suzizecat/defissolaire-v4/proto/power_supply/png/power_supply.png

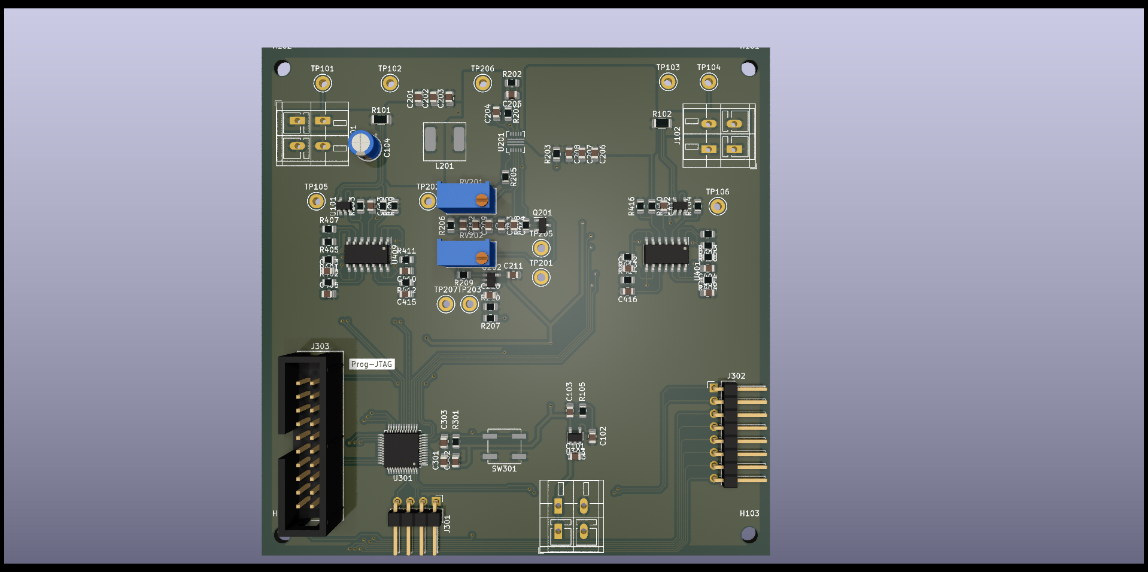
proto/power_supply/png/power_supply.png
