suzizecat/defissolaire-v4/README.md

# All-in-one (AIO) board for the "Défis solaires" contest of 2024.
Board files in `main/` folder.
