suzizecat/defissolaire-v4/dossier/defis_solaire_v4/dos/content.tex

% \input your content here.
\input{content/features.tex}
\input{content/power_archi.tex}
\input{content/solutions_selection.tex}
