suzizecat/defissolaire-v4/dossier/defis_solaire_v4/dos/refs/glossaries.tex

\newglossaryentry{dsn}{
    name={design},
    description={A particularly mighty piece of silicon which is supposed to work}
}

\newacronym{adc}{ADC}{Analog to Digital Converter}
\newacronym{sar}{SAR}{Successive Approximation Register}  
\newacronym{fsm}{FSM}{Finite State Machine}
\newacronym{cdc}{CDC}{Clock Domain Crossing}
\newacronym{msb}{MSB}{Most Significant Bit}
\newacronym{lsb}{LSB}{Least Significant Bit}
