suzizecat/defissolaire-v4/dossier/propo_regu_mppt.pdf

# Régulation d'alimentation

## Objectif final

L'objectif est la conception d'une alimentation DC/DC avec un MPPT pour un panneau de 14 cellules SunPower C60 montées en série.

L'accumulation d'énergie se fait sur une banque de condensateurs d'environ 10F pour une tension admissible de 20V.

Grandeur | Cellule | Panneau
VMPP | 0.574 | 8.036
IMPP | 5.83 | 5.83
PMPP | 3.34 | 46.85

## Proposition

Afin de réaliser cette fonction, je propose l'utilisation d'un régulateur boost synchrone (Référence TPS61178, U1 ). La tension de sortie de ce module est ajustable via un pont diviseur ( R5 et R3 ) dont la tension du point milieu sera ajustée à 1.2V . Le courant consommé par le pin FB ( U1:5 ) est négligeable (moins de 60nA).

Pour ajuster (élever) la tension de sortie par rapport à la tension par défaut du pont diviseur proposé (8.4V), je propose l'utilisation d'un transistor bipolaire Q1 pour "consommer" (sink) 1mA sur le point milieu ce qui, avec une résistance côté haut de 12k, correspond à une
élévation de 12V de | .
En admettant une tension | maximale de 1.66V pour 1mA consommé et en considérant la
tension | = 0.66 V du transistor Q1 , on a en principe :

VFB

VOUT

VOUT

VADJ

VBE

IC = β × IB

IC = β ×
R4

VADJ − VBE

R4 = β ×
IC

1.66 − 0.66

R4 = β × 1000

Donc, pour | on a | avec un courant | maximal inferieur à
2.5 A

D'un point de vue fréquence de mise à jour de la consigne, on peut supposer une fréquence lente vis à vis des fréquences de fonctionnement du régulateur. Par exemple, maximum, 1kHz (à comparer aux 200kHz-2MHz du switching).

## Problèmes potentiels

Est-ce que cette architecture est pertinente ?

Est-il possible/pertinent d'utiliser un BJT pour cette application, notemment lorsque des courants aussi faibles sont en jeu ?

Quelles seraient les précautions à prendre, notamment sur les paramètres du BJT et/ou de l'AOP ?

β ∈ [200; 400] | R4 ∈ [200e3; 400e3] | IB
μ

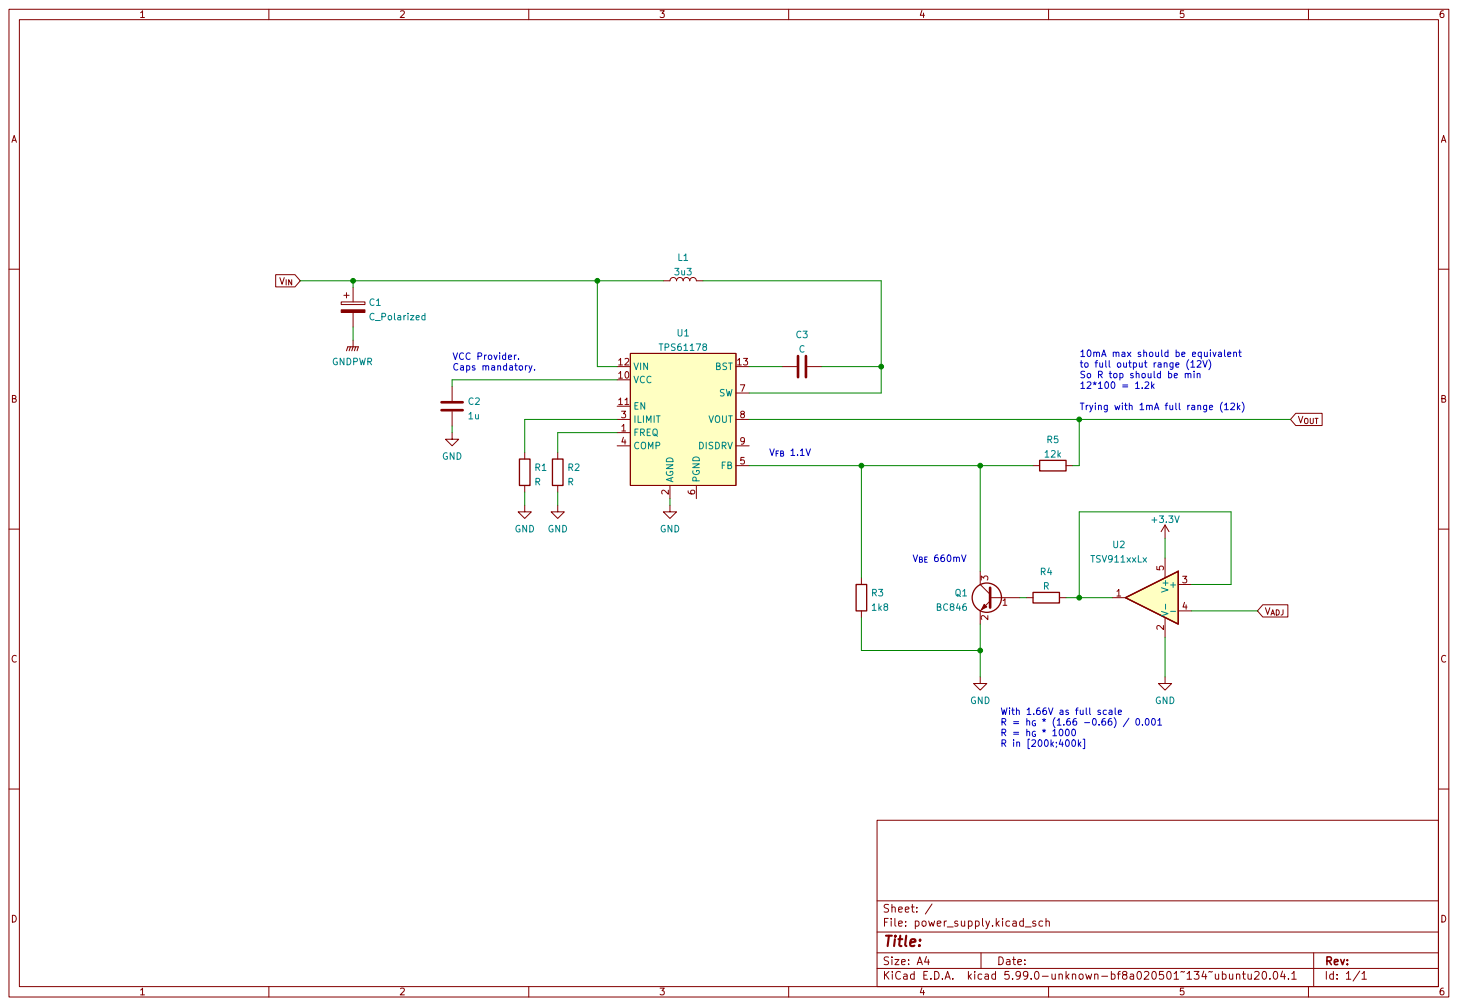
[picture p2: page 3]

10mA max should be equivalent
to full output range (12V)
So R top should be min 12*100 = 1.2k Trying with 1mA full range (12k)
