suzizecat/defissolaire-v4/dossier/alimentations/macros.tex

\newcommand{\drvcc}{\ensuremath{\mathrm{DRV_{CC}}}\xspace}
\newcommand{\intvcc}{\ensuremath{\mathrm{INTV_{CC}}}\xspace}
\newcommand{\bgate}{\ensuremath{\mathrm{BGATE}}\xspace}
\newcommand{\vdrv}{\ensuremath{\mathrm{V_{DRV}}}\xspace}
\newcommand{\vout}{\ensuremath{\mathrm{V_{OUT}}}\xspace}
\newcommand{\vin}{\ensuremath{\mathrm{V_{IN}}}\xspace}
\newcommand{\iin}{\ensuremath{\mathrm{I_{IN}}}\xspace}

\newcommand{\driver}{TPS4306x\xspace}
\newcommand{\mosfet}{TK4R3E06PL\xspace}

\newcommand{\fsw}{\ensuremath{\mathnormal{f_{sw}}}\xspace}
\newcommand{\csw}{\ensuremath{\mathnormal{C_{sw}}}\xspace}
\newcommand{\isw}{\ensuremath{\mathnormal{I_{sw}}}\xspace}
\newcommand{\iswavg}{\ensuremath{\overline{\mathnormal{I_{sw}}}}\xspace}
\newcommand{\psw}{\ensuremath{\mathnormal{P_{sw}}}\xspace}

\newcommand{\trise}{\ensuremath{\mathnormal{t_{R}}}\xspace}
\newcommand{\qsw}{\ensuremath{\mathrm{Q_{sw}}}\xspace}
\newcommand{\rdson}{\ensuremath{\mathrm{R_{DS(on)}}}\xspace}
\newcommand{\rgate}{\ensuremath{\mathrm{R_{G}}}\xspace}
\newcommand{\rdrv}{\ensuremath{\mathrm{R_{DRV}}}\xspace}
