suzizecat/defissolaire-v4/dossier/poulpator.png

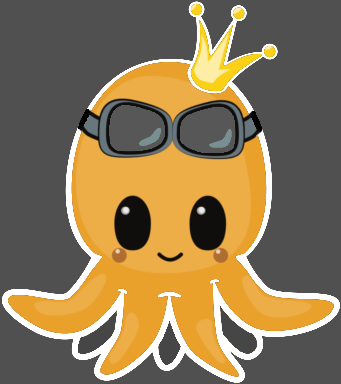
dossier/poulpator.png
