suzizecat/defissolaire-v4/main/bom-ordered/JFAR-BOM-DSv4.xlsx

Reference | Value | Qty | Mouser SKU | MPN
BZ601 | PKLCS1212E4001-R1 | 1 | 81-PKLCS1212E4001 | PKLCS1212E4001-R1
C201,C416 | 4.7u | 2 | 187-CL21B475KAFNNNE | CL21B475KAFNNNE
C202,C203,C205,C209,C409,C417,C501,C502,C503,C504,C505,C603,C901,C1001,C1101,C1201,C1301,C1401,C1501,C1601 | 100n | 20 | 187-CL21B104KACNFNC | CL21B104KACNFNC
C204,C211,C301,C302,C304,C305,C306,C307,C401,C402,C403,C404,C405,C406,C408 | 10u | 21 | 187-CL21A106KBYQNNE | CL21A106KBYQNNE
C206,C207 | 22u | 2 | 187-CL21A226MAYNNWE | CL21A226MAYNNWE
C208,C903,C1003,C1103,C1203,C1303,C1403 | 1u | 7 | 187-CL21B105KLFVPNE | CL21B105KLFVPNE
C210 | 10n | 1 | 187-CL21B103KCANNND | CL21B103KCANNND
C303,C308,C407 | 220u | 5 | 80-A759KR227M1VAAE24 | A759KR227M1VAAE024
C309,C310,C410,C411 | 2.2u | 6 | 187-CL21B225KBYNNWE | CL21B225KBYNNWE
C312,C412 | 68n | 3 | 187-CL21B683KBCWPNC | CL21B683KBCWPNC
C313,C413 | 100p | 3 | 187-CL21C101JBANNND | CL21C101JBANNND
C314,C414 | 680n | 3 | 187-CL21B684JOFNNNE | CL21B684JOFNNNE
C315,C415 | 4.7n | 3 | 187-CL21C472JAFNNNE | CL21C472JAFNNNE
C506,C507 | 18p | 2 | 81-GRM21A5C2J180FWAD | GRM21A5C2J180FWA1D
D401,D402,D403,D404,D901,D902,D1001,D1002,D1101,D1102,D1201,D1202,D1301,D1302,D1401,D1402 | B5819W-TP | 16 | 833-B5819W-TP | B5819W-TP
J1701,J1801 | Conn_02x08_Odd_Even | 5 | 538-22-28-4162 | 22-28-4162
J608 | USB_B_Micro | 1 | 538-47346-0001 | 47346-0001
L201 | 6.8u | 1 | 810-VLS3015CX6R8M1 | VLS3015CX-6R8M-1
L301 | 10u | 2 | 994-MSD1514-103MED | MSD1514-103MED
L401 | 4.7u | 1 | 994-MSD1260T-472MLD | MSD1260T-472MLD
Q301,Q401 | IXTP28P065T | 3 | 747-IXTP28P065T | IXTP28P065T
Q302,Q402,Q901,Q902,Q1001,Q1002,Q1101,Q1102,Q1201,Q1202,Q1301,Q1302,Q1401,Q1402 | TK4R3E06PL | 15 | 757-TK4R3E06PLS1X | TK4R3E06PL
Q403,Q406,Q601,Q1501,Q1601 | IRLML0030 | 5 | 942-IRLML0030TRPBF | IRLML0030TRPBF
Q404,Q405 | FDS6681Z | 2 | 512-FDS6681Z | FDS6681Z
R201,R206,R415 | 33k | 3 | 71-CRCW0805-33K-E3 | CRCW080533K0FKEA
R202,R416 | 5.6k | 2 | 71-CRCW08055K60FKEA | CRCW08055K60FKEA
R203,R205 | 150k | 3 | 71-CRCW0805-150K-E3 | CRCW0805150KFKEA
R207 | 20k | 1 | 71-CRCW0805-20K-E3 | CRCW080520K0FKEA
R301,R402 | 6m | 3 | 71-WSL20106L000FEA | WSL20106L000FEA
R302 | 3m | 2 | 71-WSL20103L000FEA | WSL20103L000FEA
R303,R403 | 18k | 3 | 71-CRCW080518K0FKEA | CRCW080518K0FKEA
R304,R407,R408 | 4.7k | 4 | 71-CRCW0805-4.7K-E3 | CRCW08054K70FKEA
R305 | 200k | 2 | 71-CRCW0805-200K-E3 | CRCW0805200KFKEA
R307,R410 | 120k | 3 | 71-CRCW0805120KFKEA | CRCW0805120KFKEA
R309,R412 | 22k | 3 | 71-CRCW0805-22K-E3 | CRCW080522K0FKEA
R401 | 18m | 1 | 71-WSL2010R0180FEA | WSL2010R0180FEA
R404,R406 | 68k | 2 | 71-CRCW080568K0FKEAC | 71-CRCW080568K0FKEAC
R405,R409,R413,R414,R501,R502 | 10k | 6 | 71-CRCW0805-10K-E3 | CRCW080510K0FKEA
R503,R1501,R1502,R1503,R1504,R1505,R1506,R1601,R1602,R1603,R1604,R1605,R1606 | 3k3 | 13 | 71-CRCW0805-3.3K-E3 | CRCW08053K30FKEA
R601,R605,R606 | 1k | 3 | 71-CRCW0805-1.0K-E3 | CRCW08051K00FKEA
R602,R901,R902,R1001,R1002,R1101,R1102,R1201,R1202,R1301,R1302,R1401,R1402,R1507,R1607 | 100k | 15 | 71-CRCW0805-100K-E3 | CRCW0805100KFKEA
R603,R604 | 27 | 2 | 71-CRCW080527R0FKEA | CRCW080527R0FKEA
RV301,RV401 | 100k (10k) | 3 | 652-3296W-1-104LF | 3296W-1-104LF
SW501 | B3SL-1022P | 1 | 653-B3SL-1022P | B3SL-1022P
U201,U403 | TSV911xxLx | 3 | 511-TSV911ILT | TSV911ILT
U202 | LMR51430 | 1 | 595-LMR51430XDDCR | LMR51430XDDCR
U203 | LDK130M33R | 1 | 511-LDK130M33R | LDK130M33R
U301,U401 | LT8710 | 3 | 584-LT8710IFE#PBF | LT8710IFE#PBF
U402 | TMCS1101 | 1 | 595-TMCS1101A3UQDRQ1 | TMCS1101A3UQDRQ1
U501 | STM32L476RGTx | 2 | 511-STM32L476RGT6 | STM32L476RGT6
U601 | FT230XQ | 1 | 895-FT230XQ-R | FT230XQ-R
U901,U1001,U1101,U1201,U1301,U1401 | LM2105 | 6 | 595-LM2105DSGR | LM2105DSGR
Y501 | 8MHz | 1 | 520-80-18-30-JGM-TR | ECS-80-18-30-JGM-TR
