suzizecat/defissolaire-v4/librairies/3d/PKLCS1212E4001-R1--3DModel-STEP-56544.STEP

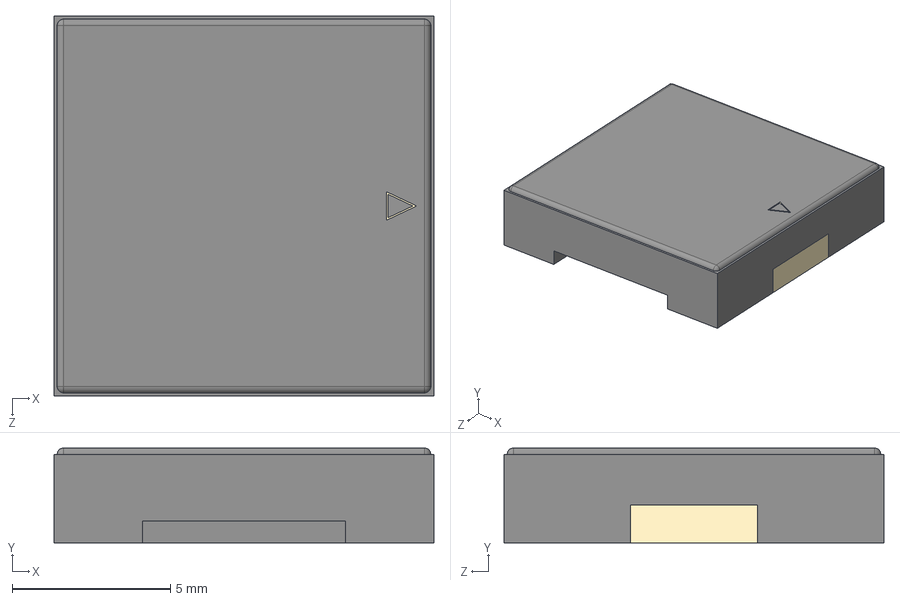
[picture p4: CAD file, 2024-04-25]
librairies/3d/PKLCS1212E4001-R1--3DModel-STEP-56544.STEP
12.0 x 3.00 x 12.0 mm
