suzizecat/defissolaire-v4/librairies/3d/Coilcraft-MSD1260T.step

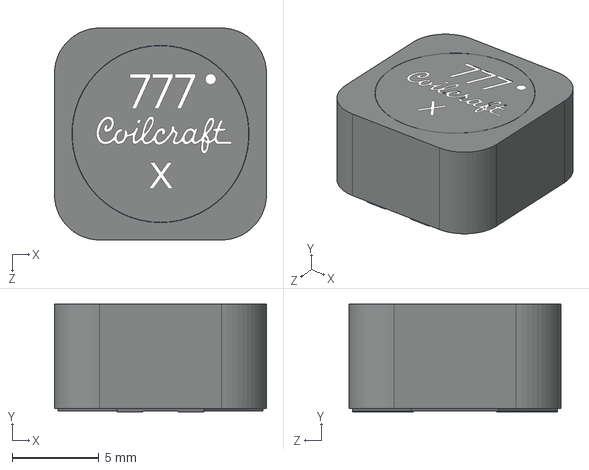
[picture p5: CAD file, 2024-04-25]
librairies/3d/Coilcraft-MSD1260T.step
12.2 x 6.20 x 12.2 mm
