suzizecat/defissolaire-v4/librairies/3d/236-402.stp

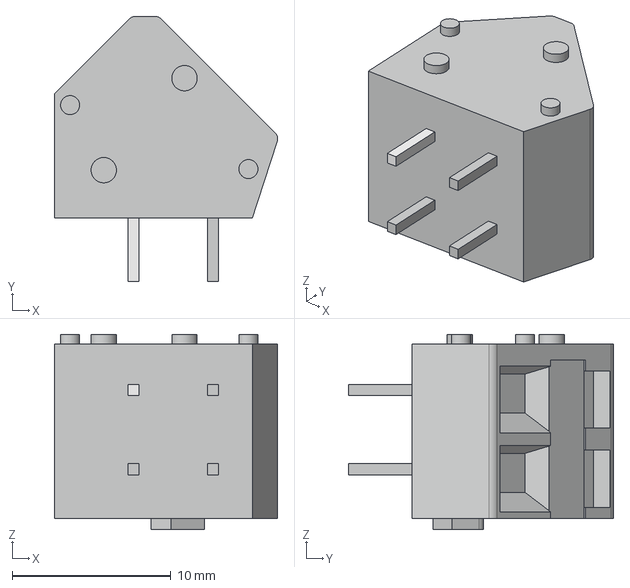
[picture p6: CAD file, 2023-03-29]
librairies/3d/236-402.stp
14.1 x 16.7 x 12.3 mm
