suzizecat/defissolaire-v4/librairies/3d/RTE0016E.stp

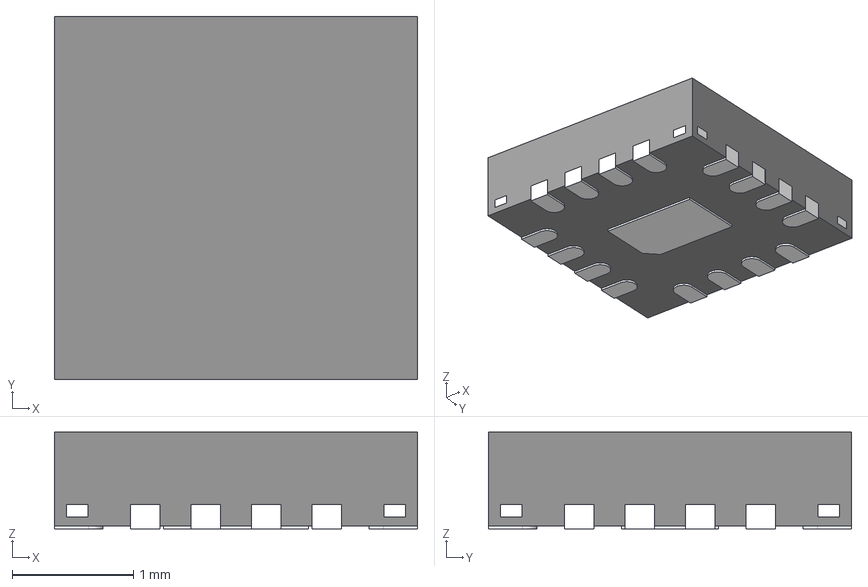
[picture p7: CAD file, 2023-03-29]
librairies/3d/RTE0016E.stp
3.00 x 3.00 x 0.8 mm
FRAME
