suzizecat/defissolaire-v4/pdf/defis_solaires_v4.pdf

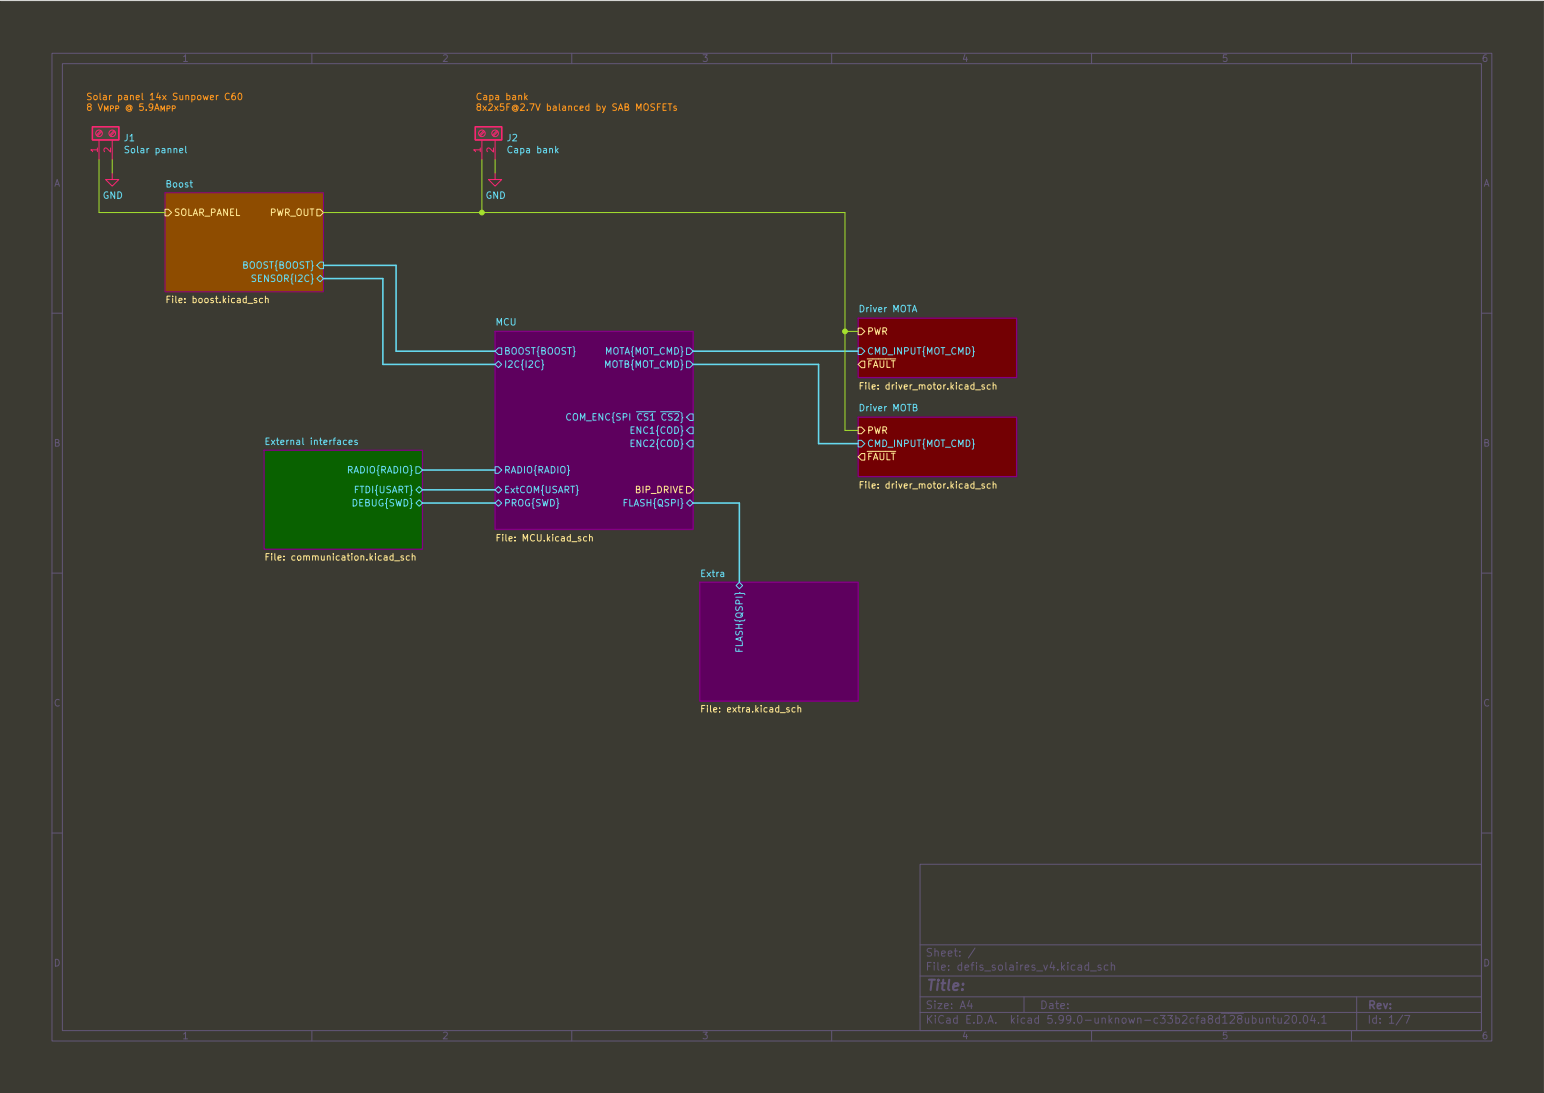
[picture p8: page 1]

Capa bank
8x2x5F@2.7V balanced by SAB MOSFETs

~FAULT~ Extra File: extra.kicad_sch FLASH{QSPI} MCU

MOTB{MOT_CMD} External interfaces File: communication.kicad_sch FTDI{USART}

RADIO{RADIO}
ExtCOM{USART}
File: MCU.kicad_sch PROG{SWD}

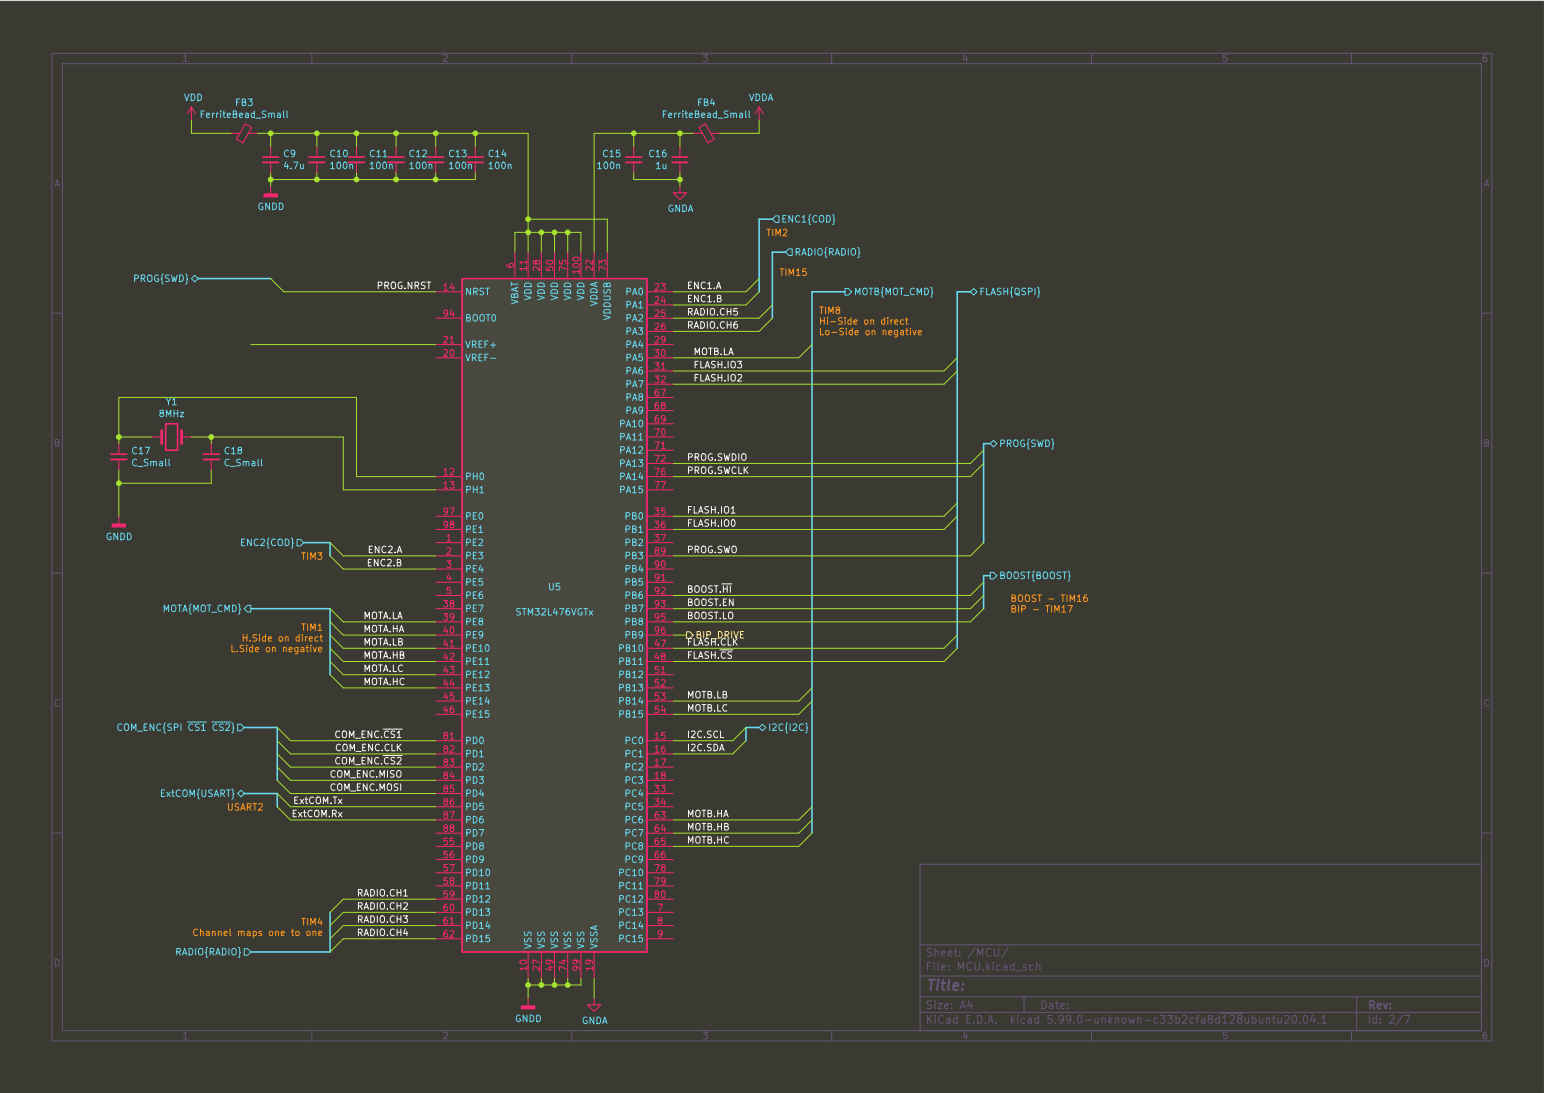
[picture p9: page 2]

FLASH.IO2 FLASH.IO3 PROG.SWCLK

TIM4 Channel maps one to one TIM1 H.Side on direct L.Side on negative

FLASH.IO0 FLASH.IO1 MOTA.LC

BOOST.EN MOTA.HB MOTA.LB MOTA.HA MOTA.HC

File: MCU.kicad_sch Sheet: /MCU/
Id: 2/7 Title:

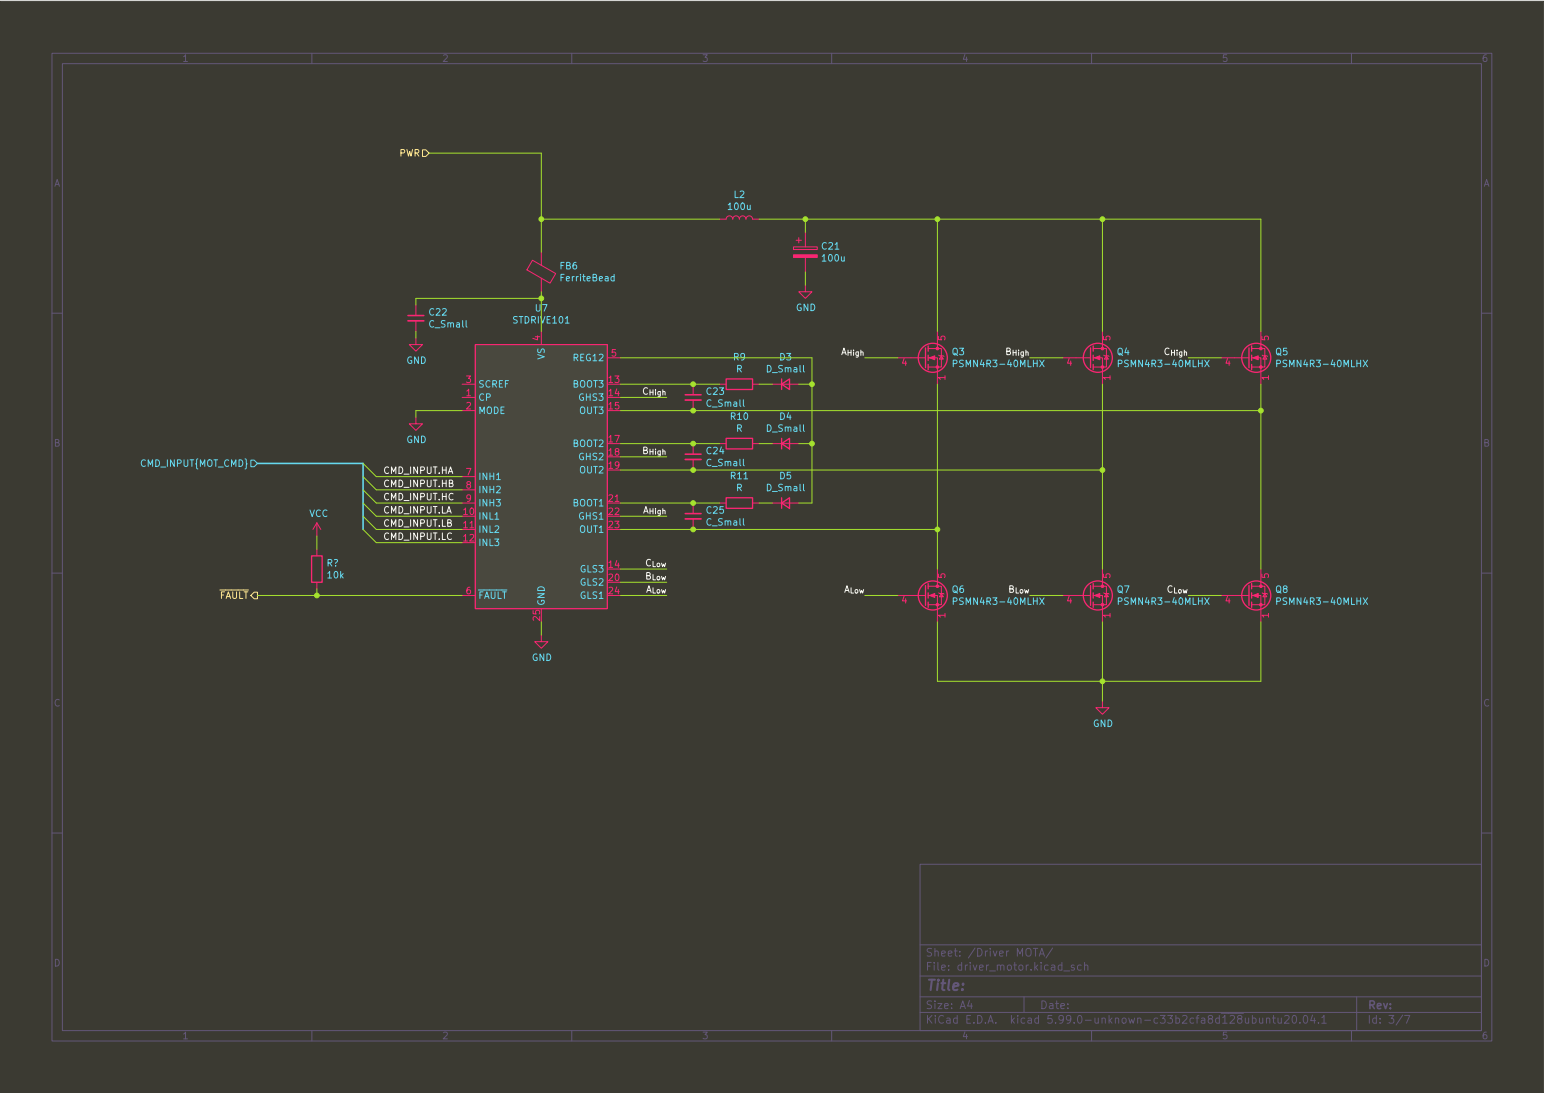
[picture p10: page 3]

File: driver_motor.kicad_sch Sheet: /Driver MOTA/
Id: 3/7 Title:

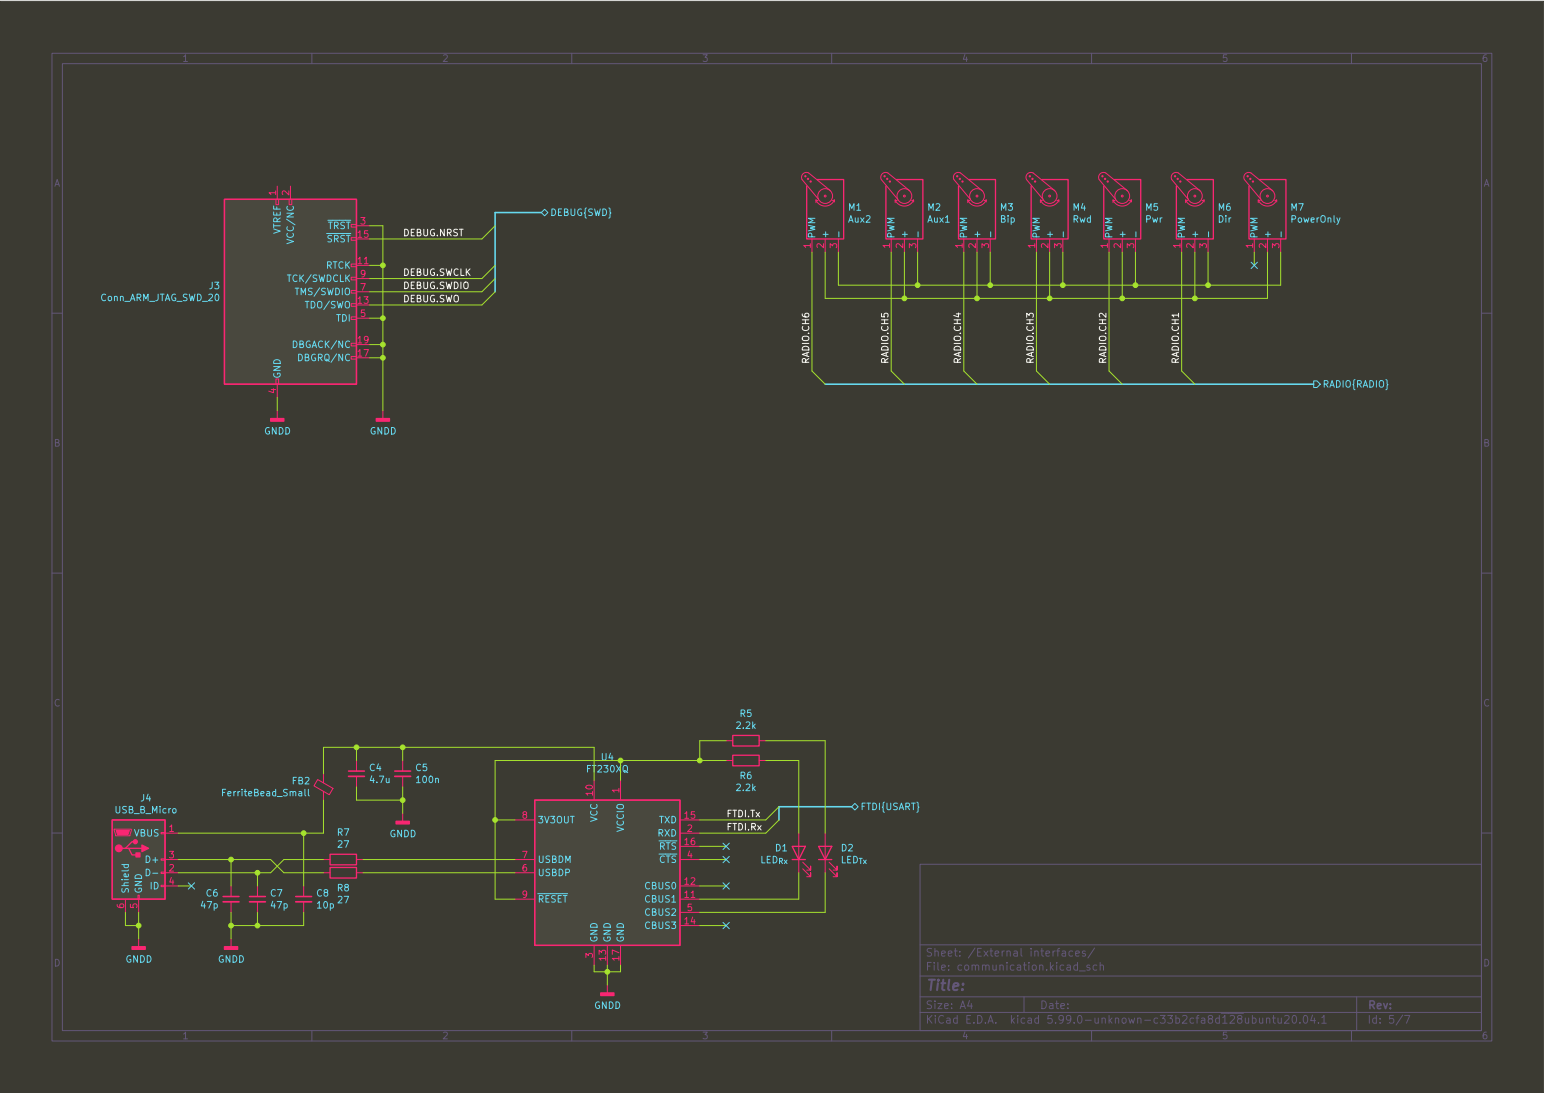
[picture p11: page 4]

1 RTCK 11 TDO/SWO 13 ~SRST~15 DBGRQ/NC 17 DBGACK/NC 19 VCC/NC

4 TDI 5 TMS/SWDIO 7 TCK/SWDCLK 9

1 VCC 10 CBUS1 11 CBUS0 12 GND 13 CBUS3 14 TXD 15 ~RTS 16 GND 17 RXD 2 GND

FTDI.Tx FTDI.Rx

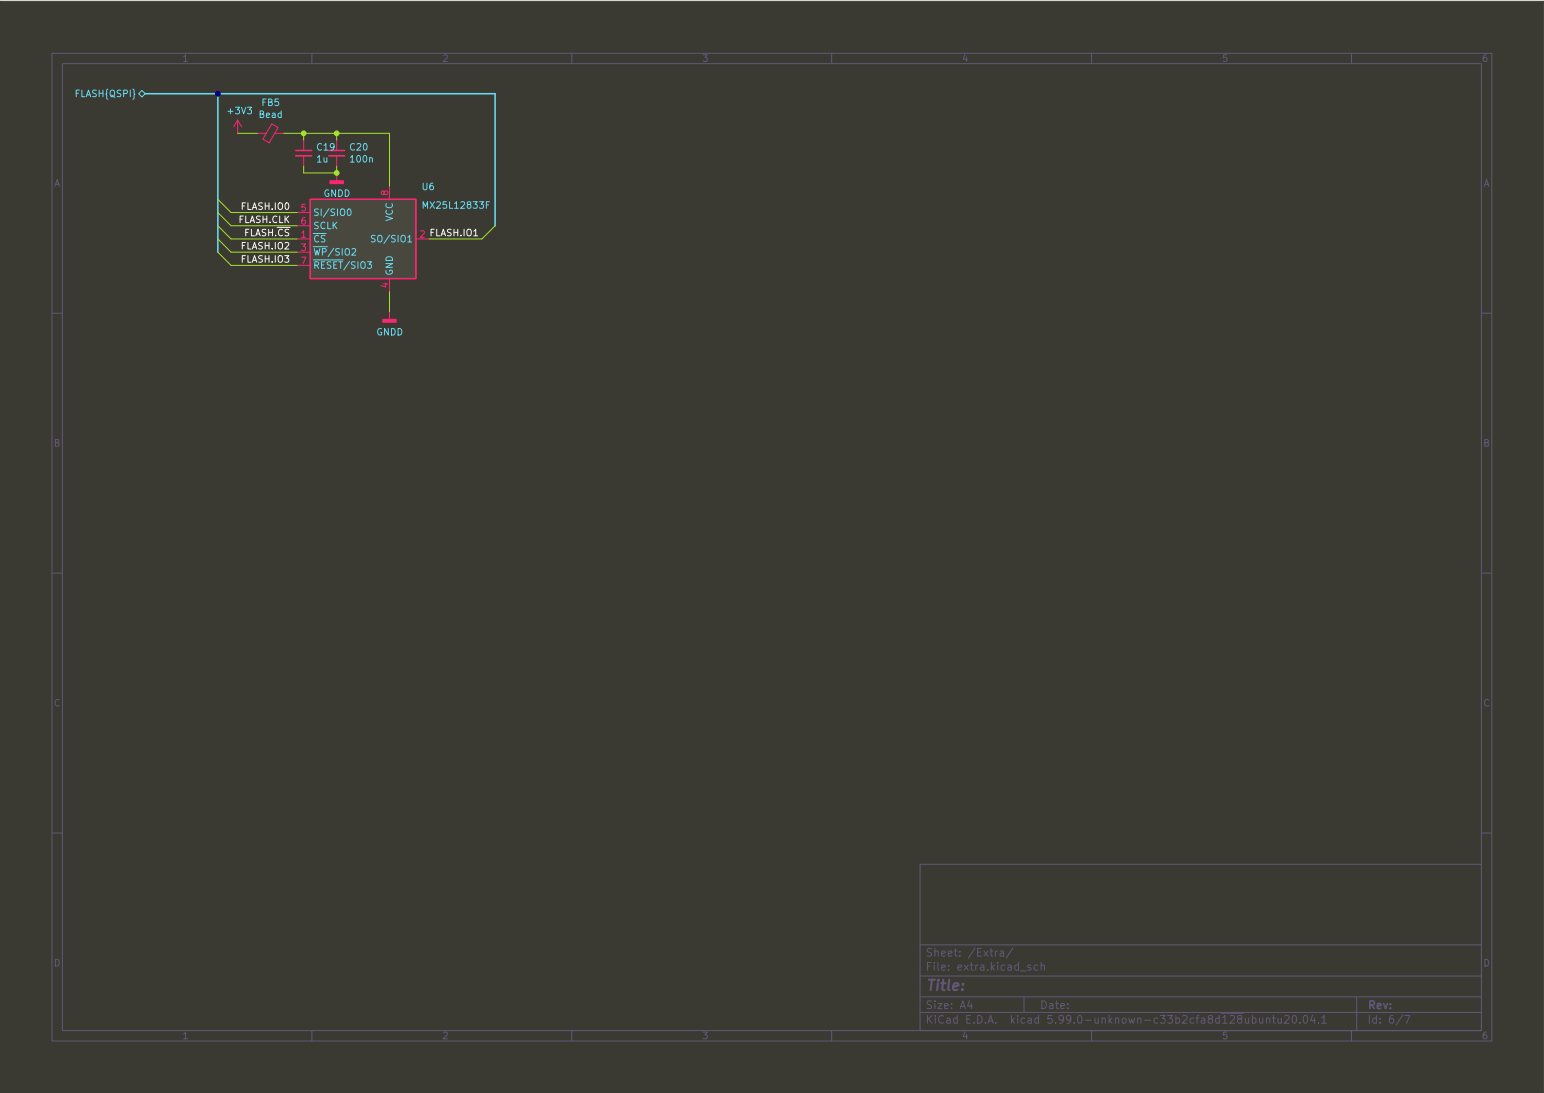
[picture p12: page 5]

4 SI/SIO0 5 SCLK 6 ~RESET~/SIO3 7 VCC

File: extra.kicad_sch Sheet: /Extra/
Id: 6/7 Title:

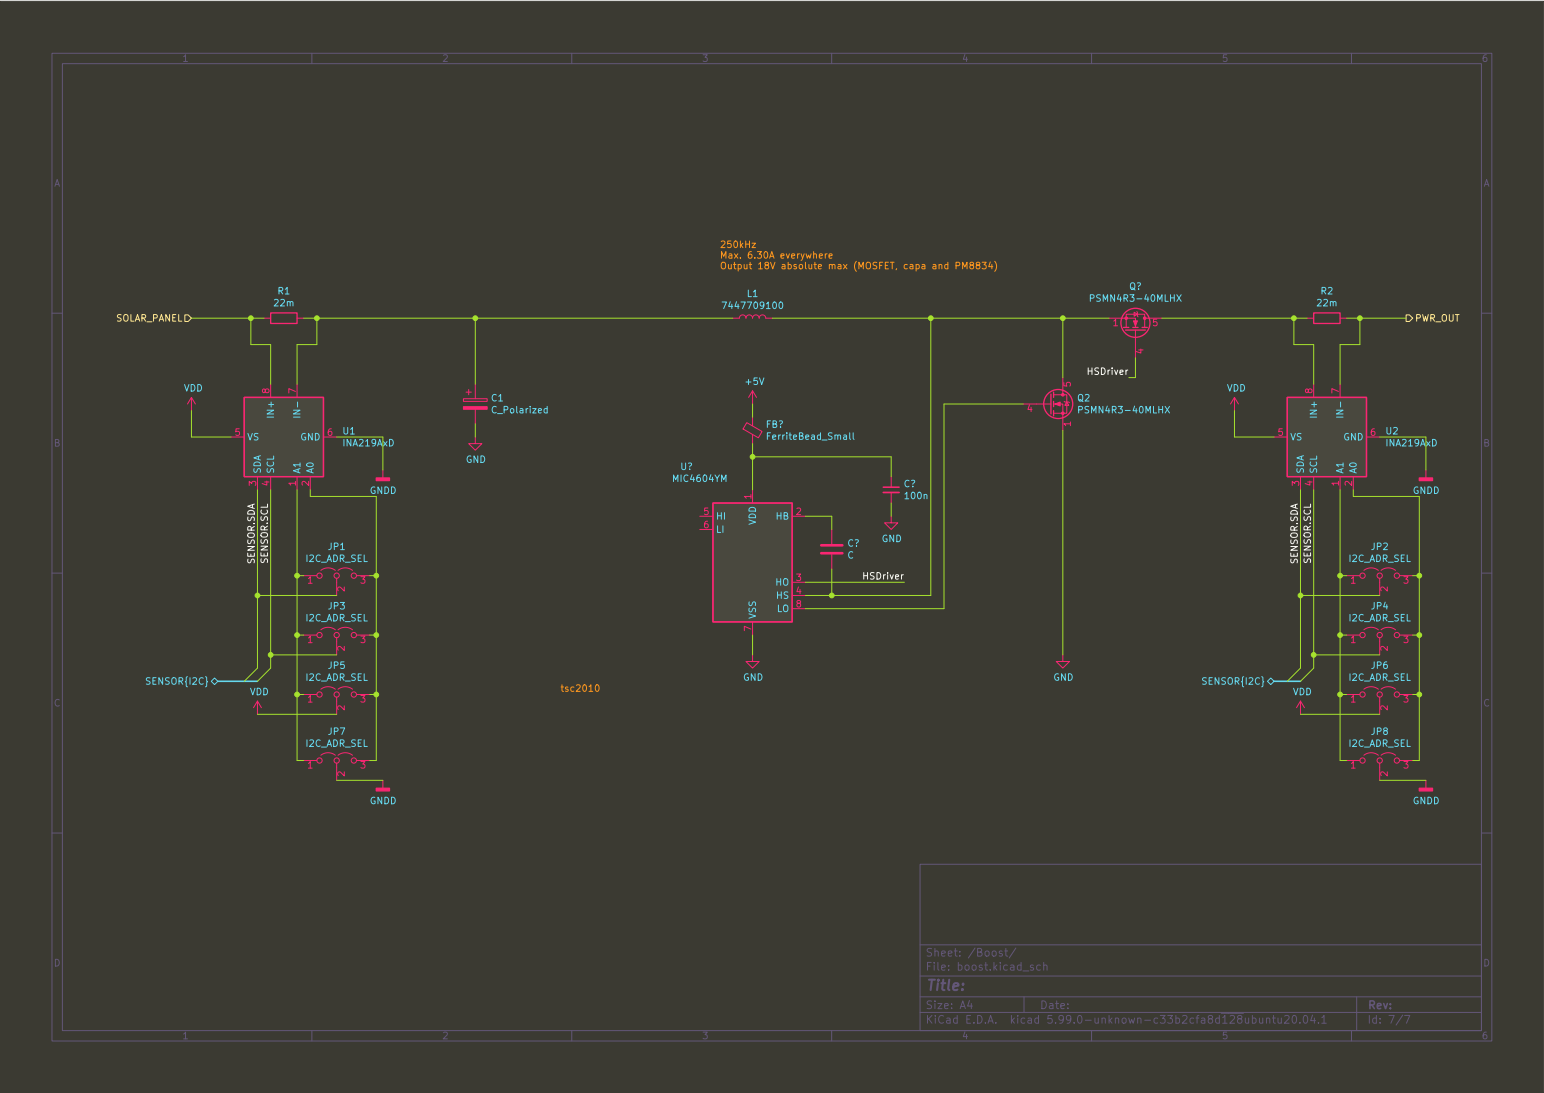
[picture p13: page 6]

Output 18V absolute max (MOSFET, capa and PM8834)

4 VS 5 GND 6 IN- 7 IN+

File: boost.kicad_sch Sheet: /Boost/
Id: 7/7 Title:

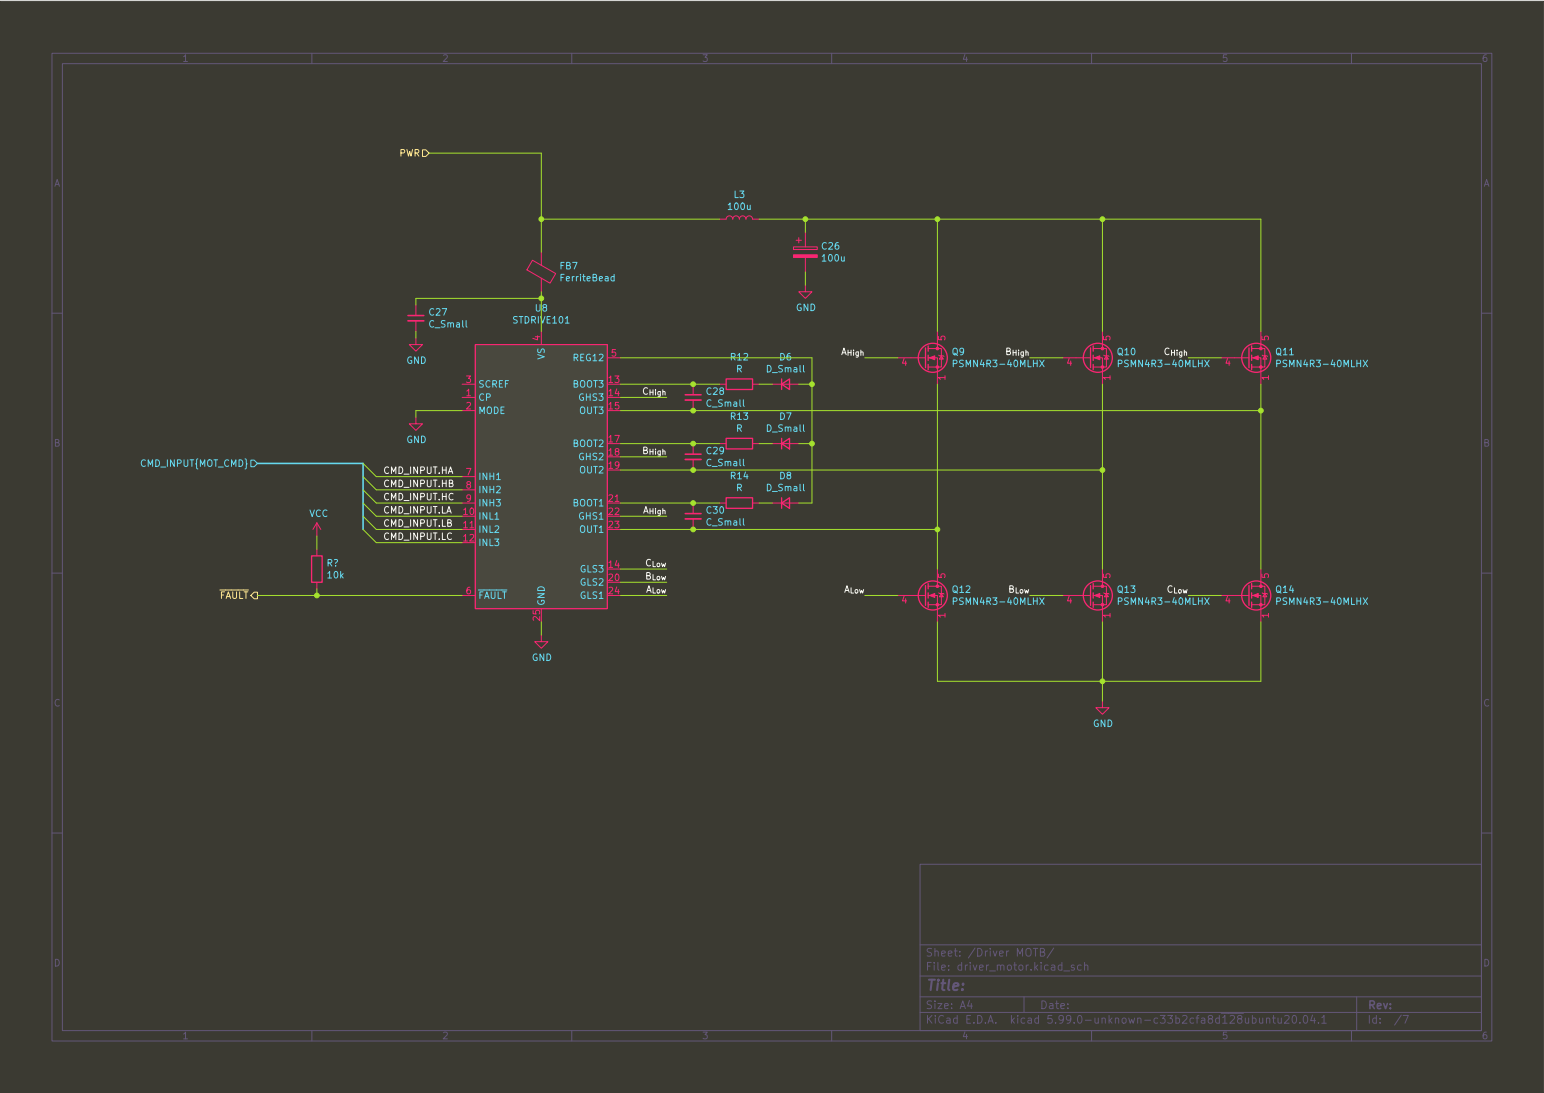
[picture p14: page 7]

File: driver_motor.kicad_sch Sheet: /Driver MOTB/
Id: /7 Title:
