suzizecat/defissolaire-v4/main/pdf/dsv4.pdf

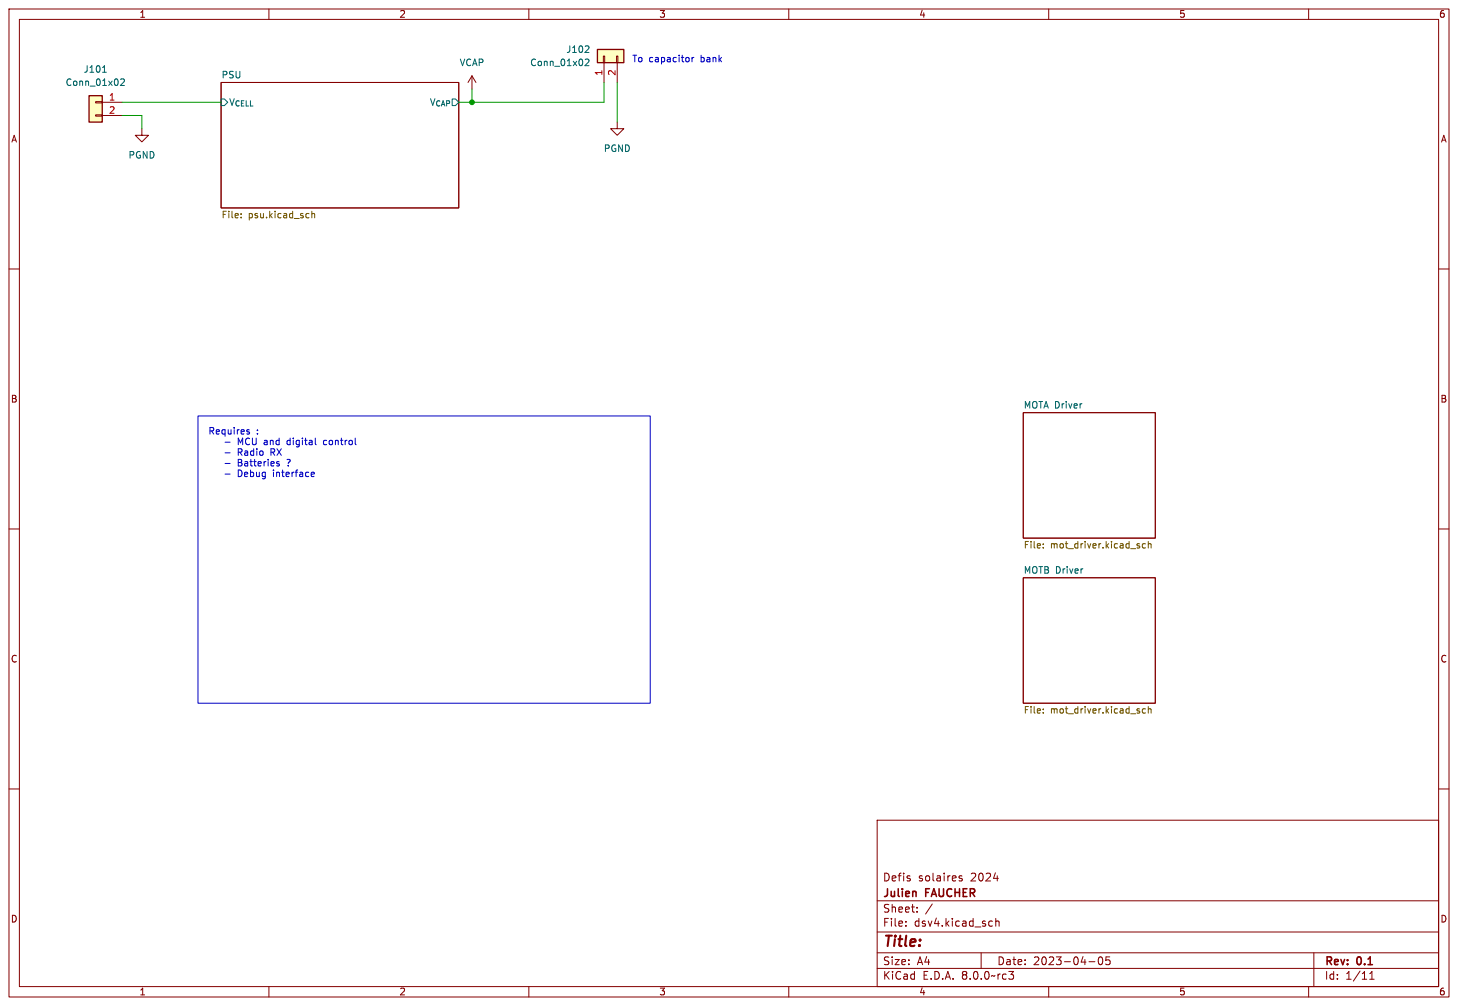
[picture p15: page 1]

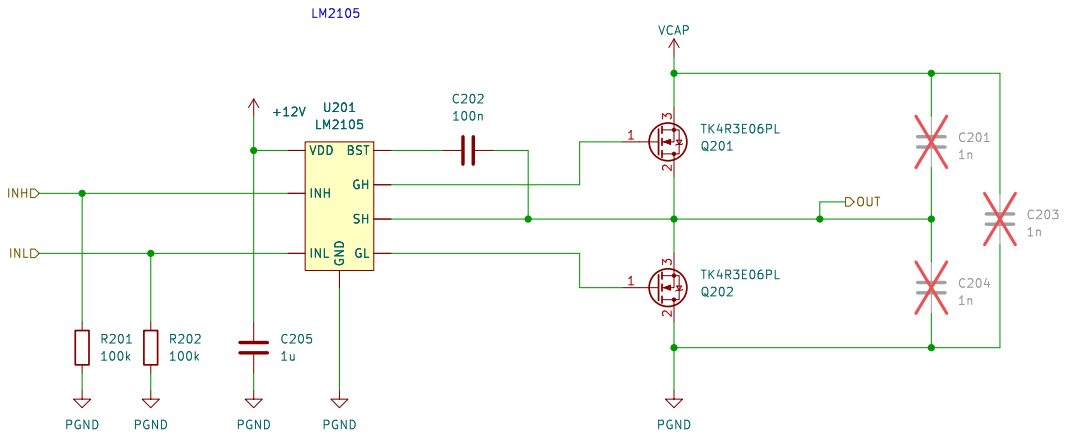
[picture p16: page 2]

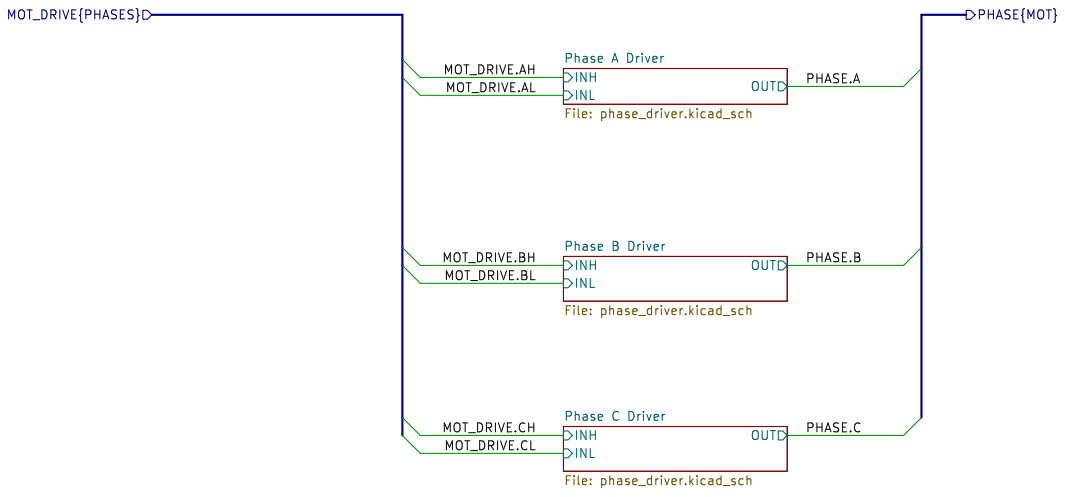
[picture p17: page 3]

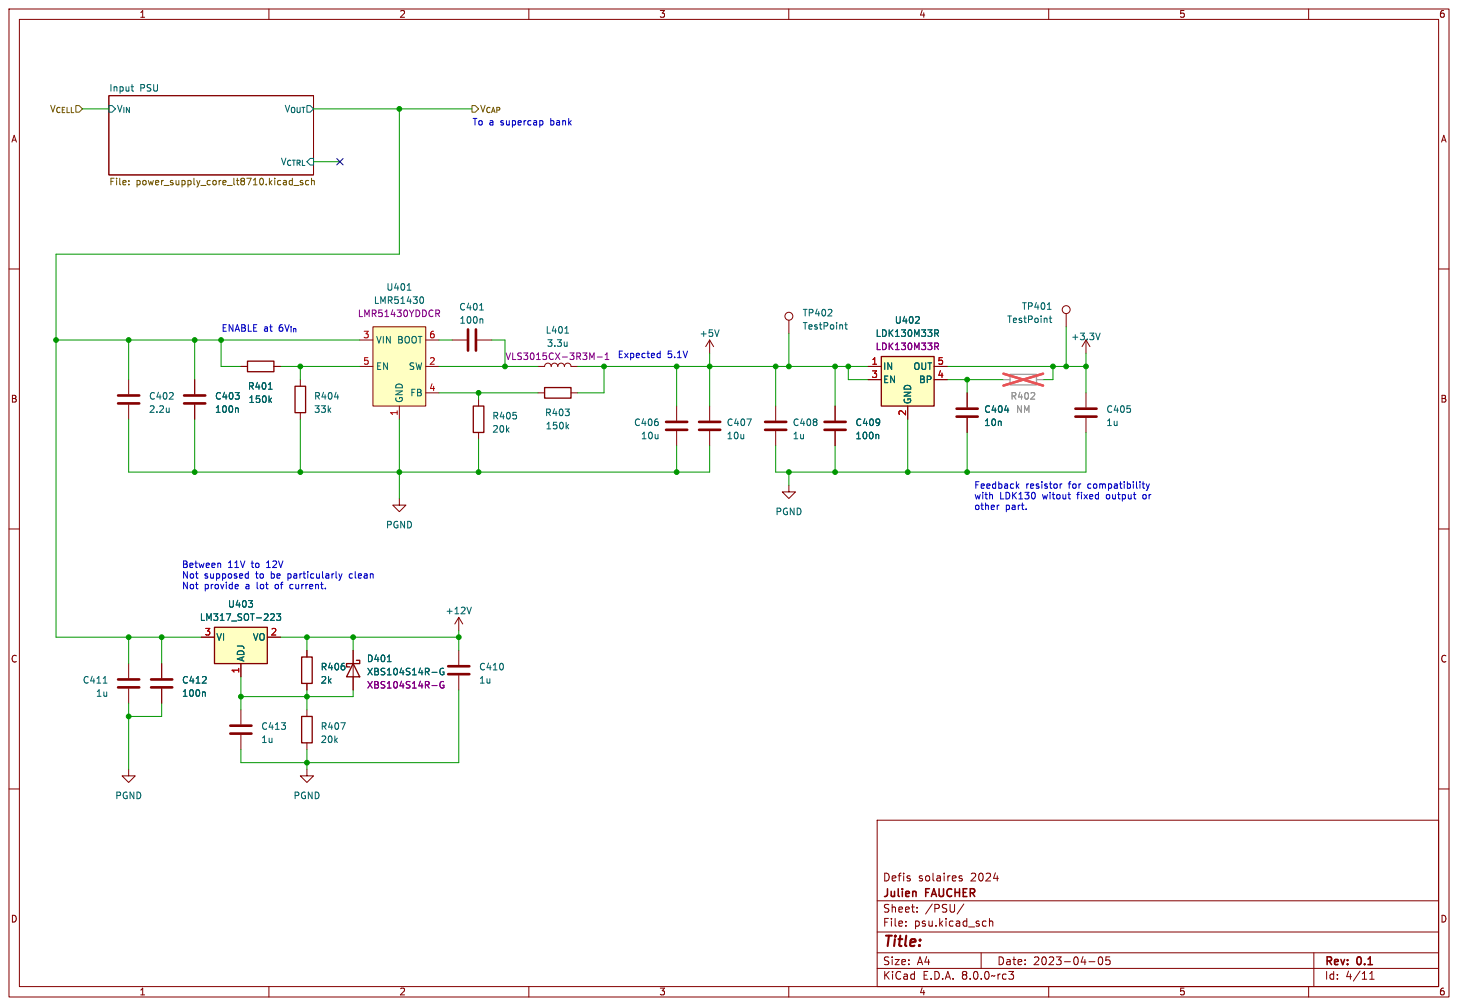
[picture p18: page 4]

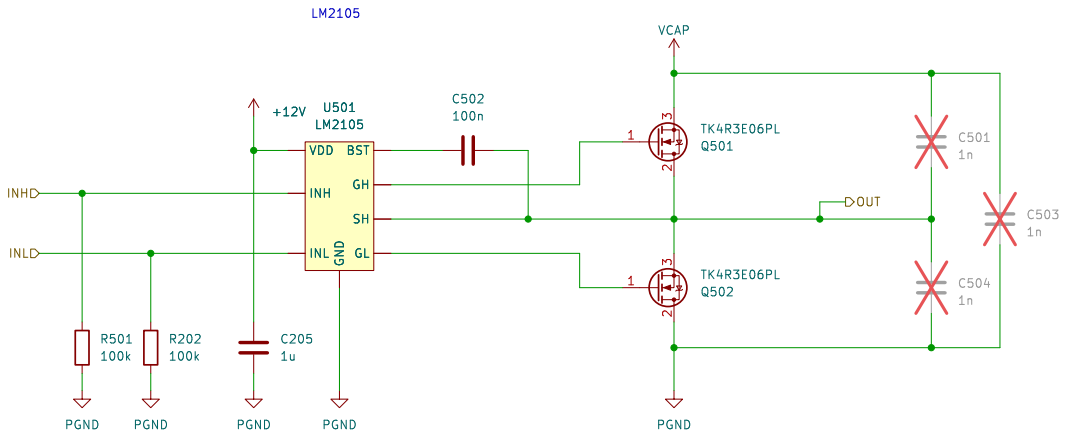
[picture p19: page 5]

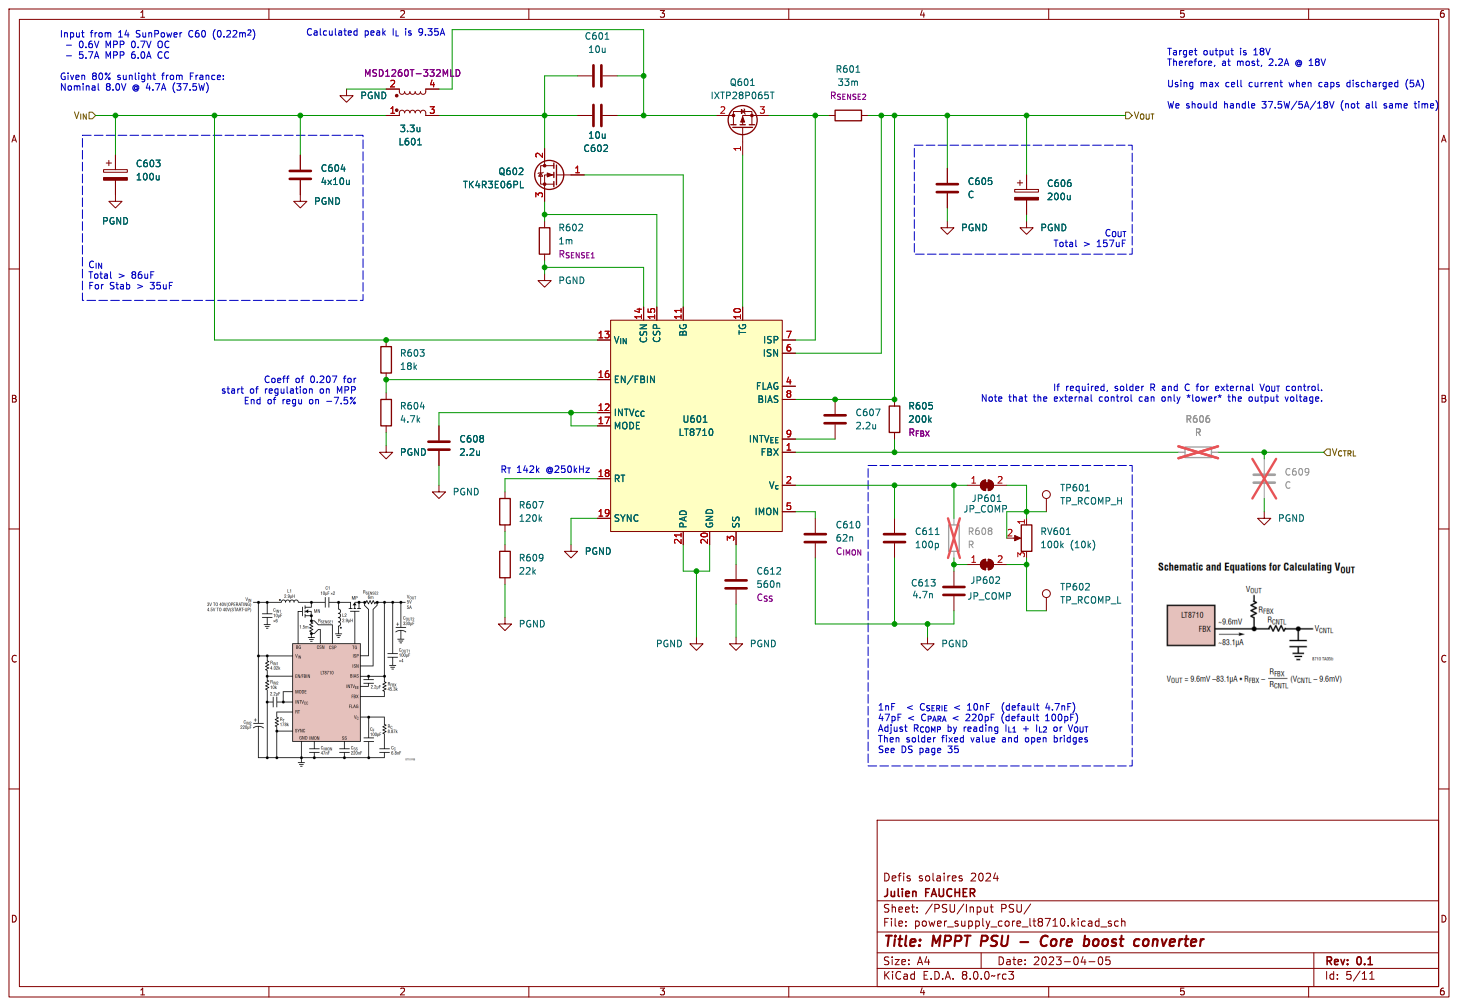
[picture p20: page 6]

End of regu on -7.5%

Adjust R_{COMP} by reading I_{L1}+ I_{L2}or V_{OUT} Then solder fixed value and open bridges See DS page 35

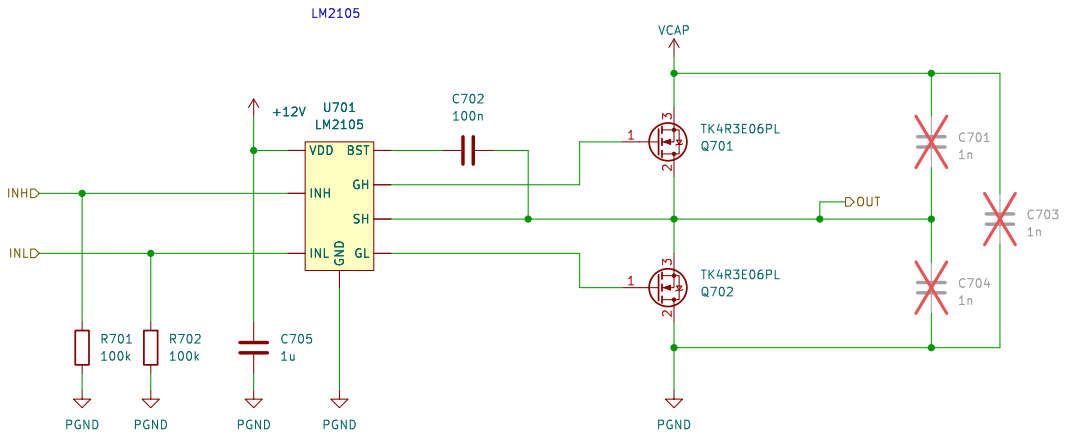
[picture p21: page 7]

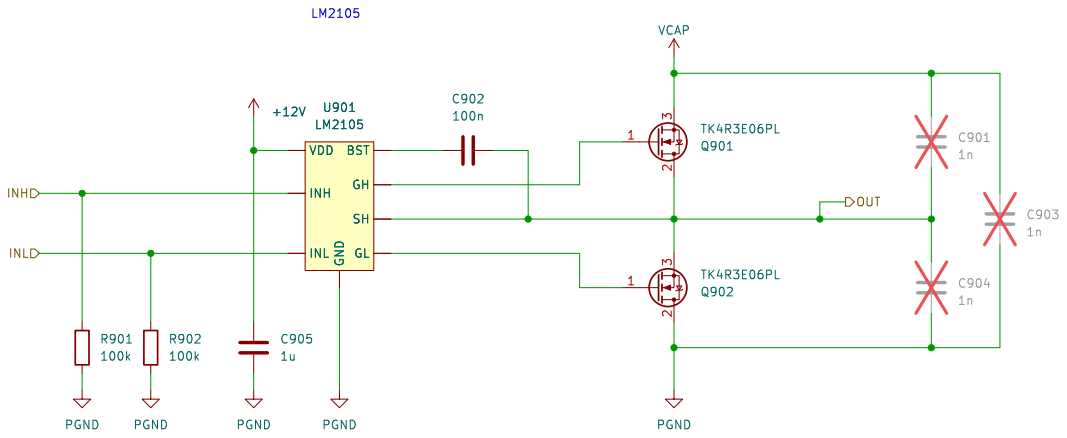
[picture p22: page 9]

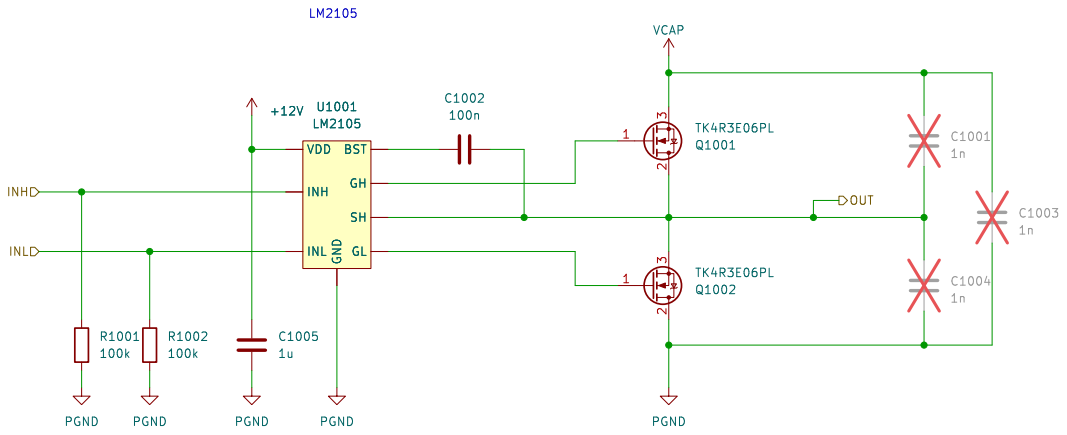
[picture p23: page 10]

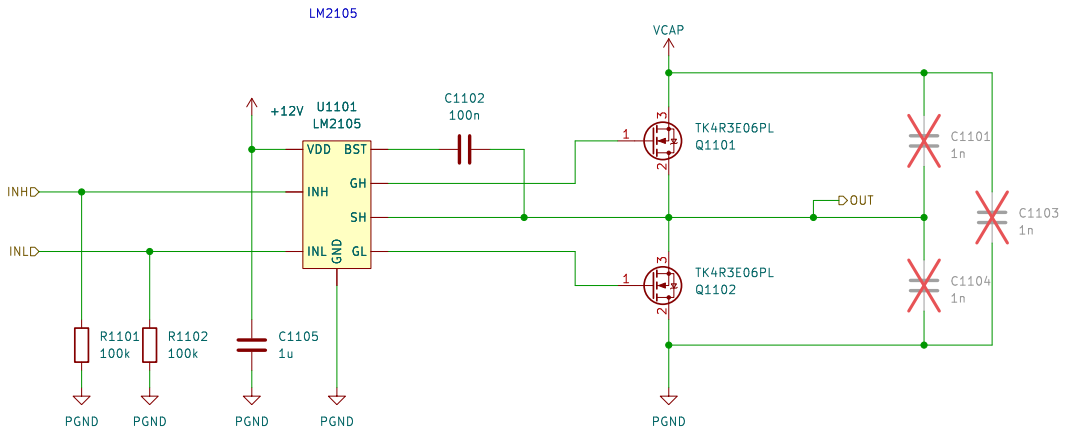
[picture p24: page 11]
