suzizecat/defissolaire-v4/proto/power_supply/pdf/power_supply.pdf

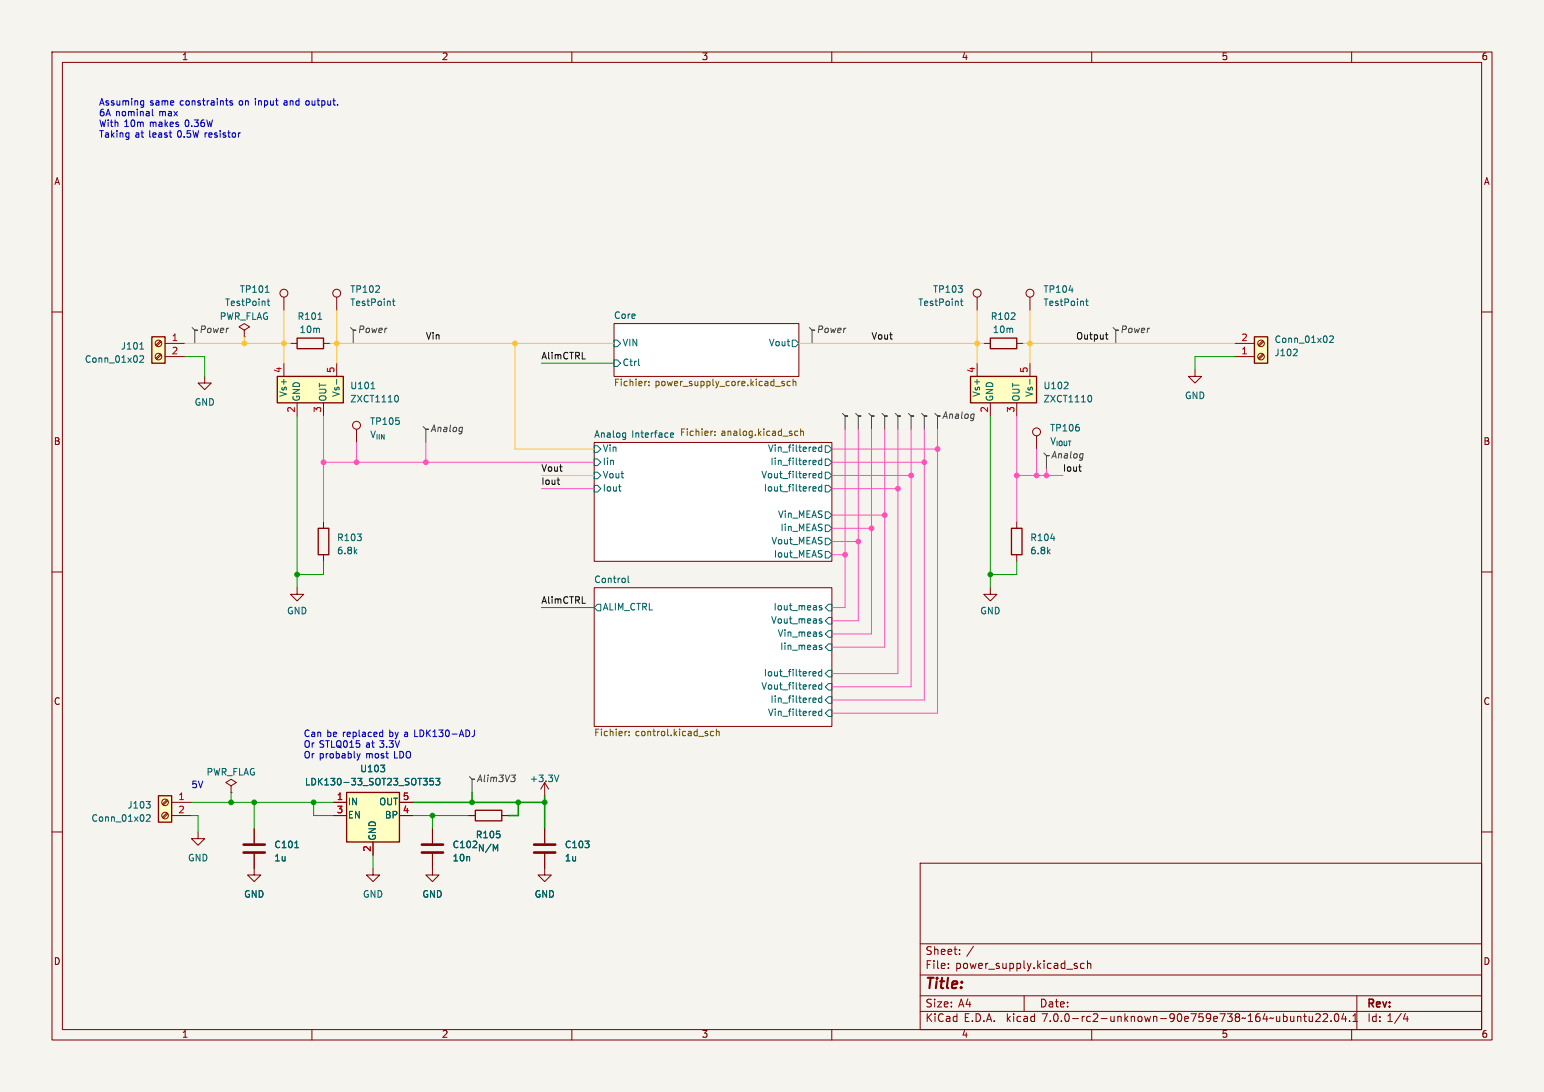
[picture p25: page 1]

Iin Analog Interface Fichier: analog.kicad_sch
Vin

2 EN 3 BP 4 OUT 5 GND

Id: 1/4 Title: File: power_supply.kicad_sch Sheet: /

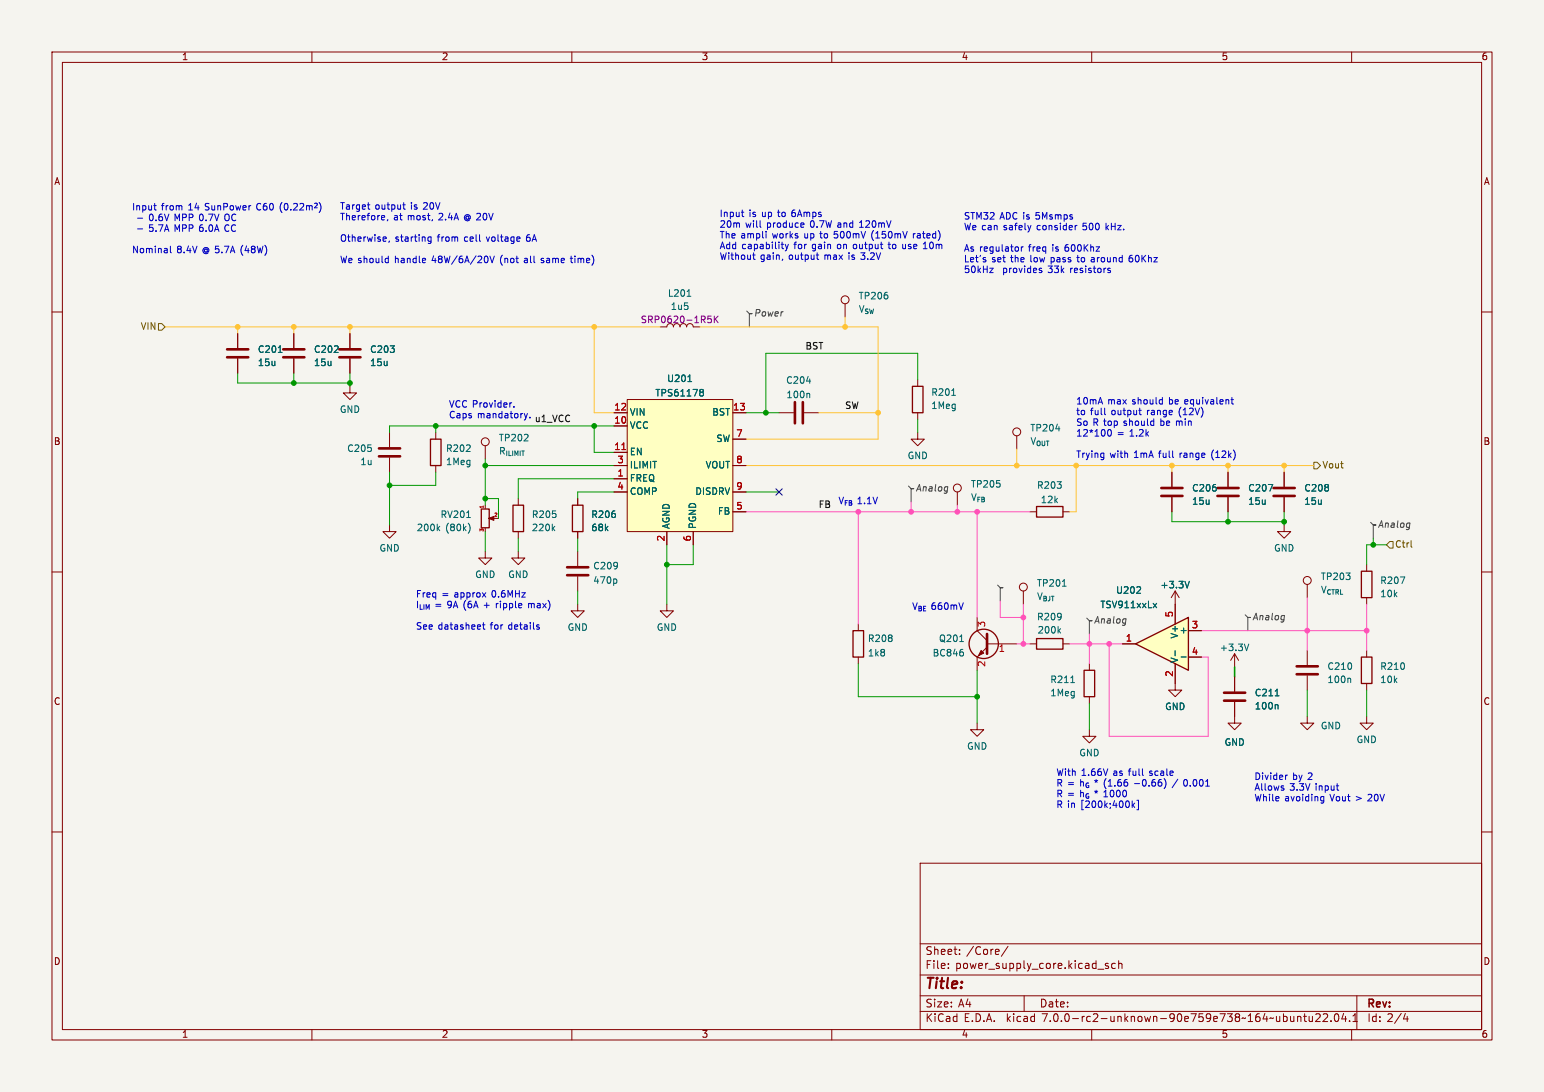
[picture p26: page 2]

Input is up to 6Amps 20m will produce 0.7W and 120mV

6 SW 7 VOUT 8 DISDRV 9 U201 TPS61178 TP202 R_{ILIMIT} R206

10mA max should be equivalent
to full output range (12V) So R top should be min

12*100 = 1.2k Trying with 1mA full range (12k)

Freq = approx 0.6MHz
I_{LIM} = 9A (6A + ripple max) See datasheet for details

Id: 2/4 Title: File: power_supply_core.kicad_sch Sheet: /Core/

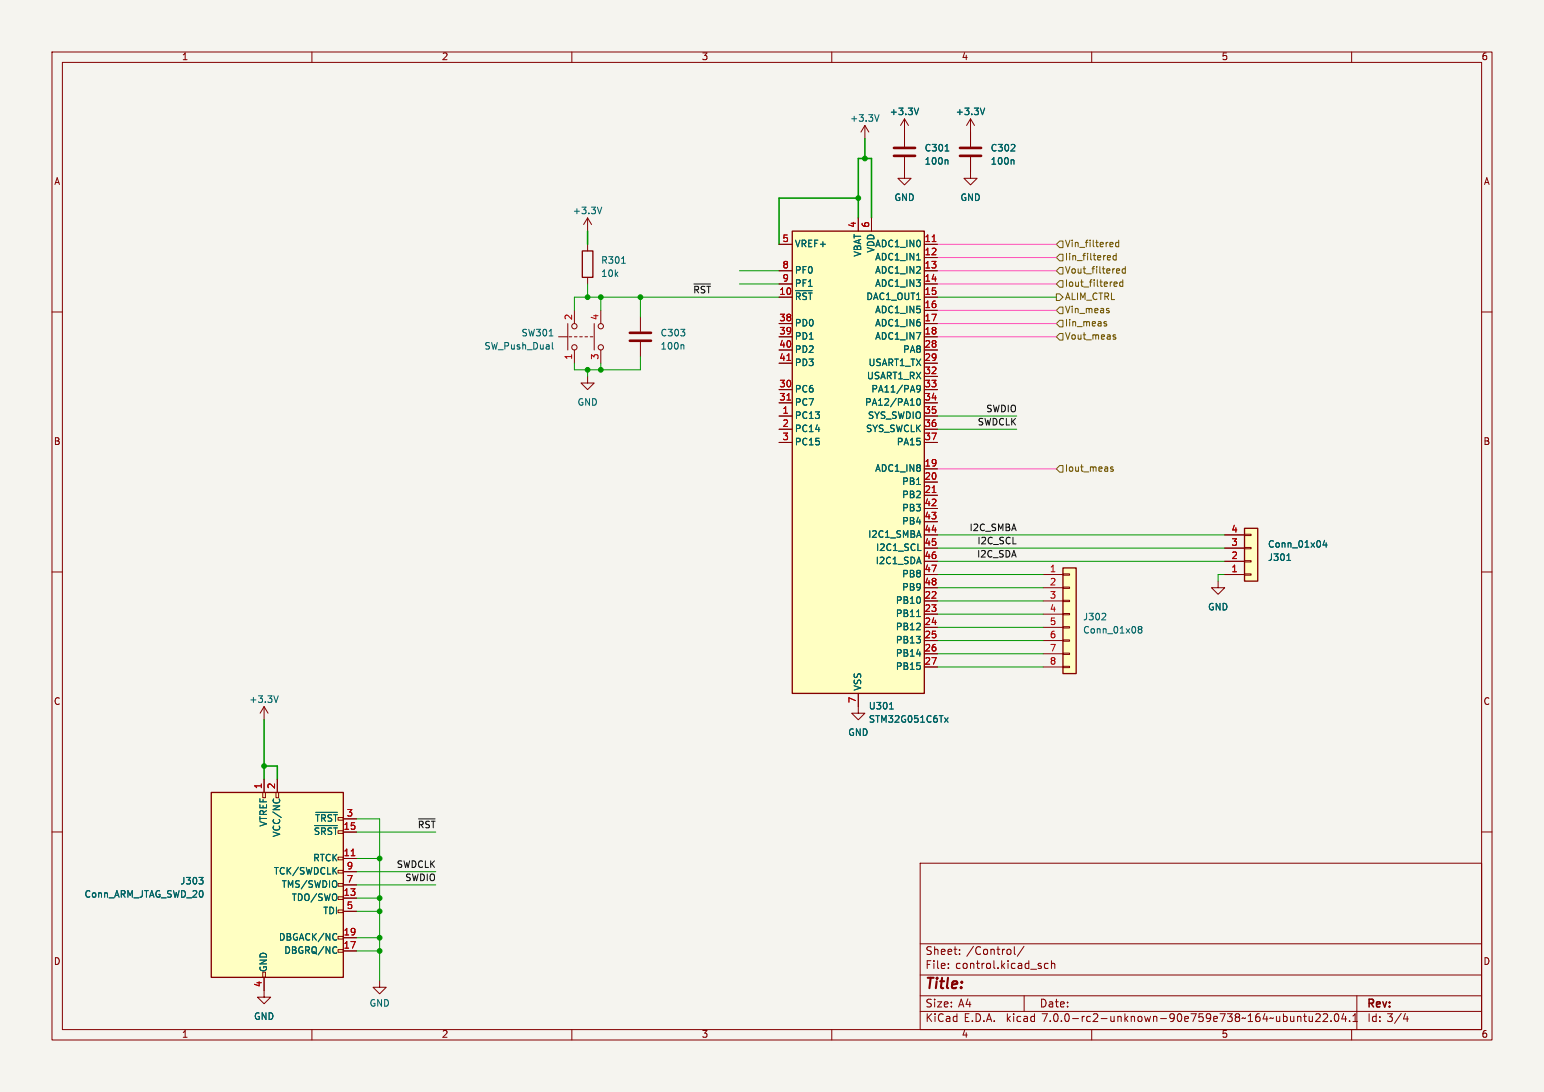
[picture p27: page 3]

Id: 3/4 Title: File: control.kicad_sch Sheet: /Control/

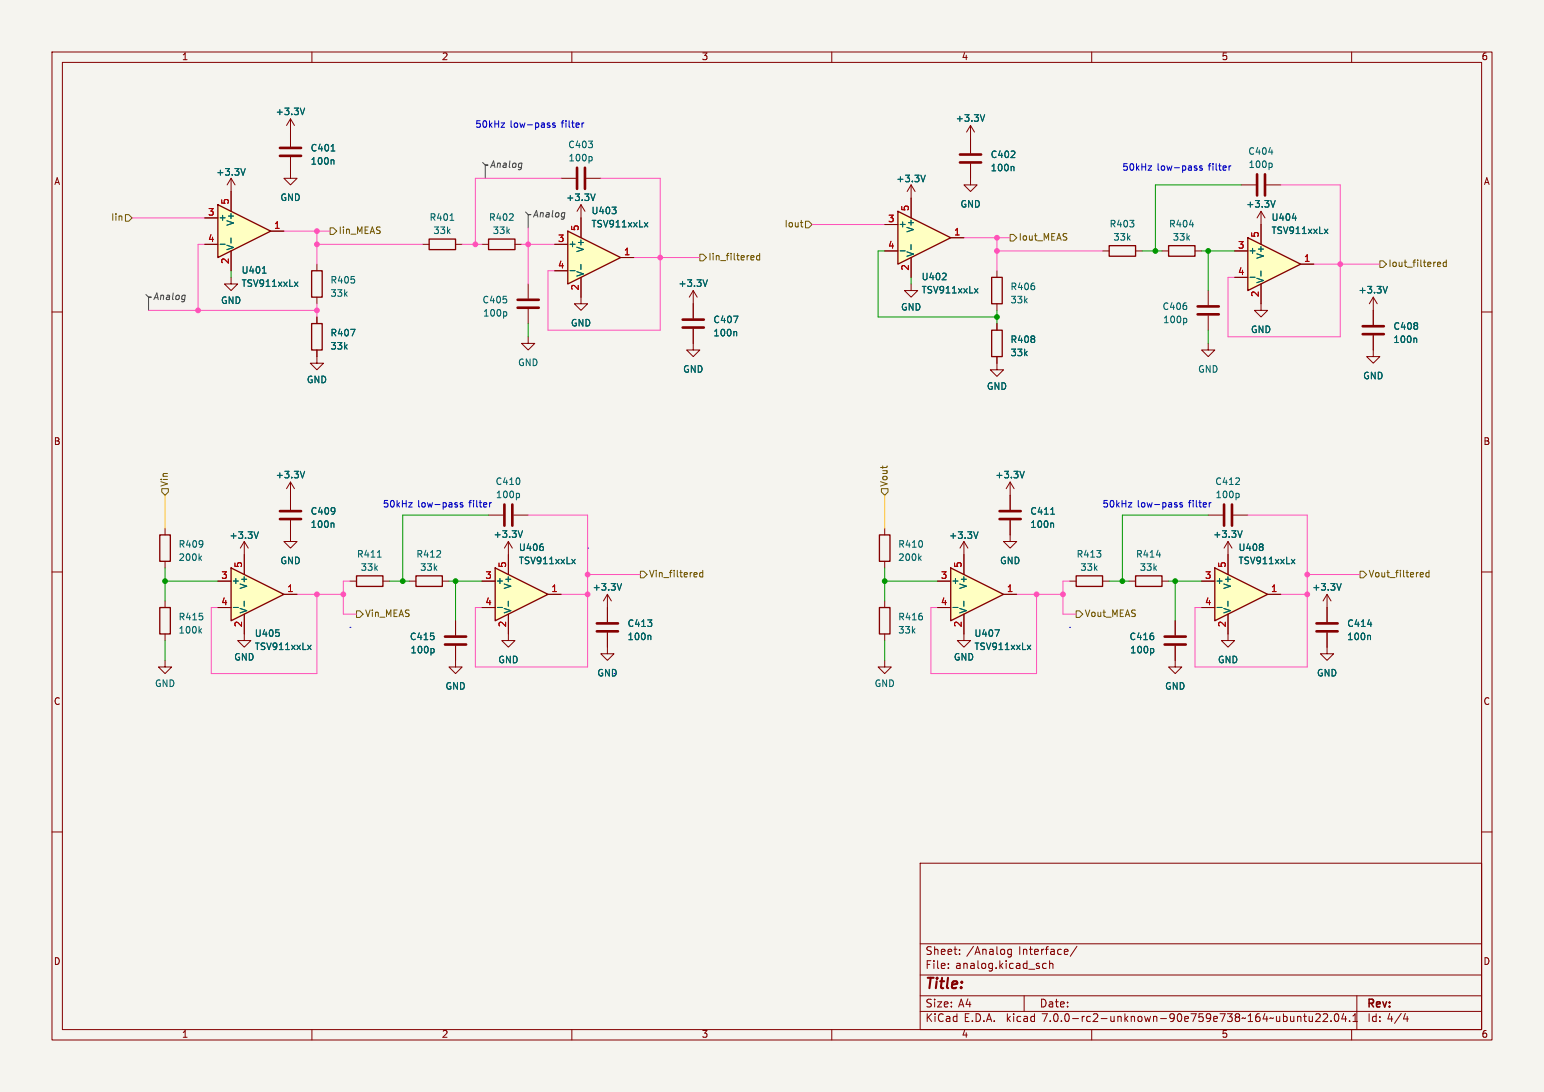
[picture p28: page 4]
