suzizecat/defissolaire-v4/proto/power_supply/pdf/overview.pdf

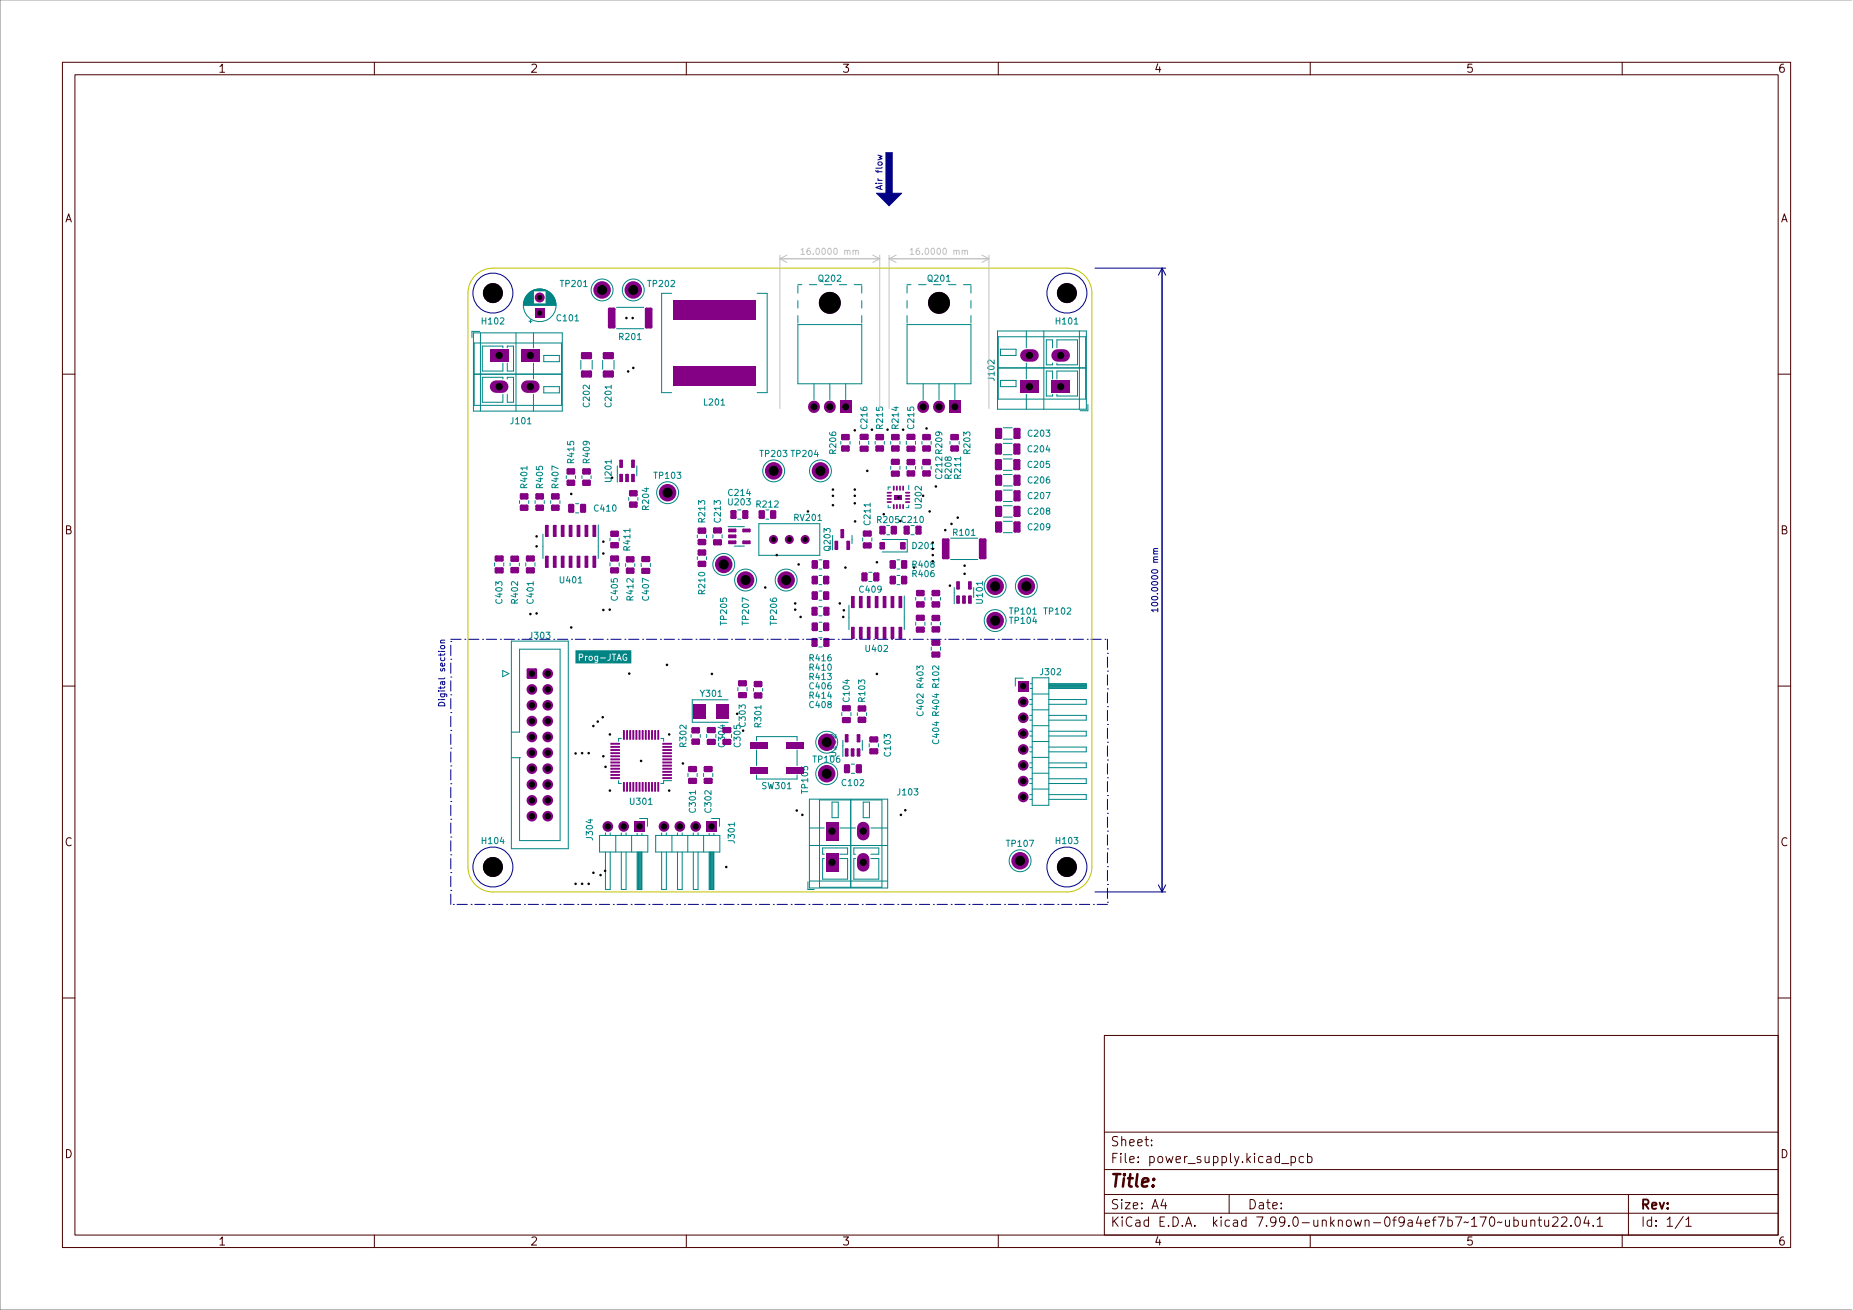
[picture p29: page 1]
