suzizecat/defissolaire-v4/proto/power_supply/pdf/power_supply-B_Silkscreen.pdf

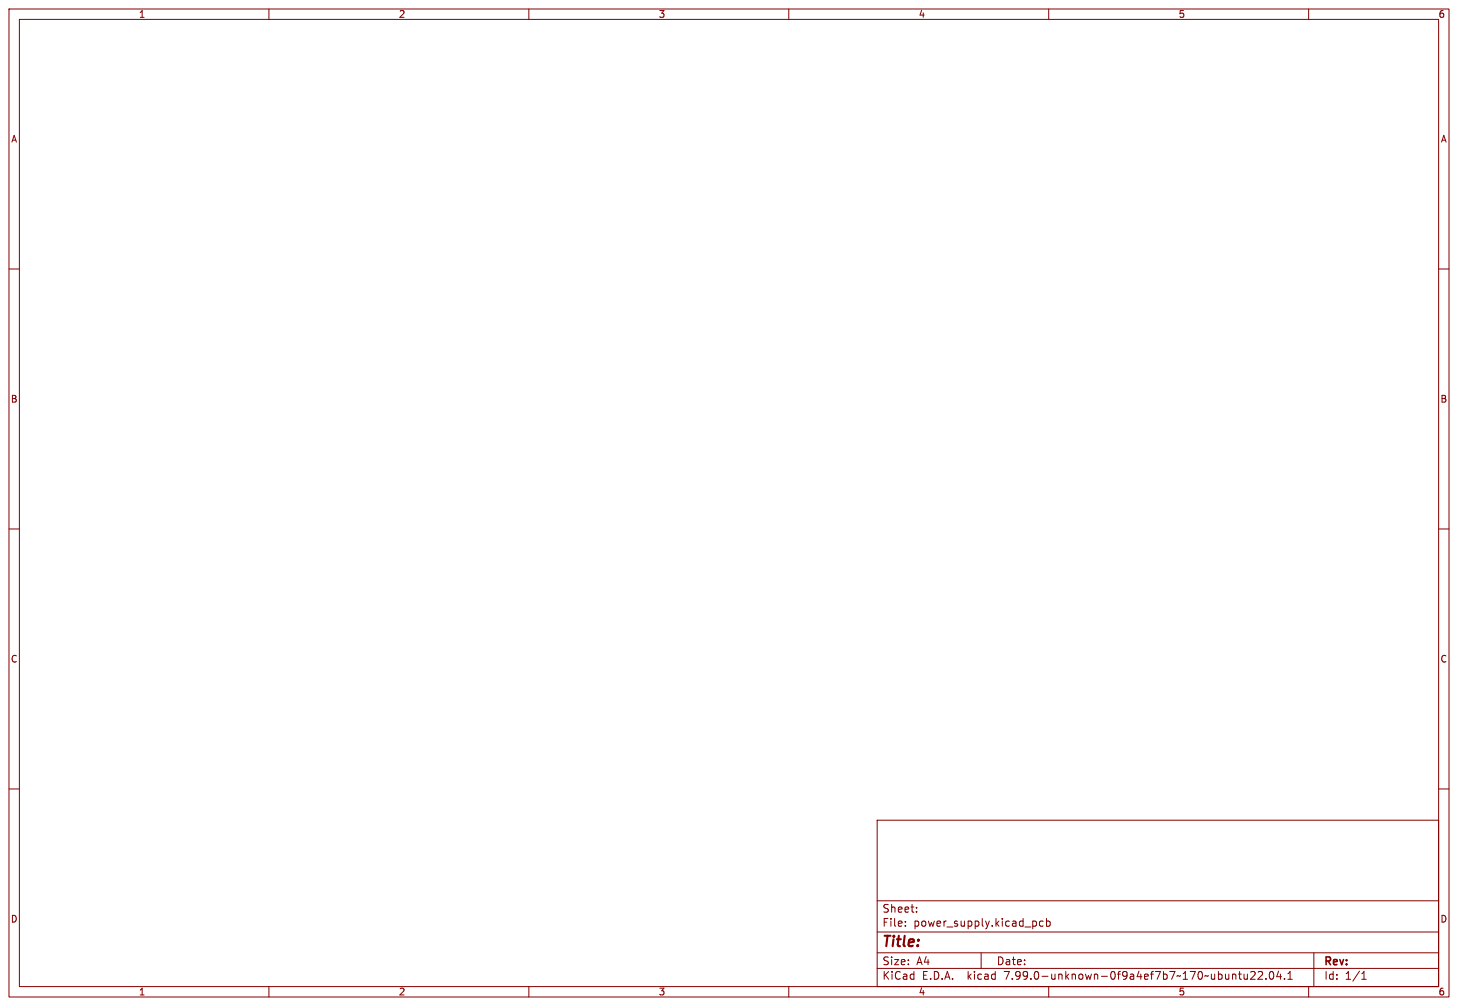
[picture p30: page 1]
