suzizecat/defissolaire-v4/proto/power_supply/pdf/power_supply-Edge_Cuts.pdf

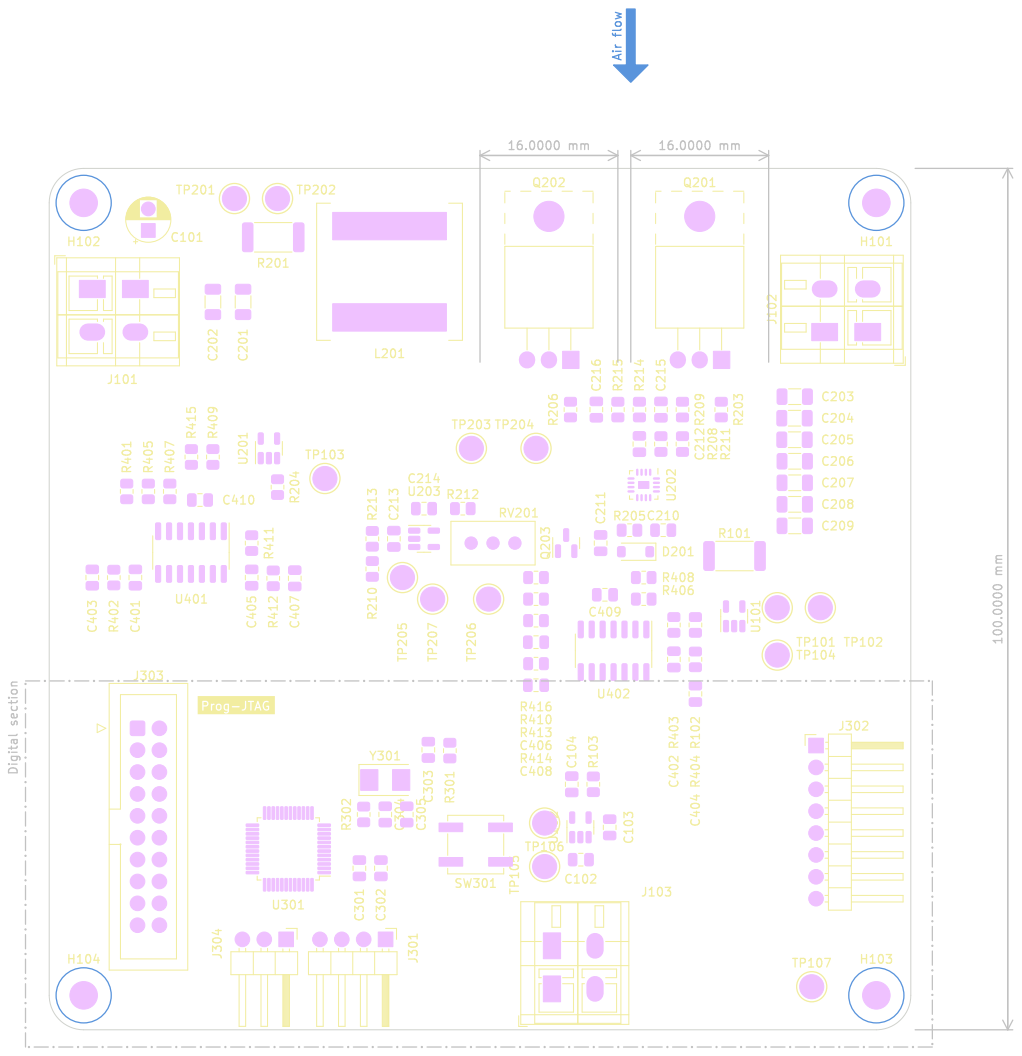
[picture p31: page 1]
