suzizecat/defissolaire-v4/proto/power_supply/pdf/power_supply-F_Mask.pdf

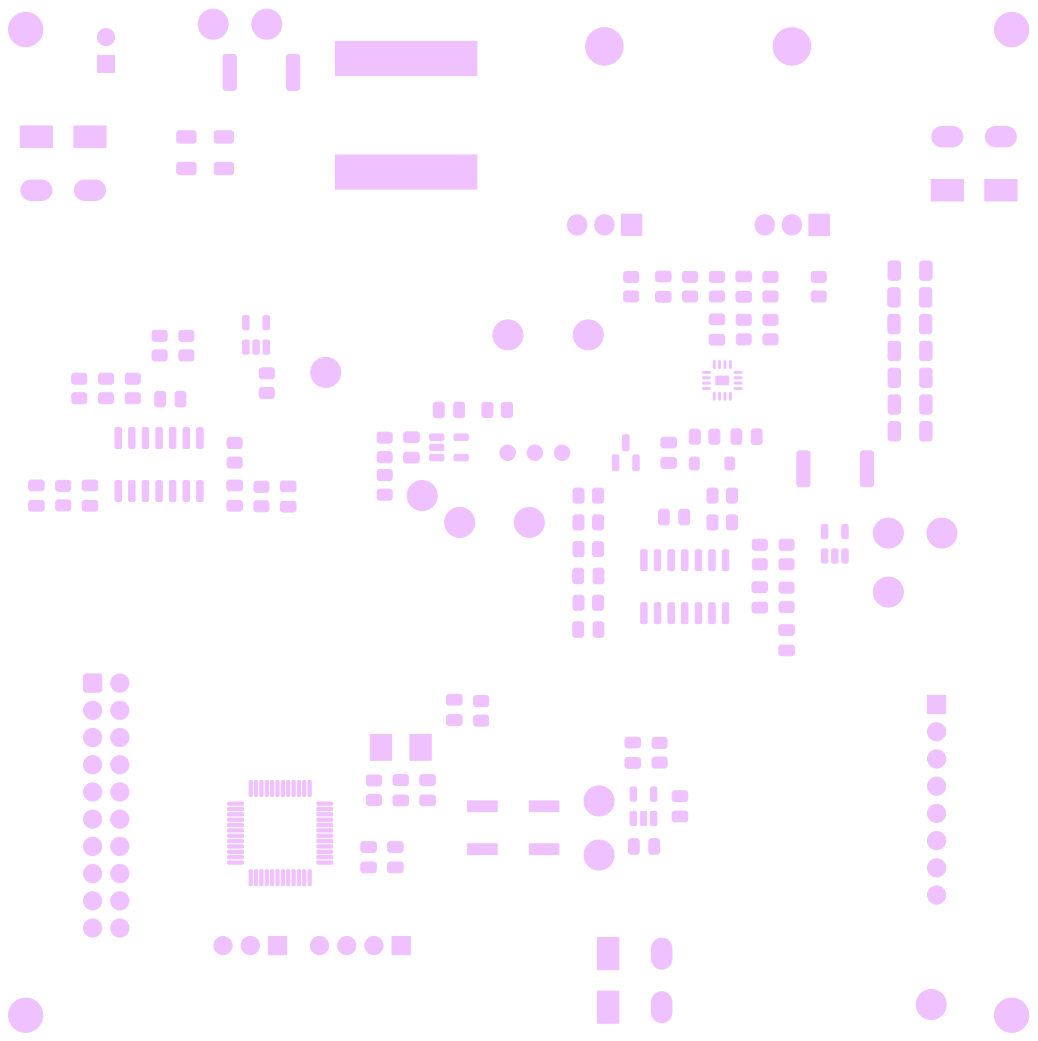
[picture p32: page 1]
