suzizecat/defissolaire-v4/proto/power_supply/pdf/power_supply-F_Silkscreen.pdf

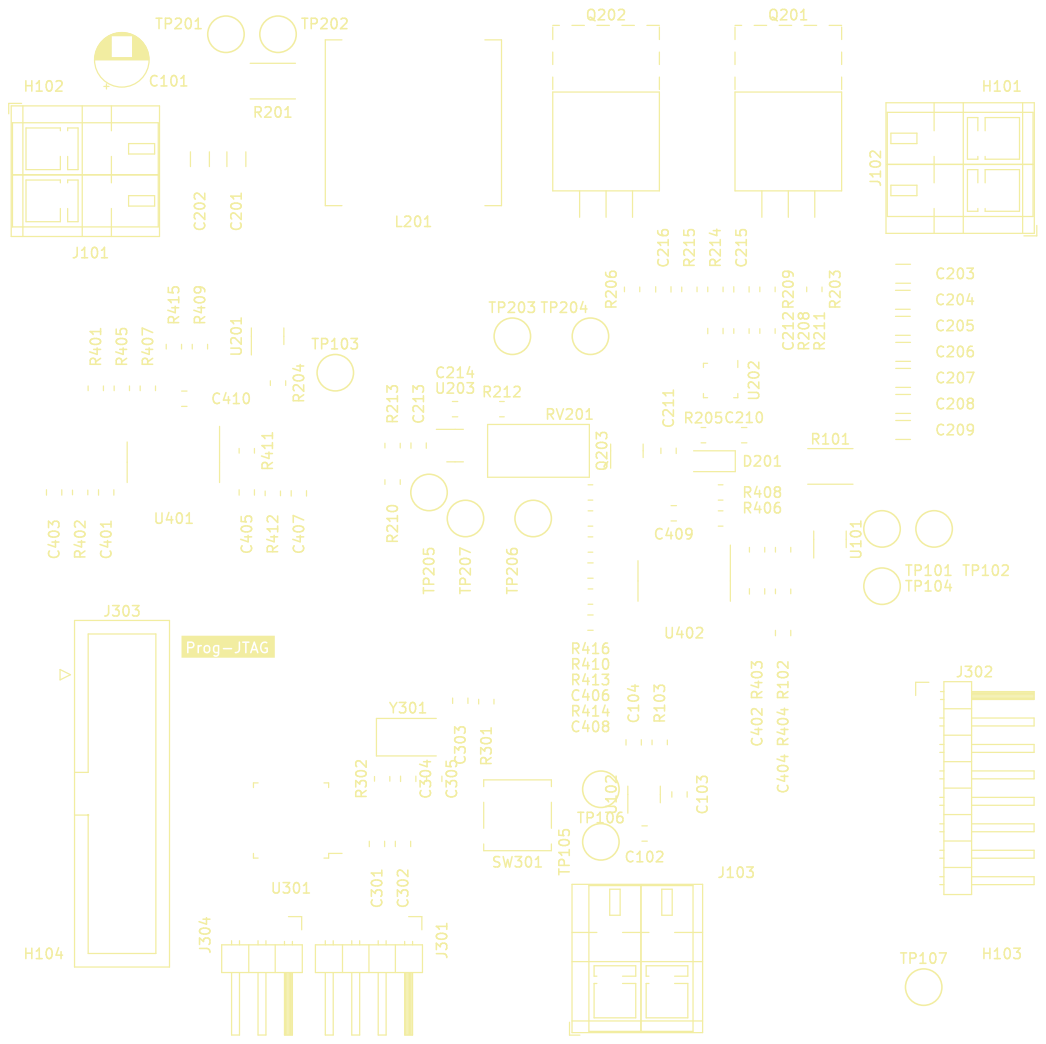
[picture p33: page 1]
