suzizecat/defissolaire-v4/proto/power_supply/pdf/power_supply-User_1.pdf

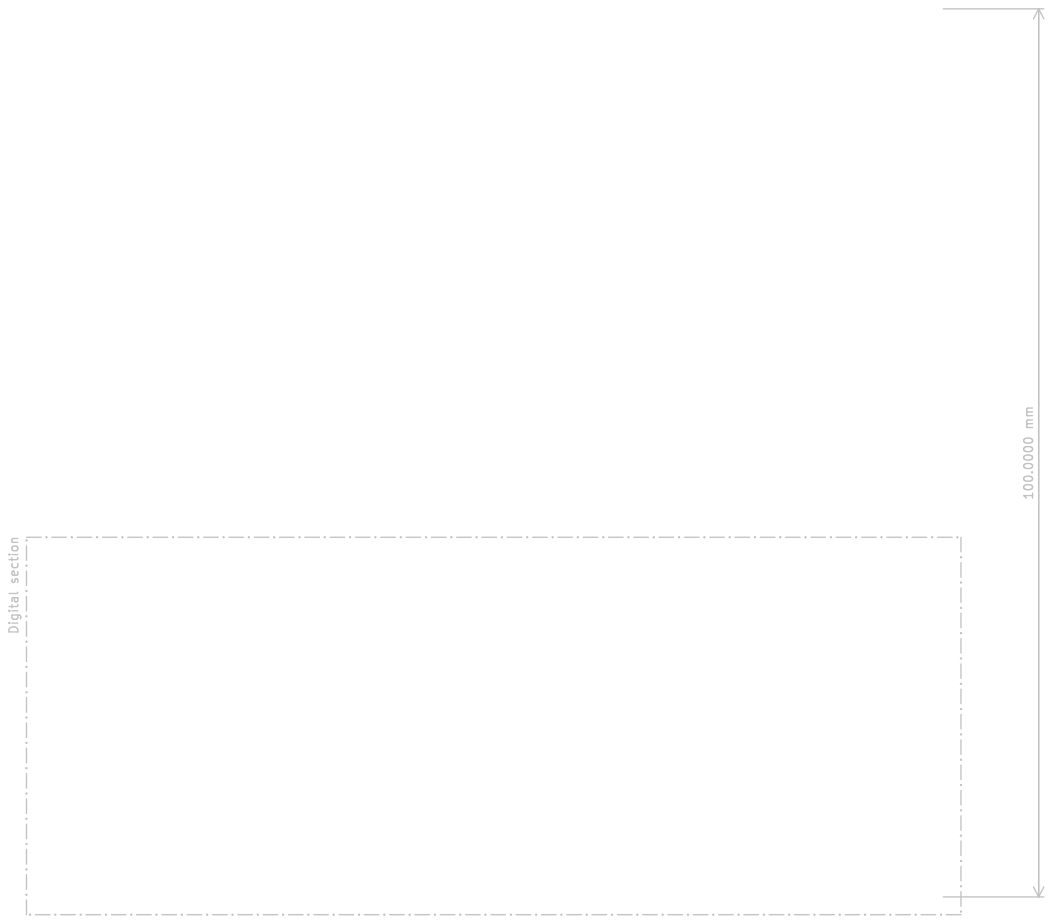
[picture p34: page 1]
