suzizecat/defissolaire-v4/proto/power_supply/pdf/power_supply-User_Comments.pdf

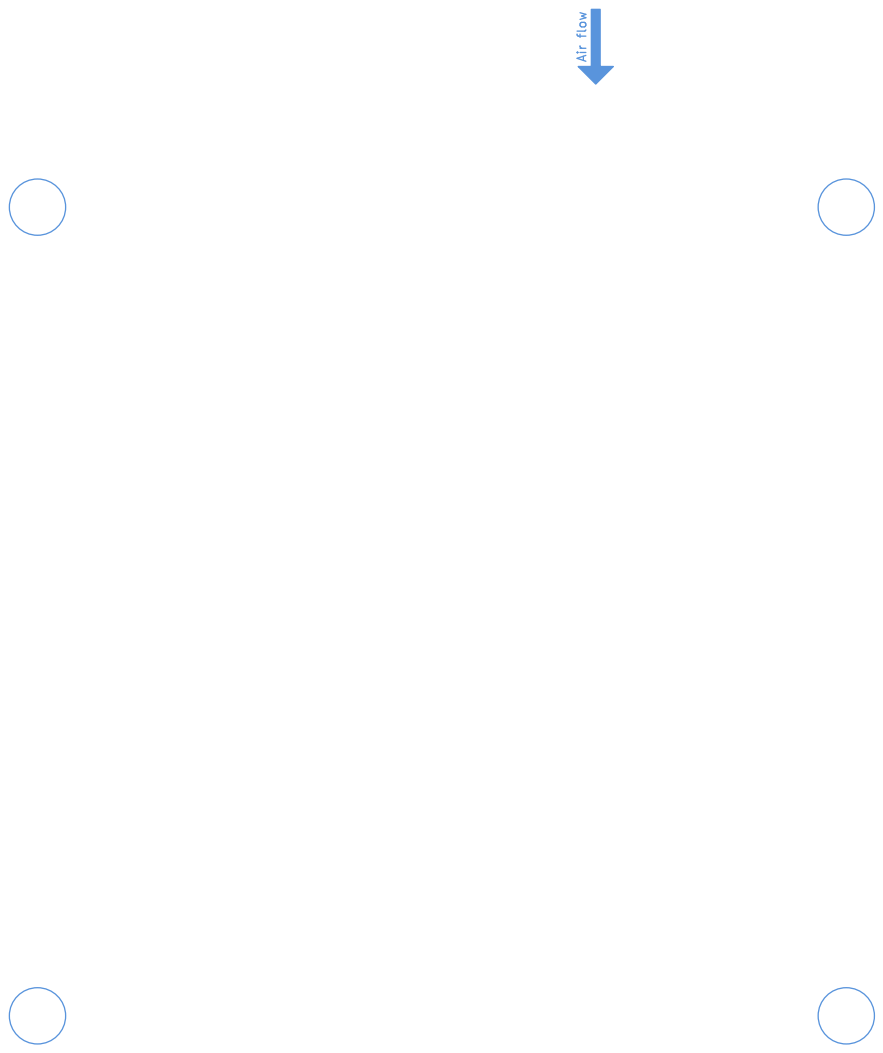
[picture p35: page 1]
