suzizecat/defissolaire-v4/proto/power_supply/pdf/power_supply-User_Drawings.pdf

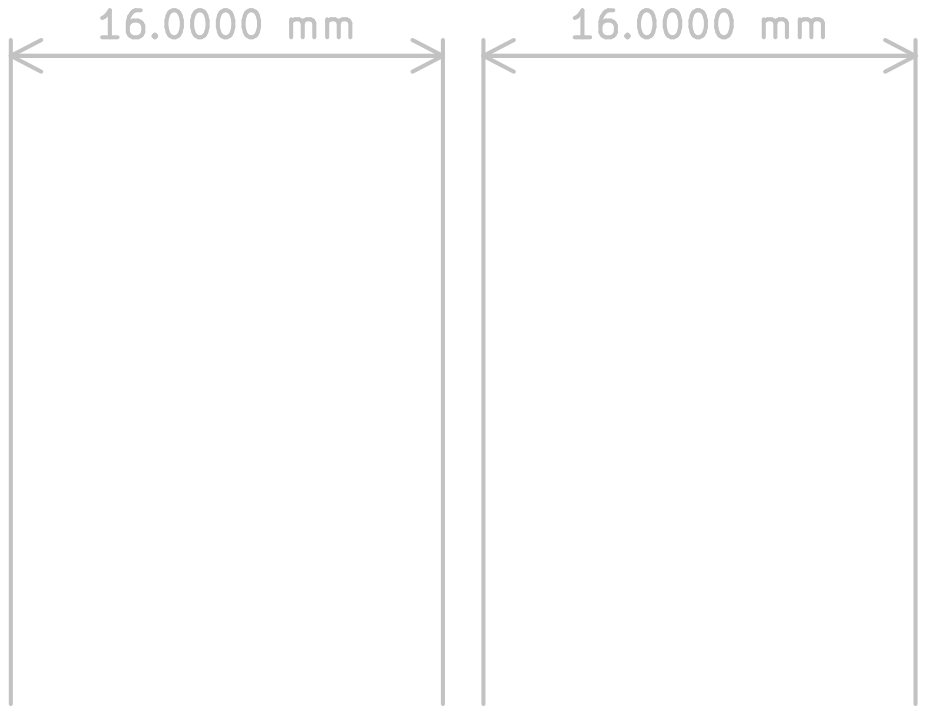
[picture p36: page 1]
