suzizecat/defissolaire-v4/(list of files, drawings)

Other design files:
librairies/spice/SLVMC02/TPS61178_PSPICE_TRANS/CSD25404Q3.OLB
librairies/spice/SLVMC02/TPS61178_PSPICE_TRANS/TPS61178_TRANS.OPJ
librairies/spice/SLVMC02/TPS61178_PSPICE_TRANS/TPS61178RNW_TRANS.OLB
