suzizecat/defissolaire-v4/side_main_psu/side_main_psu.kicad_pcb

## KiCad design side_main_psu/side_main_psu.kicad_pcb (2024-05-11)

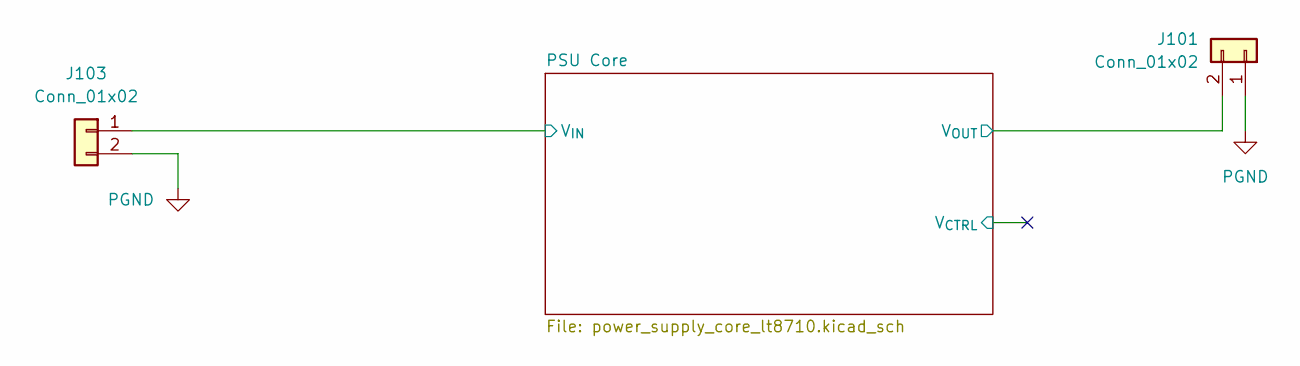
[picture p37: schematic side_main_psu.kicad_sch]

Parts:
J101, J103: Conn_01x02; TerminalBlock_WAGO_236-402_1x02_P5.00mm_45Degree

Connections:
/PSU Core/V_{IN}: J103.1; also elsewhere on the board
/PSU Core/V_{OUT}: J101.2; also elsewhere on the board
PGND: J101.1, J103.2; also elsewhere on the board

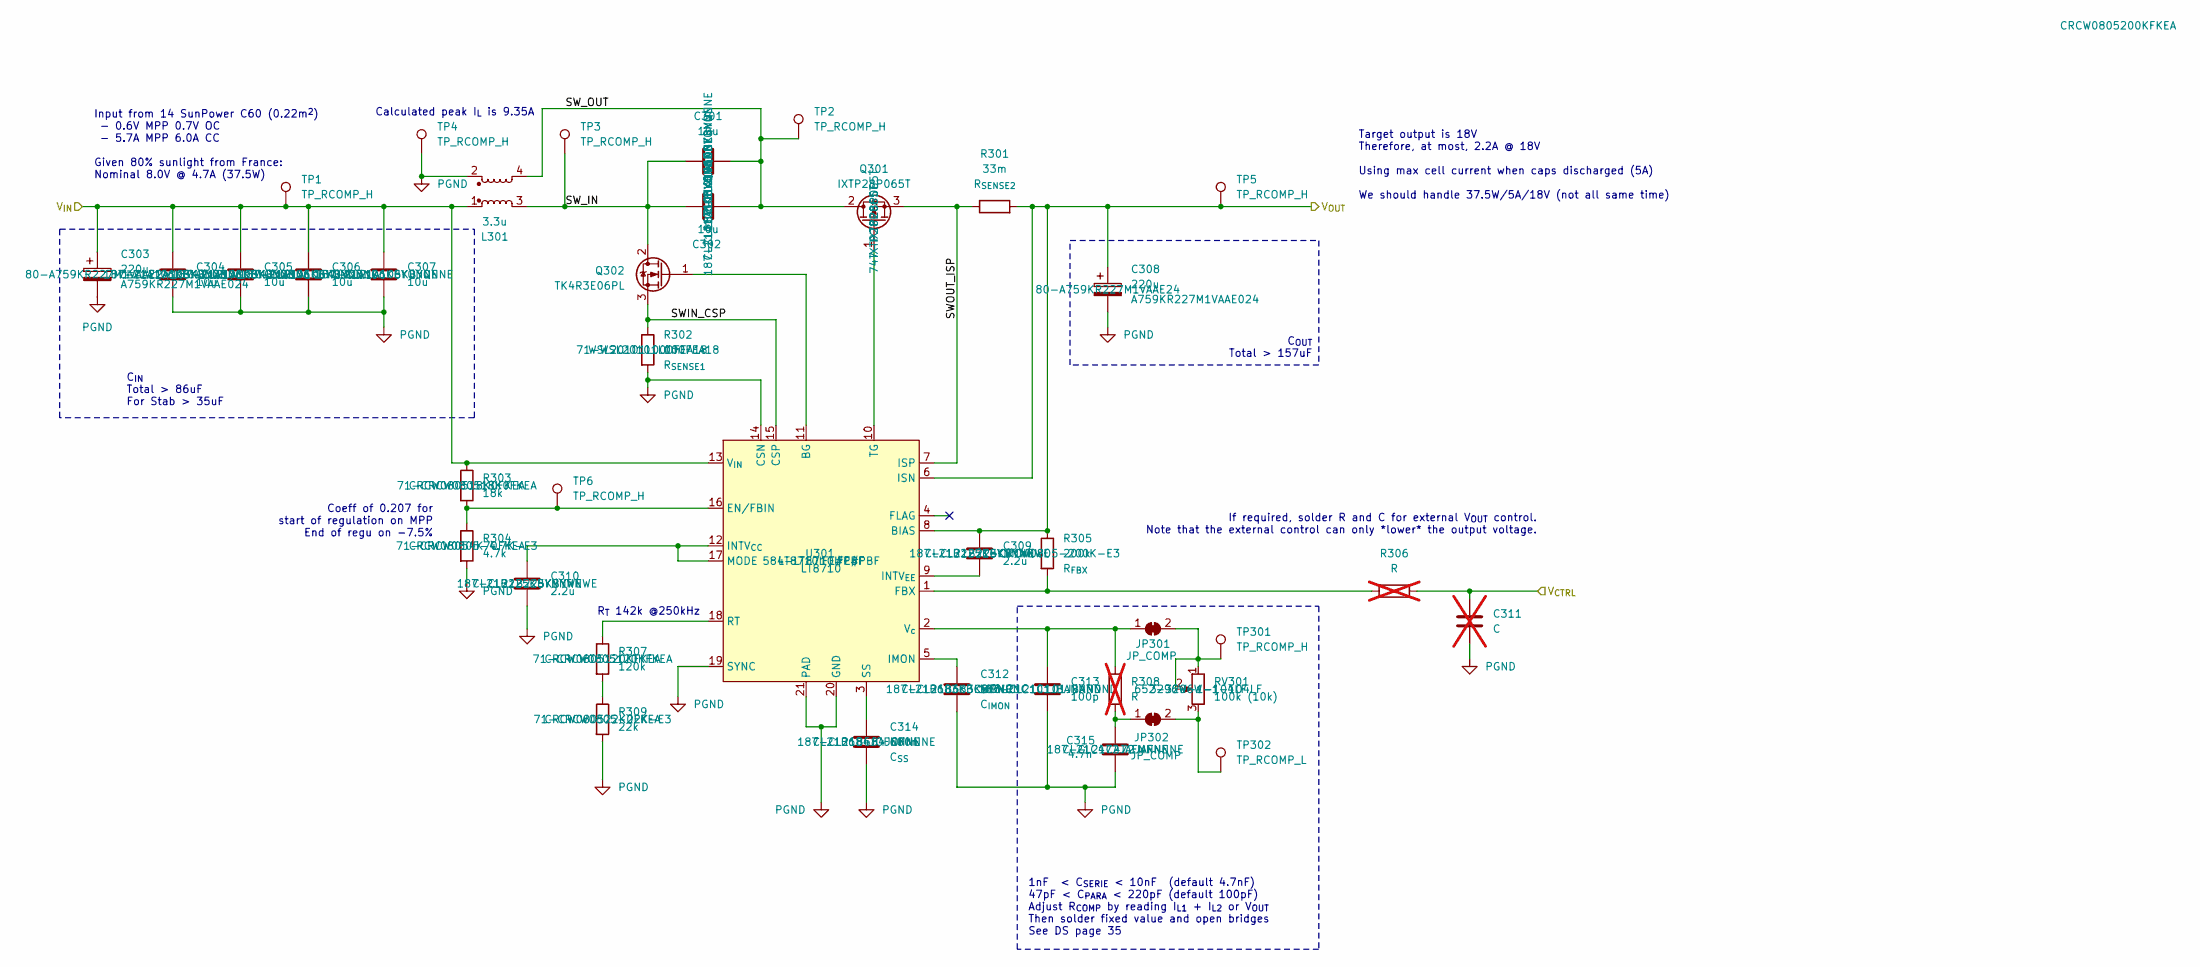
[picture p38: schematic power_supply_core_lt8710.kicad_sch, MPPT PSU - Core boost converter]

Parts:
C301, C302, C304, C305, C306, C307: 10u; C_0805_2012Metric; MPN CL21A106KBYQNNE; Mouser SKU 187-CL21A106KBYQNNE
C303, C308: 220u; CP_Radial_D8.0mm_P3.50mm; MPN A759KR227M1VAAE024; Mouser SKU 80-A759KR227M1VAAE24
C309, C310: 2.2u; C_0805_2012Metric; MPN CL21B225KBYNNWE; Mouser SKU 187-CL21B225KBYNNWE
C311: C; C_0805_2012Metric; not fitted
C312: 68n; C_0805_2012Metric; MPN CL21B683KBCWPNC; Mouser SKU 187-CL21B683KBCWPNC
C313: 100p; C_0805_2012Metric; MPN CL21C101JBANNND; Mouser SKU 187-CL21C101JBANNND
C314: 680n; C_0805_2012Metric; MPN CL21B684JOFNNNE; Mouser SKU 187-CL21B684JOFNNNE
C315: 4.7n; C_0805_2012Metric; MPN CL21C472JAFNNNE; Mouser SKU 187-CL21C472JAFNNNE
JP301, JP302: JP_COMP; SolderJumper-2_P1.3mm_Open_TrianglePad1.0x1.5mm
L301: 3.3u; Coilcraft_MSD1514
Q301: IXTP28P065T; TO-220-3_Horizontal_TabUp; MPN IXTP28P065T; Mouser SKU 747-IXTP28P065T
Q302: TK4R3E06PL; TO-220-3_Horizontal_TabUp; MPN TK4R3E06PL; Mouser SKU 757-TK4R3E06PLS1X
R301: 33m; R_2010_5025Metric
R302: 1m; R_2010_5025Metric; MPN WSL20101L000FEA18; Mouser SKU 71-WSL20101L000FEA18
R303: 18k; R_0805_2012Metric; MPN CRCW080518K0FKEA; Mouser SKU 71-CRCW080518K0FKEA
R304: 4.7k; R_0805_2012Metric; MPN CRCW08054K70FKEA; Mouser SKU 71-CRCW0805-4.7K-E3
R305: 200k; R_0805_2012Metric; MPN CRCW0805200KFKEA; Mouser SKU 71-CRCW0805-200K-E3
R306, R308: R; R_0805_2012Metric; not fitted
R307: 120k; R_0805_2012Metric; MPN CRCW0805120KFKEA; Mouser SKU 71-CRCW0805120KFKEA
R309: 22k; R_0805_2012Metric; MPN CRCW080522K0FKEA; Mouser SKU 71-CRCW0805-22K-E3
RV301: 100k (10k); Potentiometer_Bourns_3296W_Vertical; MPN 3296W-1-104LF; Mouser SKU 652-3296W-1-104LF
TP1, TP2, TP3, TP4, TP5, TP6, TP301: TP_RCOMP_H; TestPoint_Keystone_5010-5014_Multipurpose
TP302: TP_RCOMP_L; TestPoint_Keystone_5010-5014_Multipurpose
U301: LT8710; HTSSOP-20-1EP_4.4x6.5mm_P0.65mm_EP2.74x3.86mm; MPN LT8710IFE#PBF; Mouser SKU 584-LT8710IFE#PBF

Connections:
/PSU Core/SWIN_CSP: Q302.3 (S), R302.1, U301.15 (CSP)
/PSU Core/SWOUT_ISP: Q301.3 (S), R301.1, U301.7 (ISP)
/PSU Core/SW_IN: C301.2, C302.2, L301.3, Q302.2 (D), TP3.1
/PSU Core/SW_OUT: C301.1, C302.1, L301.4, Q301.2 (D), TP2.1
/PSU Core/V_{CTRL}: C311.1, R306.2
/PSU Core/V_{IN}: C303.1, C304.1, C305.1, C306.1, C307.1, L301.1, R303.1, TP1.1, U301.13 (V_{IN}); also elsewhere on the board
/PSU Core/V_{OUT}: C308.1, C309.1, R301.2, R305.1, TP5.1, U301.6 (ISN), U301.8 (BIAS); also elsewhere on the board
unnamed: C313.1, JP301.1 (A), R308.1, U301.2 (V_{c})
unnamed: JP301.2 (B), RV301.1, RV301.2, TP301.1
unnamed: C315.1, JP302.1 (A), R308.2
unnamed: JP302.2 (B), RV301.3, TP302.1
unnamed: Q301.1 (G), U301.10 (TG)
unnamed: Q302.1 (G), U301.11 (BG)
unnamed: R307.2, R309.1
unnamed: R303.2, R304.1, TP6.1, U301.16 (EN/FBIN)
unnamed: R305.2, R306.1, U301.1 (FBX)
unnamed: C312.1, U301.5 (IMON)
unnamed: C310.1, U301.12 (INTV_{CC}), U301.17 (MODE)
unnamed: C309.2, U301.9 (INTV_{EE})
unnamed: R307.1, U301.18 (RT)
unnamed: C314.1, U301.3 (SS)
PGND: C303.2, C304.2, C305.2, C306.2, C307.2, C308.2, C310.2, C311.2, C312.2, C313.2, C314.2, C315.2, L301.2, R302.2, R304.2, R309.2, TP4.1, U301.14 (CSN), U301.19 (SYNC), U301.20 (GND), U301.21 (PAD); also elsewhere on the board

Notes on the sheet:
If required, solder R and C for external V_{OUT} control. Note that the external control can only *lower* the output voltage.
1nF < C_{SERIE} < 10nF (default 4.7nF) 47pF < C_{PARA} < 220pF (default 100pF) Adjust R_{COMP} by reading I_{L1} + I_{L2} or V_{OUT} Then solder fixed value and open bridges See DS page 35
C_{IN} Total > 86uF For Stab > 35uF
R_{T} 142k @250kHz
Input from 14 SunPower C60 (0.22m^{2}) - 0.6V MPP 0.7V OC - 5.7A MPP 6.0A CC Given 80% sunlight from France: Nominal 8.0V @ 4.7A (37.5W)
Calculated peak I_{L} is 9.35A
C_{OUT} Total > 157uF
Coeff of 0.207 for start of regulation on MPP End of regu on -7.5%
Target output is 18V Therefore, at most, 2.2A @ 18V Using max cell current when caps discharged (5A) We should handle 37.5W/5A/18V (not all same time)

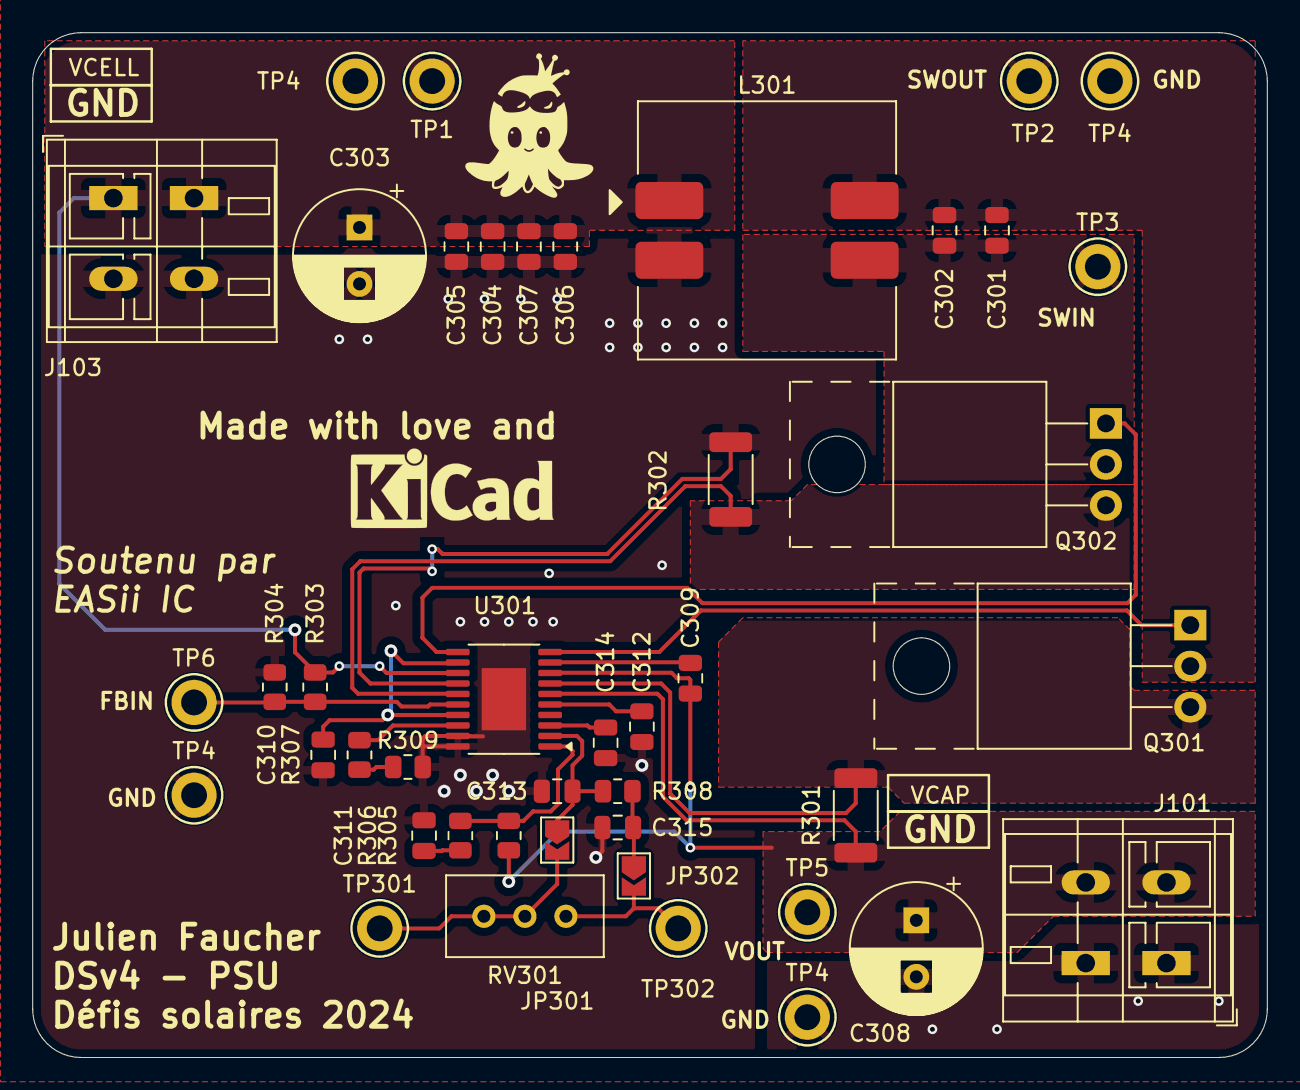
[picture p39: board side_main_psu.kicad_pcb from above]

Board: 2 copper layers, 76.5 x 63.5 mm, 44 parts (0 on the bottom side), 22 nets.

Other parts of the board:
TP4#2, TP4#3, TP4#4: TP_GND; TestPoint_Keystone_5010-5014_Multipurpose

Their connections:
PGND: TP4#2.1, TP4#3.1, TP4#4.1; also elsewhere on the board
