suzizecat/defissolaire-v4/main/dsv4.kicad_pcb

## KiCad design main/dsv4.kicad_pcb (2024-04-23)

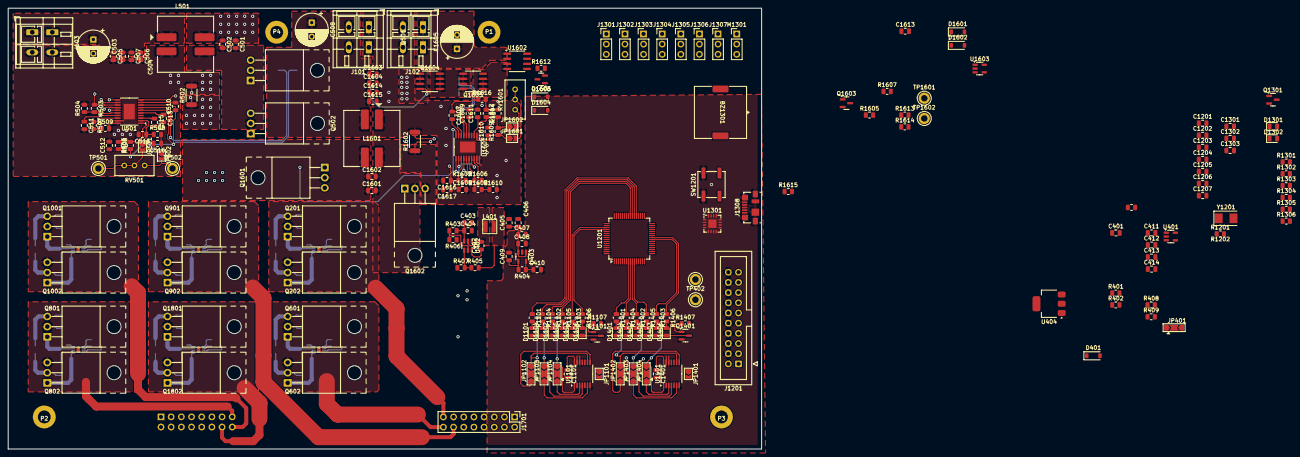
[picture p40: board dsv4.kicad_pcb from above]

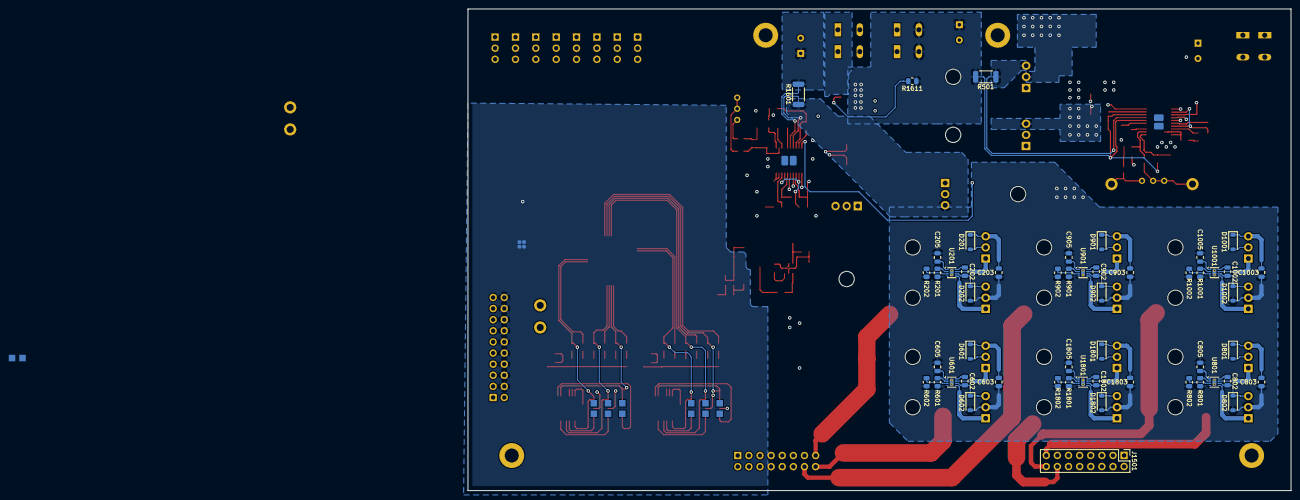
[picture p41: board dsv4.kicad_pcb from below]

Board: 4 copper layers, 188.0 x 110.0 mm, 261 parts (52 on the bottom side), 170 nets.

Parts:
BZ1301: PKLCS1212E4001-R1
C202, C402, C404, C408, C413, C602, C802, C902, C1002, C1101, C1201, C1202, C1203, C1204, C1205, C1303, C1401, C1617, C1802: 100n; C_0805_2012Metric
C203, C603, C803, C903, C1003, C1803: 1n; C_0805_2012Metric
C205, C407, C410, C411, C412, C414, C605, C805, C905, C1005, C1805: 1u; C_0805_2012Metric
C401, C1613: 4.7u; C_0805_2012Metric
C403, C510, C511, C1607, C1608: 2.2u; C_0805_2012Metric
C405, C406, C501, C502, C504, C505, C506, C507, C1601, C1602, C1603, C1604, C1614, C1615, C1616: 10u; C_0805_2012Metric
C409: 10n; C_0805_2012Metric
C503, C508, C1605: 220u; CP_Radial_D8.0mm_P3.50mm
C512: C; C_0805_2012Metric
C513, C1609: 62n; C_0805_2012Metric
C514, C1610: 100p; C_0805_2012Metric
C515, C1611: 560n; C_0805_2012Metric
C516, C1612: 4.7n; C_0805_2012Metric
C1206, C1207: 18p; C_0805_2012Metric
C1301, C1302: 47p; C_0805_2012Metric
D201, D202, D601, D602, D801, D802, D901, D902, D1001, D1002, D1601, D1602, D1603, D1604, D1801, D1802: B5819W-TP; D_SOD-123
D401: XBS104S14R-G; D_SOD-123
D1101, D1102, D1103, D1401, D1402, D1403: RED; LED_0805_2012Metric
D1104, D1105, D1106, D1404, D1405, D1406: BLUE; LED_0805_2012Metric
D1301, D1302: LED; LED_0805_2012Metric
J101, J102, J103: Conn_01x02; TerminalBlock_WAGO_236-402_1x02_P5.00mm_45Degree
J1201: Conn_ARM_JTAG_SWD_20; IDC-Header_2x10_P2.54mm_Vertical
J1301: Transponder; PinHeader_1x03_P2.54mm_Vertical
J1302, J1303, J1304, J1305, J1306, J1307: Conn_01x03; PinHeader_1x03_P2.54mm_Vertical
J1308: USB_B_Micro; USB_Micro-B_Molex_47346-0001
J1501, J1701: Conn_02x08_Odd_Even; PinHeader_2x08_P2.54mm_Vertical
JP401: DRIVE VSEL; SolderJumper-3_P2.0mm_Open_TrianglePad1.0x1.5mm
JP501, JP502, JP1601, JP1602: JP_COMP; SolderJumper-2_P1.3mm_Open_TrianglePad1.0x1.5mm
JP1101, JP1401: AND_PWR; SolderJumper-2_P1.3mm_Open_TrianglePad1.0x1.5mm
JP1102, JP1103, JP1104, JP1402, JP1403, JP1404: AND_BYP; SolderJumper-3_P2.0mm_Open_TrianglePad1.0x1.5mm
L401: 3.3u; VLS3015CX
L501, L1601: 3.3u; Coilcraft_MSD1260T
M1301: Servo direction; PinHeader_1x03_P2.54mm_Vertical
P1, P2, P3, P4: CONN_01X01; MountingHole_3.2mm_M3_ISO7380_Pad
Q201, Q202, Q502, Q601, Q602, Q801, Q802, Q901, Q902, Q1001, Q1002, Q1602, Q1801, Q1802: TK4R3E06PL; TO-220-3_Horizontal_TabUp
Q501, Q1601: IXTP28P065T; TO-220-3_Horizontal_TabUp
Q1101, Q1301, Q1401, Q1603, Q1606: IRLML0030; SOT-23
Q1604, Q1605: FDS6681Z; SOIC-8_3.9x4.9mm_P1.27mm
R201, R202, R601, R602, R801, R802, R901, R902, R1001, R1002, R1107, R1302, R1407, R1801, R1802: 100k; R_0805_2012Metric
R401, R406, R1613: 33k; R_0805_2012Metric
R402, R1614: 5.6k; R_0805_2012Metric
R403, R405: 150k; R_0805_2012Metric
R404: NM; R_0805_2012Metric
R407, R409: 20k; R_0805_2012Metric
R408: 2k; R_0805_2012Metric
R501, R1601: 33m; R_2010_5025Metric
R502, R1602: 1m; R_2010_5025Metric
R503, R1603: 18k; R_0805_2012Metric
R504, R1605, R1606: 4.7k; R_0805_2012Metric
R505: 200k; R_0805_2012Metric
R506, R508, R1609: R; R_0805_2012Metric
R507, R1608: 120k; R_0805_2012Metric
R509, R1610: 22k; R_0805_2012Metric
R1101, R1102, R1103, R1104, R1105, R1106, R1401, R1402, R1403, R1404, R1405, R1406: 3k3; R_0805_2012Metric
R1201, R1202, R1607, R1611, R1612, R1615: 10k; R_0805_2012Metric
R1301, R1305, R1306: 1k; R_0805_2012Metric
R1303, R1304: 27; R_0805_2012Metric
R1604, R1616: 68k; R_0805_2012Metric
RV501, RV1601: 100k (10k); Potentiometer_Bourns_3296W_Vertical
SW1201: B3SL-1022P; SW_SPST_B3SL-1022P
TP401, TP402: TestPoint; TestPoint_Keystone_5010-5014_Multipurpose
TP501, TP1601: TP_RCOMP_H; TestPoint_Keystone_5010-5014_Multipurpose
TP502, TP1602: TP_RCOMP_L; TestPoint_Keystone_5010-5014_Multipurpose
U201, U601, U801, U901, U1001, U1801: LM2105; WSON-8-1EP_2x2mm_P0.5mm_EP0.9x1.6mm_ThermalVias
U401, U1603: TSV911xxLx; SOT-23-5
U402: LMR51430; SOT-23-6
U403: LDK130M33R; SOT-23-5
U404: LM317_SOT-223; SOT-223-3_TabPin2
U501, U1601: LT8710; HTSSOP-20-1EP_4.4x6.5mm_P0.65mm_EP2.74x3.86mm
U1101, U1401: 74LS08; TSSOP-14_4.4x5mm_P0.65mm
U1201: STM32L476RGTx; LQFP-64_10x10mm_P0.5mm
U1301: FT230XQ; QFN-16-1EP_4x4mm_P0.65mm_EP2.1x2.1mm
U1602: TMCS1101; SOIC-8_3.9x4.9mm_P1.27mm
Y1201: 8MHz; Crystal_SMD_5032-2Pin_5.0x3.2mm

Connections:
+3.3V: C410.1, C1201.1, C1202.1, C1203.1, C1204.1, J1201.2 (VCC/NC), J1501.1, J1701.1, JP1101.2 (B), JP1401.2 (B), R404.1, R1201.1, R1615.1, TP401.1, U401.5 (V+), U403.5 (OUT), U1201.13 (VDDA), U1201.19 (VDD), U1201.32 (VDD), U1201.64 (VDD), U1602.8 (VS), U1603.5 (V+)
+5V: C405.1, C406.1, C407.1, C408.1, J1301.2, J1302.2, J1303.2, J1304.2, J1305.2, J1306.2, J1307.2, L401.2, M1301.2 (+), R405.2, TP402.1, U403.1 (IN), U403.3 (EN)
/CODA.A: J1701.2, U1201.14 (PA0)
/CODA.B: J1701.3, U1201.15 (PA1)
/CODB.A: J1501.2, U1201.22 (TIM3_CH1)
/CODB.B: J1501.3, U1201.23 (TIM3_CH2)
/CSN_1: J1701.11, U1201.3 (PC14)
/CSN_2: J1501.11, U1201.4 (PC15)
/MCU/BAT_OK: R1615.2, U1201.29 (PB10), U1601.4 (FLAG)
/MCU/BAT_USE: D1602.2 (A), Q1606.1 (G), U1201.30 (PB11)
/MCU/EN_BIP: Q1301.1 (G), R1302.1, U1201.50 (PA15)
/MCU/MEAS_IBAT: U1201.21 (ADC1_IN10), U1602.7 (VOUT)
/MCU/MEAS_VBAT: U1201.20 (ADC1_IN9), U1603.1, U1603.4 (-)
/MCU/MEAS_VCAP: U401.1, U401.4 (-), U1201.26 (ADC1_IN15)
/MCU/MOT1.AH: R901.1, R1401.1, U901.2 (INH), U1201.8 (PC0)
/MCU/MOT1.AL: JP1402.2 (C), R902.1, U901.3 (INL)
/MCU/MOT1.BH: R201.1, R1402.1, U201.2 (INH), U1201.10 (PC2)
/MCU/MOT1.BL: JP1403.2 (C), R202.1, U201.3 (INL)
/MCU/MOT1.CH: R601.1, R1403.1, U601.2 (INH), U1201.24 (PC4)
/MCU/MOT1.CL: JP1404.2 (C), R602.1, U601.3 (INL)
/MCU/MOT1_CMD.AL: JP1402.3 (B), R1404.1, U1201.9 (PC1), U1401.9
/MCU/MOT1_CMD.BL: JP1403.3 (B), R1405.1, U1201.11 (PC3), U1401.4
/MCU/MOT1_CMD.CL: JP1404.3 (B), R1406.1, U1201.25 (PC5), U1401.1
/MCU/MOT1_PWM: U1201.35 (TIM15_CH1), U1401.2, U1401.5, U1401.10
/MCU/MOT2.AH: R1101.1, R1801.1, U1201.37 (PC6), U1801.2 (INH)
/MCU/MOT2.AL: JP1102.2 (C), R1802.1, U1801.3 (INL)
/MCU/MOT2.BH: R801.1, R1102.1, U801.2 (INH), U1201.39 (PC8)
/MCU/MOT2.BL: JP1103.2 (C), R802.1, U801.3 (INL)
/MCU/MOT2.CH: R1001.1, R1103.1, U1001.2 (INH), U1201.51 (PC10)
/MCU/MOT2.CL: JP1104.2 (C), R1002.1, U1001.3 (INL)
/MCU/MOT2_CMD.AL: JP1102.3 (B), R1104.1, U1101.9, U1201.38 (PC7)
/MCU/MOT2_CMD.BL: JP1103.3 (B), R1105.1, U1101.4, U1201.40 (PC9)
/MCU/MOT2_CMD.CL: JP1104.3 (B), R1106.1, U1101.1, U1201.52 (PC11)
/MCU/MOT2_PWM: U1101.2, U1101.5, U1101.10, U1201.36 (TIM15_CH2)
/MCU/MOT_LED_EN: Q1101.1 (G), Q1401.1 (G), R1107.1, R1407.1, U1201.34 (PB13)
/MCU/NRST: C1205.1, J1201.3 (~TRST), R1201.2, SW1201.2, U1201.7 (NRST)
/MCU/OSC_1: C1206.1, U1201.5 (RCC_OSC_IN), Y1201.1
/MCU/OSC_2: C1207.1, U1201.6 (RCC_OSC_OUT), Y1201.2
/MCU/RADIO1: J1302.1, U1201.41 (PA8)
/MCU/RADIO2: J1303.1, U1201.42 (PA9)
/MCU/RADIO3: J1304.1, M1301.1 (PWM), U1201.43 (PA10)
/MCU/RADIO4: J1305.1, U1201.44 (PA11)
/MCU/RADIO5: J1306.1, U1201.58 (TIM4_CH1)
/MCU/RADIO6: J1307.1, U1201.59 (TIM4_CH2)
/MCU/SWCLK: J1201.9 (TCK/SWCLK), U1201.49 (SYS_JTCK-SWCLK)
/MCU/SWDIO: J1201.7 (TMS/SWDIO), U1201.46 (SYS_JTMS-SWDIO)
/MCU/USART.RX: U1201.17 (USART2_RX), U1301.15 (TXD)
/MCU/USART.TX: U1201.16 (USART2_TX), U1301.2 (RXD)
/MCU/~BAT_CHARGE: D1601.2 (A), U1201.33 (PB12)
/MOT A Connection/MOT.A: C902.2, D901.2 (A), D902.1 (K), J1701.14, Q901.2 (D), Q902.3 (S), U901.6 (SH)
/MOT A Connection/MOT.B: C202.2, D201.2 (A), D202.1 (K), J1701.15, Q201.2 (D), Q202.3 (S), U201.6 (SH)
/MOT A Connection/MOT.C: C602.2, D601.2 (A), D602.1 (K), J1701.16, Q601.2 (D), Q602.3 (S), U601.6 (SH)
/MOT B Connection/MOT.A: C1802.2, D1801.2 (A), D1802.1 (K), J1501.14, Q1801.2 (D), Q1802.3 (S), U1801.6 (SH)
/MOT B Connection/MOT.B: C802.2, D801.2 (A), D802.1 (K), J1501.15, Q801.2 (D), Q802.3 (S), U801.6 (SH)
/MOT B Connection/MOT.C: C1002.2, D1001.2 (A), D1002.1 (K), J1501.16, Q1001.2 (D), Q1002.3 (S), U1001.6 (SH)
/PSU/5VSW: C402.2, L401.1, U402.2 (SW)
/PSU/Battery chagrer/BATT_RET_PATH: Q1605.1 (S), Q1605.2 (S), Q1605.3 (S), R1612.1, U1602.3 (OUT), U1602.4 (OUT)
/PSU/Battery chagrer/BAT_RET_MID: Q1604.5 (D), Q1604.6 (D), Q1604.7 (D), Q1604.8 (D), Q1605.5 (D), Q1605.6 (D), Q1605.7 (D), Q1605.8 (D)
/PSU/Battery chagrer/SWIN_CSP: Q1602.3 (S), R1602.1, U1601.15 (CSP)
/PSU/Battery chagrer/SWOUT_ISP: Q1601.3 (S), R1601.1, U1601.7 (ISP)
/PSU/Battery chagrer/SW_IN: C1601.2, C1602.2, L1601.4, Q1602.2 (D)
/PSU/Battery chagrer/SW_OUT: C1601.1, C1602.1, L1601.3, Q1601.2 (D)
/PSU/Input PSU/SWIN_CSP: Q502.3 (S), R502.1, U501.15 (CSP)
/PSU/Input PSU/SWOUT_ISP: Q501.3 (S), R501.1, U501.7 (ISP)
/PSU/Input PSU/SW_IN: C501.2, C502.2, L501.3, Q502.2 (D)
/PSU/Input PSU/SW_OUT: C501.1, C502.1, L501.4, Q501.2 (D)
/PSU/Input PSU/V_{CTRL}: C512.1, R506.2
/PSU/V_{CELL}: C503.1, C504.1, C505.1, C506.1, C507.1, J103.1, L501.1, R503.1, U501.13 (V_{IN})
/Radio and misc/V_{FTDI}: C1303.1, D1301.2 (A), D1302.2 (A), U1301.1 (VCCIO), U1301.8 (3V3OUT), U1301.9 (~RESET)
/SPI.CLK: J1501.10, J1701.10, U1201.55 (SPI1_SCK)
/SPI.MISO: J1501.8, J1701.8, U1201.56 (SPI1_MISO)
/SPI.MOSI: J1501.9, J1701.9, U1201.57 (SPI1_MOSI)
GNDD: C203.2, C205.2, C401.2, C403.2, C404.2, C405.2, C406.2, C407.2, C408.2, C409.2, C410.2, C411.2, C412.2, C413.2, C414.2, C503.2, C504.2, C505.2, C506.2, C507.2, C508.2, C511.2, C512.2, C513.2, C514.2, C515.2, C516.2, C603.2, C605.2, C803.2, C805.2, C903.2, C905.2, C1003.2, C1005.2, C1101.2, C1201.2, C1202.2, C1203.2, C1204.2, C1205.2, C1206.2, C1207.2, C1301.2, C1302.2, C1303.2, C1401.2, C1603.2, C1604.2, C1605.2, C1608.2, C1609.2, C1610.2, C1611.2, C1612.2, C1613.2, C1614.2, C1615.2, C1616.2, C1617.2, C1803.2, C1805.2, D202.2 (A), D602.2 (A), D802.2 (A), D902.2 (A), D1002.2 (A), D1802.2 (A), J101.1, J102.2, J103.2, J1201.4 (GND), J1201.6 (GND), J1201.8 (GND), J1201.10 (GND), J1201.12 (GND), J1201.14 (GND), J1201.16 (GND), J1201.18 (GND), J1201.20 (GND), J1301.3, J1302.3, J1303.3, J1304.3, J1305.3, J1306.3, J1307.3, J1308.5 (GND), J1308.6 (Shield), J1501.12, J1501.13, J1701.12, J1701.13, L501.2, L1601.1, M1301.3 (-), Q202.2 (D), Q602.2 (D), Q802.2 (D), Q902.2 (D), Q1002.2 (D), Q1101.2 (S), Q1301.2 (S), Q1401.2 (S), Q1603.2 (S), Q1606.2 (S), Q1802.2 (D), R201.2, R202.2, R402.2, R406.1, R407.1, R409.2, R502.2, R504.2, R509.2, R601.2, R602.2, R801.2, R802.2, R901.2, R902.2, R1001.2, R1002.2, R1107.2, R1202.1, R1302.2, R1407.2, R1602.2, R1606.2, R1607.2, R1610.2, R1614.2, R1801.2, R1802.2, SW1201.1, U201.4 (GND), U201.9 (GND), U401.2 (V-), U402.1 (GND), U403.2 (GND), U501.14 (CSN), U501.19 (SYNC), U501.20 (GND), U501.21 (PAD), U601.4 (GND), U601.9 (GND), U801.4 (GND), U801.9 (GND), U901.4 (GND), U901.9 (GND), U1001.4 (GND), U1001.9 (GND), U1101.7 (GND), U1101.12, U1101.13, U1201.12 (VSSA), U1201.18 (VSS), U1201.31 (VSS), U1201.47 (VSS), U1201.63 (VSS), U1301.3 (GND), U1301.13 (GND), U1301.17 (GND), U1401.7 (GND), U1401.12, U1401.13, U1601.14 (CSN), U1601.19 (SYNC), U1601.20 (GND), U1601.21 (PAD), U1602.5 (GND), U1602.6 (NC), U1603.2 (V-), U1801.4 (GND), U1801.9 (GND)
IN: C1605.1, C1607.1, J102.1, R1601.2, R1613.1, R1616.1, U1601.6 (ISN), U1601.8 (BIAS), U1602.1 (IN), U1602.2 (IN)
unnamed: BZ1301.2 (-), Q1301.3 (D), R1301.2
unnamed: C414.1, D401.2 (A), R408.2, R409.1, U404.1 (ADJ)
unnamed: C411.1, D401.1 (K), JP401.3 (B), R408.1, U404.2 (VO)
unnamed: D1101.2 (A), R1101.2
unnamed: D1101.1 (K), D1102.1 (K), D1103.1 (K), D1104.1 (K), D1105.1 (K), D1106.1 (K), Q1101.3 (D)
unnamed: D1102.2 (A), R1102.2
unnamed: D1103.2 (A), R1103.2
unnamed: D1104.2 (A), R1104.2
unnamed: D1105.2 (A), R1105.2
unnamed: D1106.2 (A), R1106.2
unnamed: D1301.1 (K), R1305.1
unnamed: D1302.1 (K), R1306.1
unnamed: D1401.2 (A), R1401.2
unnamed: D1401.1 (K), D1402.1 (K), D1403.1 (K), D1404.1 (K), D1405.1 (K), D1406.1 (K), Q1401.3 (D)
unnamed: D1402.2 (A), R1402.2
unnamed: D1403.2 (A), R1403.2
unnamed: D1404.2 (A), R1404.2
unnamed: D1405.2 (A), R1405.2
unnamed: D1406.2 (A), R1406.2
unnamed: D1601.1 (K), D1602.1 (K), R1605.1, R1607.1
unnamed: D1603.2 (A), Q1604.4 (G), R1611.2
unnamed: D1603.1 (K), D1604.1 (K), Q1606.3 (D)
unnamed: D1604.2 (A), Q1605.4 (G), R1612.2
unnamed: C1301.1, J1308.3 (D+), R1304.2
unnamed: C1302.1, J1308.2 (D-), R1303.2
unnamed: J1308.1 (VBUS), U1301.10 (VCC)
unnamed: C514.1, JP501.1 (A), R508.1, U501.2 (V_{c})
unnamed: JP501.2 (B), RV501.1, RV501.2, TP501.1
unnamed: C516.1, JP502.1 (A), R508.2
unnamed: JP502.2 (B), RV501.3, TP502.1
unnamed: C1101.1, JP1101.1 (A), U1101.14 (VCC)
unnamed: JP1102.1 (A), U1101.8
unnamed: JP1103.1 (A), U1101.6
unnamed: JP1104.1 (A), U1101.3
unnamed: C1401.1, JP1401.1 (A), U1401.14 (VCC)
unnamed: JP1402.1 (A), U1401.8
unnamed: JP1403.1 (A), U1401.6
unnamed: JP1404.1 (A), U1401.3
unnamed: C1610.1, JP1601.1 (A), R1609.1, U1601.2 (V_{c})
unnamed: JP1601.2 (B), RV1601.1, RV1601.2, TP1601.1
unnamed: C1612.1, JP1602.1 (A), R1609.2
unnamed: JP1602.2 (B), RV1601.3, TP1602.1
unnamed: Q201.1 (G), U201.7 (GH)
unnamed: Q202.1 (G), U201.5 (GL)
unnamed: Q501.1 (G), U501.10 (TG)
unnamed: Q502.1 (G), U501.11 (BG)
unnamed: Q601.1 (G), U601.7 (GH)
unnamed: Q602.1 (G), U601.5 (GL)
unnamed: Q801.1 (G), U801.7 (GH)
unnamed: Q802.1 (G), U801.5 (GL)
unnamed: Q901.1 (G), U901.7 (GH)
unnamed: Q902.1 (G), U901.5 (GL)
unnamed: Q1001.1 (G), U1001.7 (GH)
unnamed: Q1002.1 (G), U1001.5 (GL)
unnamed: Q1601.1 (G), U1601.10 (TG)
unnamed: Q1602.1 (G), U1601.11 (BG)
unnamed: Q1603.3 (D), R1603.2, R1606.1, U1601.16 (EN/FBIN)
unnamed: Q1603.1 (G), R1605.2
unnamed: Q1801.1 (G), U1801.7 (GH)
unnamed: Q1802.1 (G), U1801.5 (GL)
unnamed: R507.2, R509.1
unnamed: R1604.1, R1616.2
unnamed: R1608.2, R1610.1
unnamed: C202.1, U201.8 (BST)
unnamed: C401.1, R401.2, R402.1, U401.3 (+)
unnamed: C402.1, U402.6 (BOOT)
unnamed: R403.1, R406.2, U402.5 (EN)
unnamed: R405.1, R407.2, U402.4 (FB)
unnamed: C409.1, R404.2, U403.4 (BP)
unnamed: R503.2, R504.1, U501.16 (EN/FBIN)
unnamed: R505.2, R506.1, U501.1 (FBX)
unnamed: C513.1, U501.5 (IMON)
unnamed: C511.1, U501.12 (INTV_{CC}), U501.17 (MODE)
unnamed: C510.2, U501.9 (INTV_{EE})
unnamed: R507.1, U501.18 (RT)
unnamed: C515.1, U501.3 (SS)
unnamed: C602.1, U601.8 (BST)
unnamed: C802.1, U801.8 (BST)
unnamed: C902.1, U901.8 (BST)
unnamed: C1002.1, U1001.8 (BST)
unnamed: R1202.2, U1201.60 (BOOT0)
unnamed: R1305.2, U1301.11 (CBUS1)
unnamed: R1306.2, U1301.5 (CBUS2)
unnamed: R1303.1, U1301.7 (USBDM)
unnamed: R1304.1, U1301.6 (USBDP)
unnamed: R1604.2, U1601.1 (FBX)
unnamed: C1609.1, U1601.5 (IMON)
unnamed: C1608.1, U1601.12 (INTV_{CC}), U1601.17 (MODE)
unnamed: C1607.2, U1601.9 (INTV_{EE})
unnamed: R1608.1, U1601.18 (RT)
unnamed: C1611.1, U1601.3 (SS)
unnamed: C1613.1, R1613.2, R1614.1, U1603.3 (+)
unnamed: C1802.1, U1801.8 (BST)
PGND: P1.1, P2.1, P3.1, P4.1
VCAP: C203.1, C403.1, C404.1, C412.1, C413.1, C508.1, C510.1, C603.1, C803.1, C903.1, C1003.1, C1603.1, C1604.1, C1614.1, C1615.1, C1616.1, C1617.1, C1803.1, D201.1 (K), D601.1 (K), D801.1 (K), D901.1 (K), D1001.1 (K), D1801.1 (K), J101.2, JP401.1 (A), L1601.2, Q201.3 (S), Q601.3 (S), Q801.3 (S), Q901.3 (S), Q1001.3 (S), Q1604.1 (S), Q1604.2 (S), Q1604.3 (S), Q1801.3 (S), R401.1, R403.2, R501.2, R505.1, R1603.1, R1611.1, U402.3 (VIN), U404.3 (VI), U501.6 (ISN), U501.8 (BIAS), U1601.13 (V_{IN})
V_{DRIVE}: BZ1301.1 (+), C205.1, C605.1, C805.1, C905.1, C1005.1, C1805.1, JP401.2 (C), R1301.1, U201.1 (VDD), U601.1 (VDD), U801.1 (VDD), U901.1 (VDD), U1001.1 (VDD), U1801.1 (VDD)
