suzizecat/defissolaire-v4/proto/power_supply/power_supply.kicad_pcb

## KiCad design proto/power_supply/power_supply.kicad_pcb (2023-04-03)

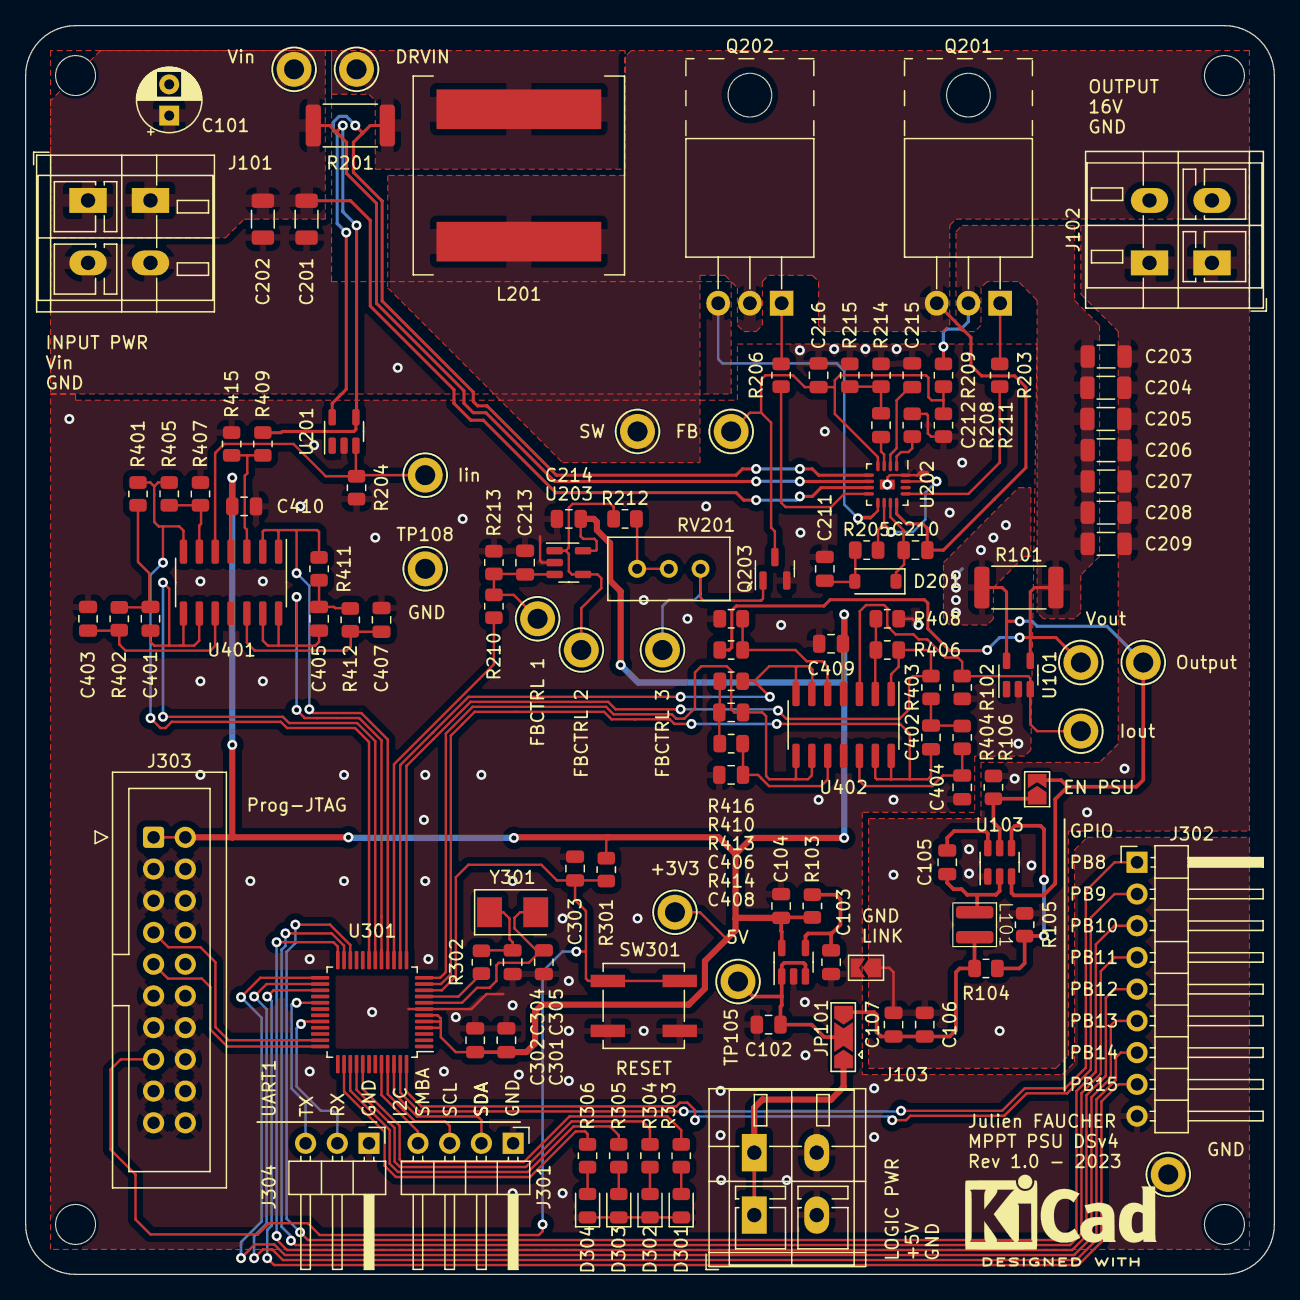
[picture p42: board power_supply.kicad_pcb from above]

Board: 4 copper layers, 100.0 x 100.0 mm, 130 parts (0 on the bottom side), 81 nets.

Parts:
C101: 47u; CP_Radial_D5.0mm_P2.50mm
C102, C104, C211: 1u; C_0805_2012Metric
C103: 10n; C_0805_2012Metric
C105, C213, C214, C215, C301, C302, C303, C409, C410: 100n; C_0805_2012Metric
C106, C107: 10u; C_0805_2012Metric
C201, C202, C203, C204, C205, C206, C207, C208, C209: 47u; C_1206_3216Metric
C210: 100n/16V; C_0805_2012Metric
C212: 47n; C_0805_2012Metric
C216: 15p; C_0805_2012Metric
C304, C305: C; C_0805_2012Metric
C401, C402, C403, C404, C405, C406, C407, C408: 100p; C_0805_2012Metric
D201: XBS104S14R-G; D_SOD-123
D301, D302, D303, D304: LED; LED_0805_2012Metric
H101, H102, H103, H104: M3; MountingHole_3.2mm_M3
J101, J102, J103: Conn_01x02; TerminalBlock_WAGO_236-402_1x02_P5.00mm_45Degree
J301: Conn_01x04; PinHeader_1x04_P2.54mm_Horizontal
J302: Conn_01x09; PinHeader_1x09_P2.54mm_Horizontal
J303: Conn_ARM_JTAG_SWD_20; IDC-Header_2x10_P2.54mm_Vertical
J304: Conn_01x03; PinHeader_1x03_P2.54mm_Horizontal
JP101: SolderJumper_3_Open; SolderJumper-3_P2.0mm_Open_TrianglePad1.0x1.5mm
JP102: EN DIG SUPPLY; SolderJumper-2_P1.3mm_Open_TrianglePad1.0x1.5mm
JP103: LINK_GND; SolderJumper-2_P1.3mm_Open_TrianglePad1.0x1.5mm
L101: 3.3u; VLS3015CX
L201: 22u; L_Coilcraft_XAL1510-223
Q201, Q202: TK4R3E06PL; TO-220-3_Horizontal_TabUp
Q203: BC846; SOT-23
R101, R201: 8m; R_2512_6332Metric
R102, R204, R209: 12k; R_0805_2012Metric
R103: NM; R_0805_2012Metric
R104: 22k; R_0805_2012Metric
R105: 3.3k; R_0805_2012Metric
R106, R210, R213, R301, R303, R304, R305, R306: 10k; R_0805_2012Metric
R203, R205, R206: 2; R_0805_2012Metric
R208: 470k; R_0805_2012Metric
R211: 1k8; R_0805_2012Metric
R212, R409, R410: 200k; R_0805_2012Metric
R214: 150k; R_0805_2012Metric
R215: 15k; R_0805_2012Metric
R302: 0; R_0805_2012Metric
R401, R402, R403, R404, R405, R406, R407, R408, R411, R412, R413, R414, R416: 33k; R_0805_2012Metric
R415: 100k; R_0805_2012Metric
RV201: 200k (0k); Potentiometer_Bourns_3296W_Vertical
SW301: SW_Push_Dual; SW_SPST_B3SL-1022P
TP101, TP102, TP105, TP106, TP107, TP108, TP201, TP202: TestPoint; TestPoint_Keystone_5010-5014_Multipurpose
TP103: V_{IIN}; TestPoint_Keystone_5010-5014_Multipurpose
TP104: V_{IOUT}; TestPoint_Keystone_5010-5014_Multipurpose
TP203: V_{SW}; TestPoint_Keystone_5010-5014_Multipurpose
TP204: V_{FB}; TestPoint_Keystone_5010-5014_Multipurpose
TP205: V_{CTRL}; TestPoint_Keystone_5010-5014_Multipurpose
TP206: V_{BJT}; TestPoint_Keystone_5010-5014_Multipurpose
TP207: R_{BJT}; TestPoint_Keystone_5010-5014_Multipurpose
U101, U201: ZXCT1110; SOT-23-5
U102: LDK130-33_SOT23_SOT353; SOT-23-5
U103: LMR51430; SOT-23-6
U202: TPS43060; QFN-16_EP_3x3_Pitch0.5mm
U203: TSV911xxLx; SOT-23-5
U301: STM32G051C6Tx; LQFP-48_7x7mm_P0.5mm
U401, U402: TSV914; SOIC-14_3.9x8.7mm_P1.27mm
Y301: 8MHz; Crystal_SMD_5032-2Pin_5.0x3.2mm

Connections:
+3.3V: C104.1, C214.1, C301.1, C302.1, C409.2, C410.2, J303.1 (VTREF), J303.2 (VCC/NC), R103.2, R301.1, TP106.1, U102.5 (OUT), U203.5 (V+), U301.4 (VBAT), U301.5 (VREF+), U301.6 (VDD), U401.4 (V+), U402.4 (V+)
/AlimCTRL: R210.1, U301.15 (DAC1_OUT1)
/Analog Interface/Iin: R204.1, TP103.1, U201.3 (OUT), U401.5 (+)
/Analog Interface/Iin_MEAS: R401.1, R405.2, U301.19 (ADC1_IN8), U401.7
/Analog Interface/Iin_filtered: C401.2, U301.18 (ADC1_IN7), U401.8, U401.9 (-)
/Analog Interface/Iout_MEAS: R403.1, R406.2, U301.13 (ADC1_IN2), U402.1
/Analog Interface/Iout_filtered: C402.2, U301.11 (ADC1_IN0), U402.13 (-), U402.14
/Analog Interface/Vin_MEAS: R411.1, U301.16 (ADC1_IN5), U401.1, U401.2 (-)
/Analog Interface/Vin_filtered: C405.2, U301.17 (ADC1_IN6), U401.13 (-), U401.14
/Analog Interface/Vout_MEAS: R413.1, U301.14 (ADC1_IN3), U402.6 (-), U402.7
/Analog Interface/Vout_filtered: C406.2, U301.12 (ADC1_IN1), U402.8, U402.9 (-)
/Control/I2C_SCL: J301.3, U301.45 (I2C1_SCL)
/Control/I2C_SDA: J301.2, U301.46 (I2C1_SDA)
/Control/I2C_SMBA: J301.4, U301.44 (I2C1_SMBA)
/Control/SWDCLK: J303.9 (TCK/SWDCLK), U301.36 (SYS_SWCLK)
/Control/SWDIO: J303.7 (TMS/SWDIO), U301.35 (SYS_SWDIO)
/Control/~RST: C303.1, J303.15 (~SRST), R301.2, SW301.2, U301.10 (~RST)
/Core/BST: C210.1, D201.1 (K), U202.11 (BOOT)
/Core/DRIVER_VCC: C211.1, D201.2 (A), R205.1
/Core/DRV_VIN: L201.1, R201.1, TP202.1, U201.5 (Vs-), U202.5 (ISNS-)
/Core/FB: C216.1, Q203.3 (C), R209.1, R211.2, TP204.1, U202.4 (FB)
/Core/SW: C210.2, L201.2, Q201.3 (S), Q202.2 (D), TP203.1, U202.12 (SW)
/Iout: R102.1, TP104.1, U101.3 (OUT), U402.3 (+)
/Output: J102.2, JP102.2 (B), R101.1, TP102.1, U101.5 (Vs-), U103.3 (VIN)
/Vin: C101.1, C201.1, C202.1, J101.1, R201.2, R409.1, TP201.1, U201.4 (Vs+), U202.6 (ISNS+), U202.7 (VIN)
/Vout: C203.1, C204.1, C205.1, C206.1, C207.1, C208.1, C209.1, Q201.2 (D), R101.2, R209.2, R410.1, TP101.1, U101.4 (Vs+)
GND: C101.2, C102.2, C103.2, C104.2, C106.2, C107.2, C201.2, C202.2, C203.2, C204.2, C205.2, C206.2, C207.2, C208.2, C209.2, C211.2, C213.2, C214.2, C215.2, C216.2, C301.2, C302.2, C303.2, C304.2, C305.2, C403.2, C404.2, C407.2, C408.2, C409.1, C410.1, D301.1 (K), D302.1 (K), D303.1 (K), D304.1 (K), J101.2, J102.1, J103.2, J301.1, J302.9, J303.3 (~TRST), J303.4 (GND), J303.5 (TDI), J303.6 (GND), J303.8 (GND), J303.10 (GND), J303.11 (RTCK), J303.12 (GND), J303.13 (TDO/SWO), J303.14 (GND), J303.16 (GND), J303.17 (DBGRQ/NC), J303.18 (GND), J303.19 (DBGACK/NC), J303.20 (GND), J304.1, JP103.1 (A), JP103.2 (B), Q202.3 (S), Q203.2 (E), R102.2, R105.1, R106.1, R204.2, R208.2, R211.1, R213.2, R214.2, R215.2, R407.1, R408.1, R415.2, R416.2, SW301.1, TP107.1, TP108.1, U101.2 (GND), U102.2 (GND), U103.1 (GND), U201.2 (GND), U202.9 (PGND), U202.16 (AGND), U202.17 (EP), U203.2 (V-), U301.7 (VSS), U401.11 (V-), U402.11 (V-)
unnamed: C212.2, R214.1, R215.1
unnamed: C304.1, R302.1, Y301.1
unnamed: C401.1, R401.2, R402.1
unnamed: C402.1, R403.2, R404.1
unnamed: C405.1, R411.2, R412.1
unnamed: C406.1, R413.2, R414.1
unnamed: D301.2 (A), R303.2
unnamed: D302.2 (A), R304.2
unnamed: D303.2 (A), R305.2
unnamed: D304.2 (A), R306.2
unnamed: J103.1, JP101.1 (A)
unnamed: J302.1, U301.47 (PB8)
unnamed: J302.2, U301.48 (PB9)
unnamed: J302.3, U301.22 (PB10)
unnamed: J302.4, U301.23 (PB11)
unnamed: J302.5, U301.24 (PB12)
unnamed: J302.6, U301.25 (PB13)
unnamed: J302.7, U301.26 (PB14)
unnamed: J302.8, U301.27 (PB15)
unnamed: J304.2, U301.32 (USART1_RX)
unnamed: J304.3, U301.29 (USART1_TX)
unnamed: C106.1, C107.1, JP101.3 (B), L101.2, R104.2
unnamed: C102.1, JP101.2 (C), TP105.1, U102.1 (IN), U102.3 (EN)
unnamed: JP102.1 (A), R106.2, U103.5 (EN)
unnamed: Q201.1 (G), R203.1
unnamed: Q202.1 (G), R206.2
unnamed: Q203.1 (B), RV201.1, TP206.1
unnamed: R212.2, RV201.2, RV201.3
unnamed: C103.1, R103.1, U102.4 (BP)
unnamed: C105.1, U103.6 (BOOT)
unnamed: R104.1, R105.2, U103.4 (FB)
unnamed: C105.2, L101.1, U103.2 (SW)
unnamed: C212.1, U202.3 (COMP)
unnamed: R205.2, U202.10 (VCC), U202.15 (EN)
unnamed: R203.2, U202.13 (HDRV)
unnamed: R206.1, U202.8 (LDRV)
unnamed: R208.1, U202.1 (RT)
unnamed: C215.1, U202.2 (SS)
unnamed: C213.1, R210.2, R213.1, TP205.1, U203.3 (+)
unnamed: R212.1, TP207.1, U203.1, U203.4 (-)
unnamed: R306.1, U301.38 (PD0)
unnamed: R305.1, U301.39 (PD1)
unnamed: R304.1, U301.40 (PD2)
unnamed: R303.1, U301.41 (PD3)
unnamed: C305.1, U301.8 (RCC_OSC_IN), Y301.2
unnamed: R302.2, U301.9 (RCC_OSC_OUT)
unnamed: R409.2, R415.1, U401.3 (+)
unnamed: R405.1, R407.2, U401.6 (-)
unnamed: C403.1, R402.2, U401.10 (+)
unnamed: C407.1, R412.2, U401.12 (+)
unnamed: R406.1, R408.2, U402.2 (-)
unnamed: R410.2, R416.1, U402.5 (+)
unnamed: C408.1, R414.2, U402.10 (+)
unnamed: C404.1, R404.2, U402.12 (+)
