suzizecat/defissolaire-v4/mapping/mapping.ioc

Mcu.UserName=STM32L476RGTx
PA0.Signal=S_TIM2_CH1
PA1.Signal=S_TIM2_CH2
PA10.Signal=S_TIM1_CH3
PA11.Signal=S_TIM1_CH4
PA2.Signal=USART2_TX
PA3.Signal=USART2_RX
PA4.Signal=ADCx_IN9
PA5.Signal=ADCx_IN10
PA6.Signal=S_TIM3_CH1
PA7.Signal=S_TIM3_CH2
PA8.Signal=S_TIM1_CH1
PA9.Signal=S_TIM1_CH2
PB0.Signal=ADCx_IN15
PB14.Signal=S_TIM15_CH1
PB15.Signal=S_TIM15_CH2
PB5.Signal=SPI1_MOSI
PB6.Signal=S_TIM4_CH1
PB7.Signal=S_TIM4_CH2
PC0.Signal=GPIO_Output
PC1.Signal=GPIO_Output
PC10.Signal=GPIO_Output
PC11.Signal=GPIO_Output
PC2.Signal=GPIO_Output
PC3.Signal=GPIO_Output
PC4.Signal=GPIO_Output
PC5.Signal=GPIO_Output
PC6.Signal=GPIO_Output
PC7.Signal=GPIO_Output
PC8.Signal=GPIO_Output
PC9.Signal=GPIO_Output
