suzizecat/defissolaire-v4/soft-vscode/DSv4/SooLRelease/core/src/GPIO.cpp

/**
 * Copyright (c) 2018-2019 FAUCHER Julien & FRANCE Loic
 * This file is part of SooL core Library.
 *
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
 *  You should have received a copy of the GNU Lesser General Public License
 *  along with SooL core Library. If not, see <https://www.gnu.org/licenses/>.
 */
#include "../include/GPIO.h"
#include "../include/RCC.h"

namespace sool
{
	namespace core
	{

#if defined(GPIO_MODER) && defined(GPIO_AFR)
		void GPIO::set_AF(const GPIO::Pin pins, const GPIO::AF af) volatile
		{
			MODER = (MODER & ~(pins * GPIO::Mode::Mask)) | (pins * GPIO::Mode::AlternateFunction);
			AFR = (AFR & ~(pins * GPIO::AF::Mask)) | (pins * af);
		}
#endif

		bool GPIO::set_locked(const GPIO::Pin pins, bool locked) volatile
		{
			LCKR = (1 << 15) | (static_cast<const uint32_t>(pins) & 0xF);
			LCKR = (0 << 15) | (static_cast<const uint32_t>(pins) & 0xF);
			LCKR = (1 << 15) | (static_cast<const uint32_t>(pins) & 0xF);
			(void) LCKR; //dummy read
			return LCKR.LCKK == 1U;
		}

#ifdef GPIOA_BASE_ADDR
		volatile StandAlone_Pin< 0>& PA0  = *reinterpret_cast<volatile StandAlone_Pin< 0>*>(GPIOA);
		volatile StandAlone_Pin< 1>& PA1  = *reinterpret_cast<volatile StandAlone_Pin< 1>*>(GPIOA);
		volatile StandAlone_Pin< 2>& PA2  = *reinterpret_cast<volatile StandAlone_Pin< 2>*>(GPIOA);
		volatile StandAlone_Pin< 3>& PA3  = *reinterpret_cast<volatile StandAlone_Pin< 3>*>(GPIOA);
		volatile StandAlone_Pin< 4>& PA4  = *reinterpret_cast<volatile StandAlone_Pin< 4>*>(GPIOA);
		volatile StandAlone_Pin< 5>& PA5  = *reinterpret_cast<volatile StandAlone_Pin< 5>*>(GPIOA);
		volatile StandAlone_Pin< 6>& PA6  = *reinterpret_cast<volatile StandAlone_Pin< 6>*>(GPIOA);
		volatile StandAlone_Pin< 7>& PA7  = *reinterpret_cast<volatile StandAlone_Pin< 7>*>(GPIOA);
		volatile StandAlone_Pin< 8>& PA8  = *reinterpret_cast<volatile StandAlone_Pin< 8>*>(GPIOA);
		volatile StandAlone_Pin< 9>& PA9  = *reinterpret_cast<volatile StandAlone_Pin< 9>*>(GPIOA);
		volatile StandAlone_Pin<10>& PA10 = *reinterpret_cast<volatile StandAlone_Pin<10>*>(GPIOA);
		volatile StandAlone_Pin<11>& PA11 = *reinterpret_cast<volatile StandAlone_Pin<11>*>(GPIOA);
		volatile StandAlone_Pin<12>& PA12 = *reinterpret_cast<volatile StandAlone_Pin<12>*>(GPIOA);
		volatile StandAlone_Pin<13>& PA13 = *reinterpret_cast<volatile StandAlone_Pin<13>*>(GPIOA);
		volatile StandAlone_Pin<14>& PA14 = *reinterpret_cast<volatile StandAlone_Pin<14>*>(GPIOA);
		volatile StandAlone_Pin<15>& PA15 = *reinterpret_cast<volatile StandAlone_Pin<15>*>(GPIOA);
#endif
#ifdef GPIOB_BASE_ADDR
		volatile StandAlone_Pin< 0>& PB0  = *reinterpret_cast<volatile StandAlone_Pin< 0>*>(GPIOB);
		volatile StandAlone_Pin< 1>& PB1  = *reinterpret_cast<volatile StandAlone_Pin< 1>*>(GPIOB);
		volatile StandAlone_Pin< 2>& PB2  = *reinterpret_cast<volatile StandAlone_Pin< 2>*>(GPIOB);
		volatile StandAlone_Pin< 3>& PB3  = *reinterpret_cast<volatile StandAlone_Pin< 3>*>(GPIOB);
		volatile StandAlone_Pin< 4>& PB4  = *reinterpret_cast<volatile StandAlone_Pin< 4>*>(GPIOB);
		volatile StandAlone_Pin< 5>& PB5  = *reinterpret_cast<volatile StandAlone_Pin< 5>*>(GPIOB);
		volatile StandAlone_Pin< 6>& PB6  = *reinterpret_cast<volatile StandAlone_Pin< 6>*>(GPIOB);
		volatile StandAlone_Pin< 7>& PB7  = *reinterpret_cast<volatile StandAlone_Pin< 7>*>(GPIOB);
		volatile StandAlone_Pin< 8>& PB8  = *reinterpret_cast<volatile StandAlone_Pin< 8>*>(GPIOB);
		volatile StandAlone_Pin< 9>& PB9  = *reinterpret_cast<volatile StandAlone_Pin< 9>*>(GPIOB);
		volatile StandAlone_Pin<10>& PB10 = *reinterpret_cast<volatile StandAlone_Pin<10>*>(GPIOB);
		volatile StandAlone_Pin<11>& PB11 = *reinterpret_cast<volatile StandAlone_Pin<11>*>(GPIOB);
		volatile StandAlone_Pin<12>& PB12 = *reinterpret_cast<volatile StandAlone_Pin<12>*>(GPIOB);
		volatile StandAlone_Pin<13>& PB13 = *reinterpret_cast<volatile StandAlone_Pin<13>*>(GPIOB);
		volatile StandAlone_Pin<14>& PB14 = *reinterpret_cast<volatile StandAlone_Pin<14>*>(GPIOB);
		volatile StandAlone_Pin<15>& PB15 = *reinterpret_cast<volatile StandAlone_Pin<15>*>(GPIOB);
#endif
#ifdef GPIOC_BASE_ADDR
		volatile StandAlone_Pin< 0>& PC0  = *reinterpret_cast<volatile StandAlone_Pin< 0>*>(GPIOC);
		volatile StandAlone_Pin< 1>& PC1  = *reinterpret_cast<volatile StandAlone_Pin< 1>*>(GPIOC);
		volatile StandAlone_Pin< 2>& PC2  = *reinterpret_cast<volatile StandAlone_Pin< 2>*>(GPIOC);
		volatile StandAlone_Pin< 3>& PC3  = *reinterpret_cast<volatile StandAlone_Pin< 3>*>(GPIOC);
		volatile StandAlone_Pin< 4>& PC4  = *reinterpret_cast<volatile StandAlone_Pin< 4>*>(GPIOC);
		volatile StandAlone_Pin< 5>& PC5  = *reinterpret_cast<volatile StandAlone_Pin< 5>*>(GPIOC);
		volatile StandAlone_Pin< 6>& PC6  = *reinterpret_cast<volatile StandAlone_Pin< 6>*>(GPIOC);
		volatile StandAlone_Pin< 7>& PC7  = *reinterpret_cast<volatile StandAlone_Pin< 7>*>(GPIOC);
		volatile StandAlone_Pin< 8>& PC8  = *reinterpret_cast<volatile StandAlone_Pin< 8>*>(GPIOC);
		volatile StandAlone_Pin< 9>& PC9  = *reinterpret_cast<volatile StandAlone_Pin< 9>*>(GPIOC);
		volatile StandAlone_Pin<10>& PC10 = *reinterpret_cast<volatile StandAlone_Pin<10>*>(GPIOC);
		volatile StandAlone_Pin<11>& PC11 = *reinterpret_cast<volatile StandAlone_Pin<11>*>(GPIOC);
		volatile StandAlone_Pin<12>& PC12 = *reinterpret_cast<volatile StandAlone_Pin<12>*>(GPIOC);
		volatile StandAlone_Pin<13>& PC13 = *reinterpret_cast<volatile StandAlone_Pin<13>*>(GPIOC);
		volatile StandAlone_Pin<14>& PC14 = *reinterpret_cast<volatile StandAlone_Pin<14>*>(GPIOC);
		volatile StandAlone_Pin<15>& PC15 = *reinterpret_cast<volatile StandAlone_Pin<15>*>(GPIOC);
#endif
#ifdef GPIOD_BASE_ADDR
		volatile StandAlone_Pin< 0>& PD0  = *reinterpret_cast<volatile StandAlone_Pin< 0>*>(GPIOD);
		volatile StandAlone_Pin< 1>& PD1  = *reinterpret_cast<volatile StandAlone_Pin< 1>*>(GPIOD);
		volatile StandAlone_Pin< 2>& PD2  = *reinterpret_cast<volatile StandAlone_Pin< 2>*>(GPIOD);
		volatile StandAlone_Pin< 3>& PD3  = *reinterpret_cast<volatile StandAlone_Pin< 3>*>(GPIOD);
		volatile StandAlone_Pin< 4>& PD4  = *reinterpret_cast<volatile StandAlone_Pin< 4>*>(GPIOD);
		volatile StandAlone_Pin< 5>& PD5  = *reinterpret_cast<volatile StandAlone_Pin< 5>*>(GPIOD);
		volatile StandAlone_Pin< 6>& PD6  = *reinterpret_cast<volatile StandAlone_Pin< 6>*>(GPIOD);
		volatile StandAlone_Pin< 7>& PD7  = *reinterpret_cast<volatile StandAlone_Pin< 7>*>(GPIOD);
		volatile StandAlone_Pin< 8>& PD8  = *reinterpret_cast<volatile StandAlone_Pin< 8>*>(GPIOD);
		volatile StandAlone_Pin< 9>& PD9  = *reinterpret_cast<volatile StandAlone_Pin< 9>*>(GPIOD);
		volatile StandAlone_Pin<10>& PD10 = *reinterpret_cast<volatile StandAlone_Pin<10>*>(GPIOD);
		volatile StandAlone_Pin<11>& PD11 = *reinterpret_cast<volatile StandAlone_Pin<11>*>(GPIOD);
		volatile StandAlone_Pin<12>& PD12 = *reinterpret_cast<volatile StandAlone_Pin<12>*>(GPIOD);
		volatile StandAlone_Pin<13>& PD13 = *reinterpret_cast<volatile StandAlone_Pin<13>*>(GPIOD);
		volatile StandAlone_Pin<14>& PD14 = *reinterpret_cast<volatile StandAlone_Pin<14>*>(GPIOD);
		volatile StandAlone_Pin<15>& PD15 = *reinterpret_cast<volatile StandAlone_Pin<15>*>(GPIOD);
#endif
#ifdef GPIOE_BASE_ADDR
		volatile StandAlone_Pin< 0>& PE0  = *reinterpret_cast<volatile StandAlone_Pin< 0>*>(GPIOE);
		volatile StandAlone_Pin< 1>& PE1  = *reinterpret_cast<volatile StandAlone_Pin< 1>*>(GPIOE);
		volatile StandAlone_Pin< 2>& PE2  = *reinterpret_cast<volatile StandAlone_Pin< 2>*>(GPIOE);
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
		volatile StandAlone_Pin<13>& PK13 = *reinterpret_cast<volatile StandAlone_Pin<13>*>(GPIOK);
		volatile StandAlone_Pin<14>& PK14 = *reinterpret_cast<volatile StandAlone_Pin<14>*>(GPIOK);
		volatile StandAlone_Pin<15>& PK15 = *reinterpret_cast<volatile StandAlone_Pin<15>*>(GPIOK);
#endif
	}
}
