suzizecat/defissolaire-v4/soft-vscode/DSv4/SooLRelease/core/src/ADC.cpp

/**
 * Copyright (c) 2018-2019 FAUCHER Julien & FRANCE Loic
 * This file is part of SooL core Library.
 *
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
 *  You should have received a copy of the GNU Lesser General Public License
 *  along with SooL core Library. If not, see <https://www.gnu.org/licenses/>.
 */
#include "../include/ADC.h"
#include "../include/RCC.h"

namespace sool
{
	namespace core
	{
		void ADC::set_sequence_value(const unsigned int position, const unsigned int channel) volatile
		{
			switch (position) {
#ifdef ADC_SQR1_1
				case 1 :
							SQR1.SQ1 = channel;
							break;
						case 2:
							SQR1.SQ2 = channel;
							break;
						case 3:
							SQR1.SQ3 = channel;
							break;
						case 4:
							SQR1.SQ4 = channel;
							break;
#endif
#ifdef ADC_SQR2_1

				case 5:
					SQR2.SQ5 = channel;
					break;
				case 6:
					SQR2.SQ6 = channel;
					break;
				case 7:
					SQR2.SQ7 = channel;
					break;
				case 8:
					SQR2.SQ8 = channel;
					break;
				case 9:
					SQR2.SQ9 = channel;
					break;
#endif
#ifdef ADC_SQR3_1
				case 10:
					SQR3.SQ10 = channel;
					break;
				case 11:
					SQR3.SQ11= channel;
					break;
				case 12:
					SQR3.SQ12= channel;
					break;
				case 13:
					SQR3.SQ13= channel;
					break;
				case 14:
					SQR3.SQ14= channel;
					break;
				//Linked to ADC_SQR3_1
				case 15:
					SQR4.SQ15= channel;
					break;
				case 16:
					SQR4.SQ16= channel;
					break;
#endif
#ifdef ADC_SQR3_0
				case 1:
							SQR3.SQ1 = channel;
							break;
						case 2:
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
        defined(STM32L162xCA) || defined(STM32L162xD ) || defined(STM32L162xDx) || defined(STM32L162xE )
				case 28:
							SQR1.SQ28 = channel;
							break;
#endif
				default:
					//If the soft reach here, it is an error
					return;
			}
		}
	}
}
