suzizecat/defissolaire-v4/(commit log)

2023-01-06 [ALIM] Update base alims
    [ltc3350_psu.kicad_sch, psu_ltc3350.kicad_sch]
2023-03-14 Global alimentation update
    [analog.kicad_sch, control.kicad_sch, power_supply.kicad_pcb, power_supply.kicad_sch, power_supply_core_tps43060.kicad_sch]
2023-03-24 Add maths for gate drive
    [power_supply_core_tps43060.kicad_sch]
2023-03-27 Finish alim sch, start PCB
    [analog.kicad_sch, control.kicad_sch, power_supply.kicad_pcb, power_supply.kicad_sch, power_supply_core_tps43060.kicad_sch]
2023-03-27 Update PCB
    [power_supply.kicad_pcb, power_supply_core_tps43060.kicad_sch]
2023-03-29 Finish first routing
    [analog.kicad_sch, power_supply.kicad_pcb, power_supply_core_tps43060.kicad_sch]
2023-03-29 Update planes and fix DRC
    [power_supply.kicad_pcb]
2023-03-29 Improve overall
    [236-402.stp, RTE0016E.stp, control.kicad_sch, power_supply.kicad_pcb, power_supply.kicad_sch]
2023-03-31 Update with additional PSU from output
    [control.kicad_sch, power_supply.kicad_pcb, power_supply.kicad_sch]
2023-04-03 Document PCB
    [power_supply.kicad_pcb]
2023-04-03 Final edit before v1 release
    [control.kicad_sch, power_supply.kicad_pcb, power_supply.kicad_sch]
2023-04-08 Update for BOM
    [analog.kicad_sch, control.kicad_sch, power_supply.kicad_sch, power_supply_core_tps43060.kicad_sch]
2023-04-18 [PCB] Elaborate BOM
    [analog.kicad_sch, bom.csv, bom_20230414.csv, bom_easii.csv, control.kicad_sch, power_supply.kicad_sch, power_supply_core_tps43060.kicad_sch]
2023-06-06 Start overall new board
    [MCU.kicad_sch, analog.kicad_sch, boost.kicad_sch, communication.kicad_sch, control.kicad_sch, defis_solaires_v4.kicad_pcb, defis_solaires_v4.kicad_sch, driver_motor.kicad_sch]
2023-06-06 Update overall power scheme
2023-11-22 Start design of new PSU
    [dsv4.kicad_sch, mot_driver.kicad_sch, phase_driver.kicad_sch, power_supply_core.kicad_sch, power_supply_core_lt8710.kicad_sch, psu.kicad_sch, psu_lt8710.ods]
2023-11-22 Update components values
    [power_supply_core_lt8710.kicad_sch, psu_lt8710.ods]
2023-11-24 [PSU] Compute values for LT8710 PSU
    [dsv4.kicad_sch, mot_driver.kicad_sch, phase_driver.kicad_sch, power_supply_core.kicad_sch, power_supply_core_lt8710.kicad_sch, psu.kicad_sch, psu_lt8710.ods]
2023-11-25 Fix permission (NTFS)
    [236-402.stp, CSD25404Q3.OLB, RTE0016E.stp, TPS61178RNW_TRANS.OLB, TPS61178_TRANS.OPJ, analog.kicad_sch, bom.csv, bom_20230414.csv]
2024-02-19 PSU should be OK
    [dsv4.kicad_sch, mot_driver.kicad_sch, phase_driver.kicad_sch, power_supply_core_lt8710.kicad_sch, psu.kicad_sch]
2024-03-08 Update schematics
    [dsv4.kicad_sch, mcu.kicad_sch, mot_ctrl_bus_mgmt.kicad_sch, mot_driver.kicad_sch, phase_driver.kicad_sch, psu.kicad_sch, psu_lt8710.ods, radio_misc.kicad_sch]
2024-04-02 Some work
    [battery_charger.kicad_sch, dsv4.kicad_sch, mcu.kicad_sch, mot_ctrl_bus_mgmt.kicad_sch, mot_driver.kicad_sch, phase_driver.kicad_sch, psu.kicad_sch, radio_misc.kicad_sch]
2024-04-09 Update, with FTDI, mostly OK
    [dsv4.kicad_sch, mcu.kicad_sch, mot_connector.kicad_sch, radio_misc.kicad_sch]
2024-04-11 Finalize schema for bat charger
    [battery_charger.kicad_sch, dsv4.kicad_sch, mcu.kicad_sch, psu.kicad_sch, radio_misc.kicad_sch]
2024-04-12 Finalize sch and start component mapping
    [battery_charger.kicad_sch, dsv4.kicad_sch, mcu.kicad_sch, mot_connector.kicad_sch, mot_ctrl_bus_mgmt.kicad_sch, mot_driver.kicad_sch, phase_driver.kicad_sch, power_supply_core_lt8710.kicad_sch]
2024-04-16 update BOM
    [battery_charger.kicad_sch, dsv4.kicad_sch, mcu.kicad_sch, mot_connector.kicad_sch, mot_ctrl_bus_mgmt.kicad_sch, power_supply_core_lt8710.kicad_sch, psu.kicad_sch, radio_misc.kicad_sch]
2024-04-16 BOM OK
    [battery_charger.kicad_sch, dsv4.kicad_pcb, dsv4.kicad_sch, mcu.kicad_sch, mot_connector.kicad_sch, mot_ctrl_bus_mgmt.kicad_sch, phase_driver.kicad_sch, power_supply_core_lt8710.kicad_sch]
2024-04-17 Start route PCB
    [battery_charger.kicad_sch, dsv4.kicad_pcb, dsv4.kicad_sch, mcu.kicad_sch, mot_connector.kicad_sch, mot_ctrl_bus_mgmt.kicad_sch, phase_driver.kicad_sch, power_supply_core_lt8710.kicad_sch]
2024-04-19 Route of power rails
    [battery_charger.kicad_sch, dsv4.kicad_pcb, dsv4.kicad_sch, mcu.kicad_sch, phase_driver.kicad_sch, psu.kicad_sch]
2024-04-21 Power routed
    [battery_charger.kicad_sch, dsv4.kicad_pcb, dsv4.kicad_sch, mcu.kicad_sch, mot_connector.kicad_sch, mot_ctrl_bus_mgmt.kicad_sch, mot_driver.kicad_sch, phase_driver.kicad_sch]
2024-04-23 Start re-doing routing
    [battery_charger.kicad_sch, dsv4.kicad_pcb, dsv4.kicad_sch, mcu.kicad_sch, mot_connector.kicad_sch, mot_ctrl_bus_mgmt.kicad_sch, power_supply_core_lt8710.kicad_sch, radio_misc.kicad_sch]
2024-04-23 Rework north route
    [battery_charger.kicad_sch, dsv4.kicad_pcb, mcu.kicad_sch, mot_connector.kicad_sch, mot_ctrl_bus_mgmt.kicad_sch, phase_driver.kicad_sch, power_supply_core_lt8710.kicad_sch, psu.kicad_sch]
2024-04-23 Finished redoing power routing
    [battery_charger.kicad_sch, mcu.kicad_sch, mot_connector.kicad_sch, mot_ctrl_bus_mgmt.kicad_sch, power_supply_core_lt8710.kicad_sch, psu.kicad_sch, radio_misc.kicad_sch]
2024-04-24 More routing
    [battery_charger.kicad_sch, mcu.kicad_sch, psu.kicad_sch]
2024-04-25 Routing done.
    [battery_charger.kicad_sch, mcu.kicad_sch, mot_connector.kicad_sch, mot_ctrl_bus_mgmt.kicad_sch, power_supply_core_lt8710.kicad_sch, radio_misc.kicad_sch]
2024-04-25 WIP cleanup silkscreen
    Pre-page numbering
2024-04-25 Clean silkscreen
    [Coilcraft-MSD1260T.step, PKLCS1212E4001-R1--3DModel-STEP-56544.STEP, battery_charger.kicad_sch, dsv4.kicad_sch, mcu.kicad_sch, mot_connector.kicad_sch, mot_ctrl_bus_mgmt.kicad_sch, mot_driver.kicad_sch]
2024-04-29 Sent to fab
    [Coilcraft-MSD1260T.step, PKLCS1212E4001-R1--3DModel-STEP-56544.STEP, battery_charger.kicad_sch, dsv4.kicad_sch, mcu.kicad_sch, mot_connector.kicad_sch, mot_ctrl_bus_mgmt.kicad_sch, phase_driver.kicad_sch]
2024-04-29 BOM almost OK, starts new side board.
    [battery_charger.kicad_sch, dsv4.kicad_sch, mcu.kicad_sch, mot_connector.kicad_sch, mot_ctrl_bus_mgmt.kicad_sch, mot_driver.kicad_sch, phase_driver.kicad_sch, power_supply_core_lt8710.kicad_sch]
2024-04-30 Revised with BOM ordered
    [JFAR-BOM-DSv4.xlsx, battery_charger.kicad_sch, mcu.kicad_sch, mot_connector.kicad_sch, mot_ctrl_bus_mgmt.kicad_sch, phase_driver.kicad_sch, power_supply_core_lt8710.kicad_sch, psu.kicad_sch]
2024-05-11 Start soft with vscode and STM32 extension
    [power_supply_core_lt8710.kicad_sch, side_main_psu.kicad_pcb, side_main_psu.kicad_sch]
