suzizecat/defissolaire-v4/(notices)

Notices in the files:
soft-vscode/DSv4/SooLRelease/core/include/DMA2D.h:
SooL core Library is free software: you can redistribute it and/or modify
it under the terms of the GNU Lesser General Public License
librairies/3d/236-402.stp:
author */ ('License CC BY-ND 4.0'),
